ariel-bentu/alarmSystem/docs/superpowers/plans/2026-08-19-local-web-server.md

# Local Web Server (Arm/Disarm + Sensor Simulator) Implementation Plan

> **For agentic workers:** REQUIRED SUB-SKILL: Use superpowers:subagent-driven-development (recommended) or superpowers:executing-plans to implement this plan task-by-task. Steps use checkbox (`- [ ]`) syntax for tracking.

**Goal:** Add a LAN-reachable local web server (`http://local.alarm`, no auth)
that lets a user arm/disarm the device and simulate a sensor RF trigger
without WiFi internet access or CC1101 hardware, running during normal
operation (not just AP-provisioning mode), toggleable via a new
EEPROM-persisted flag that defaults on.

**Architecture:** New `LocalWebServer` class (`ESP8266WebServer` +
`ESP8266mDNS`), mirroring the existing `ProvisioningPortal`/`setup_page.h`
pattern but running in STA mode alongside normal operation. The simulate-
trigger endpoint calls a new shared `handleSensorEvent()` function extracted
from `main.cpp`'s existing CC1101-decode path, so simulated triggers exercise
the exact same `AlarmState` → `RelaySiren` → `CloudClient::reportEvent`
pipeline a real RF packet would. `EepromStore`'s persisted blob gains a
`localWebEnabled` bool alongside `armed`/`Config`; the magic number bumps
since this is a breaking format change (acceptable — no device is
provisioned yet).
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
