ariel-bentu/alarmSystem/firmware/edge/device/src/main.cpp

#include <Arduino.h>
#include <time.h>

#include "platform_compat.h"

#include "alarm_state.h"
#include "camera_client.h"
#include "camera_gate.h"
#include "cc1101_receiver.h"
#include "cloud_client.h"
#include "eeprom_store.h"
#include "fw_version.h"
#include "kerui_event.h"
#include "local_web_server.h"
#include "ota_updater.h"
#include "provision_store.h"
#include "provisioning_portal.h"
#include "remote_control.h"
#include "siren_address.h"
#include "relay_siren.h"
#include "stall_monitor.h"

#ifndef FIREBASE_WEB_API_KEY
#define FIREBASE_WEB_API_KEY "REPLACE_WITH_PROJECT_WEB_API_KEY"
#endif

namespace {
const uint8_t kForcePortalPin = 0;  // GPIO0 / FLASH button
const unsigned long kWifiConnectTimeoutMs = 15000;

ProvisionStore provisionStore;
ProvisioningPortal portal;
bool portalActive = false;

// Pin map. The two targets share no numbering, so keep them apart.
//
// ESP32-S3 (esp32-s3-devkitc-1, probed: quad SPI flash + embedded 8MB
// PSRAM). Pins avoided and why:
//   - GPIO26-32  : reserved for the SPI flash / PSRAM bus. Using them
//                  breaks the board in ways that look like random crashes.
//   - GPIO33-37  : left alone too. Free on a quad part, but taken by an
//                  octal PSRAM bus, and this module has embedded PSRAM
//                  whose wiring is not exposed — not worth the risk.
//   - GPIO0      : BOOT strapping pin, already used for kForcePortalPin.
//   - GPIO3,45,46: strapping (JTAG source / VDD_SPI / boot mode).
//   - GPIO19,20  : native USB D-/D+, which is our serial console.
//   - GPIO43,44  : UART0 TX/RX.
//   - GPIO35,36,37 on some N8R8 modules are consumed by PSRAM — see above.
//
// Hardware SPI (FSPI) defaults on this variant: SCK 12, MISO 13, MOSI 11.
// Those are wired to the CC1101 as SCK/SO/SI and are NOT configurable
// here — SPI.begin() claims them. Only CS and GDO0 are chosen below, from
// the safe low bank.
#if defined(ARDUINO_ARCH_ESP32)
const uint8_t kCc1101CsPin = 10;    // FSPI default SS
const uint8_t kCc1101Gdo0Pin = 4;   // any free digital input
const uint8_t kRelayPin = 5;        // free digital output
#else
const uint8_t kCc1101CsPin = 15;    // D8 — confirm against final wiring during hardware bring-up
const uint8_t kCc1101Gdo0Pin = 4;   // D2 — confirm against final wiring during hardware bring-up
const uint8_t kRelayPin = 5;        // D1 — confirm against final wiring during hardware bring-up
#endif

EepromStore eepromStore;
AlarmState alarmState;
Cc1101Receiver cc1101;
RelaySiren siren;
CloudClient cloudClient;
OtaUpdater otaUpdater;
// The outcome of an update installed before this boot ("ok" / "rolled_back")
// is reported once the cloud is reachable — see handleOta().
bool otaOutcomeReported = false;
uint8_t otaLastReportedPct = 0;
LocalWebServer localWebServer;

bool armed = false;
bool localWebEnabled = true;
Config config;

// Per-family snapshot-capture cooldown (CameraGate::shouldCapture's
// lastCaptureMs). RAM only, deliberately: "survives nothing" is correct — a
// reboot should allow an immediate capture, not inherit a stale cooldown
// from before the restart. Indexed by the sensor's position in
// config.sensors[], which has up to 16 entries (Config::sensors). 0 means
// "never captured", matching CameraGate::shouldCapture's own sentinel.
uint32_t lastCaptureMs[16] = {};

// Which input last changed the arm state, reported to state/armed_by so the
// Telegram alert can name it ("remote" vs "local" vs "cloud"). A fixed-code
// remote is replayable, so attribution is the only available mitigation —
// see the design doc's Security section.
const char* armedBySource = "cloud";

// Backing store for the "remote:XXXXX" form of the above, which names WHICH
// remote rather than just "a remote". The cloud resolves the identity to the
// remote's user-given name (parseArmSource in deviceArmNotify.ts); the device
// deliberately does not know names, so renaming one needs no device round-trip
// and the thin RTDB config stays unchanged.
//
// File-scope, not a local: armedBySource is a BORROWED pointer that
// applyArmedCommand() dereferences after handleRemotePacket() has returned,
// so a stack buffer here would dangle. 20 bytes covers "remote:" + 5 hex
// digits + NUL with room to spare.
char remoteArmedBySource[20];

// Non-blocking remote pairing window; 0 = closed. Deliberately NOT modelled
// on runSirenPairing(), which blocks the loop for 10s and leaves the alarm
// deaf to sensors. Remote pairing is receive-only, so it needs no blocking
// at all: it is a deadline checked inside the packet path.
unsigned long remotePairUntilMs = 0;
constexpr unsigned long kRemotePairWindowMs = 30000UL;

// mDNS and configTime()'s SNTP setup are both deferred until the first
// mint attempt settles. Two theories motivated this originally (DNS
// contention, then heap headroom) and BOTH were wrong — the mint crash was
// cont-stack exhaustion, fixed by the noinline attributes above. Kept
// anyway: both allocate, and there is no reason to do that work before the
// device has authenticated. LAN arm/disarm-by-IP works from boot
// regardless, since the web server itself is unaffected.
bool mdnsStarted = false;
unsigned long normalOperationStartMs = 0;
constexpr unsigned long kDnsUsersStartFallbackMs = 60000UL;  // start anyway if cloud never comes up

// Reported once per boot, strictly after the cloud is actually ready (not
// merely "settled" — that fallback also fires if the cloud never comes up,
// in which case there is nothing to report to). A later Cloud Function
// reads this to show the address in the web UI. Kept out-of-line and
// gated by a bool so it costs nothing on the other ~thousands of loop()
// iterations per boot — see handleSensorEvent()'s note on why frame size
// in loop() matters on this hardware.
bool sirenAddressReported = false;
// Retry pacing for the siren-address report. It is only latched on a
// CONFIRMED write (see reportSirenAddressOnce), so a device that is
// momentarily too low on contiguous heap tries again rather than giving up —
// but at this interval, not on every loop iteration.
unsigned long lastSirenAddressReportMs = 0;
static constexpr unsigned long kSirenAddressRetryMs = 60000UL;
// True between reporting an alarm to the cloud and clearing state/siren_active
// again. See the falling-edge clear in loop().
bool alarmReportedToCloud = false;

// Identity of the trigger CURRENTLY sustaining the siren, for matching the
// cloud's false-positive advisory (/commands/fp = {rfId, ts}).
//
// AlarmState::TriggerCause (alarm_state.h) only stores the 20-bit FAMILY and
// no timestamp at all, so it cannot be compared against the advisory, which
// is keyed by the FULL 24-bit rfId and an epoch-ms ts — the same {rfId, ts}
// used for the /events key and the snapshot upload path. This is why that
// identity is captured separately, here, at the moment the siren is turned
// on for a sensor trigger (handleSensorEvent) rather than read back out of
// AlarmState.
//
// Empty rfId means "no active trigger to match" — cleared whenever the siren
// goes idle (loop()'s falling edge) and whenever an advisory consumes it, so
// a stale identity can never be matched against a LATER, unrelated alarm.
char activeAlarmRfId[11] = {};
uint64_t activeAlarmTs = 0;

// Identity of the most recent ARMED trigger, whether or not it alarmed.
//
// Distinct from activeAlarmRfId/activeAlarmTs above, which are only set when a
// siren activation actually STARTED. A breach advisory arrives precisely when
// no alarm fired — the cloud's judge is what decided there should be one — so
// it has no active alarm to match against and needs this instead.
//
// RAM only, like lastCaptureMs[]: "survives nothing" is correct, because a
// reboot means there is no in-flight trigger for an advisory to confirm.
char lastTriggerRfId[11] = {};
uint64_t lastTriggerTs = 0;

// A siren DEFERRED by Config::sirenHoldSec, waiting for the cloud's AI judge
// to rule the trigger a false positive before it sounds.
//
// Only ever set for a sensor whose SensorConfig::definiteBreach is false. The
// identity above is populated at the same moment, so the existing
// false-positive advisory match cancels a pending siren exactly as it stops a
// sounding one — the advisory path needs no new matching logic.
//
// 0 means "nothing pending". Deliberately a millis() deadline rather than a
// countdown: tickPendingSiren() is called from loop() and must not depend on
// how often that happens.
//
// IT EXPIRES AND FIRES. Everything that can go wrong cloud-side (offline,
// NVR down, judge error, lost upload) ends with the siren sounding late
// rather than never — see Config::sirenHoldSec.
unsigned long pendingSirenDeadlineMs = 0;
unsigned long lastHeartbeatMs = 0;
static constexpr unsigned long kHeartbeatIntervalMs = 10000UL;

// Watchdog budget. Must exceed the longest LEGITIMATE blocking stretch in
// the firmware, or a healthy device reboots itself: connectToWifi() 15s,
// the mint response wait 15s, runSirenPairing() 10s. Those all call
// platformFeedWatchdog() as they go, so the real requirement is just that
// this comfortably exceeds one loop() iteration.
//
// RAISED 30 -> 60. The binding stretch is NOT any of the above: it is the
// synchronous FirebaseClient poll/write inside cloudClient.loop(), which
// blocks WITHOUT feeding the watchdog (its internal wait calls delay(0),
// which yields to FreeRTOS but does not reset the TWDT). That is now capped
// at CloudClient::kSyncTimeoutSec — see the long note there.
//
// At 30s this constant EQUALED the library's own default socket timeout, so
// a single stalled poll could burn the whole budget and reboot a healthy
// device. The budget must clear the worst legitimate case, which is
// reportAlarm(): TWO sequential blocking set() calls, i.e. 2x kSyncTimeoutSec
// plus the surrounding loop work. 60s leaves ample margin while still
// catching a genuine hang within a minute.
static constexpr uint32_t kWatchdogTimeoutSec = 60;

// Boot cause is reported once, after the cloud comes up. Same gating shape
// as sirenAddressReported — strictly isReady(), since there is nothing to
// report to otherwise.
bool bootReported = false;

// Steady-state WiFi supervision. setup() connects, but until now NOTHING
// re-checked the link afterwards: loop() trusted WiFi.setAutoReconnect(true)
// with no fallback, so a device whose auto-reconnect failed to re-associate
// stayed silently offline until a human noticed. The alarm itself keeps
// working (siren, EEPROM, LAN are all local), but remote arm/disarm and
// every cloud alert are gone, which is a large silent failure.
unsigned long lastWifiCheckMs = 0;
static constexpr unsigned long kWifiCheckIntervalMs = 30000UL;
// Grace period before intervening. WiFi.begin() is asynchronous and the SDK
// does its own reconnect attempts; reconnecting on the first missed check
// would fight it and could thrash the radio.
unsigned long wifiDownSinceMs = 0;
static constexpr unsigned long kWifiDownGraceMs = 120000UL;

// When to give up nudging and reboot. TWO HOURS, deliberately — this is NOT
// a "connectivity is broken, restart it" timer.
//
// An offline device still fully protects the premises: RF decode, rule
// evaluation, the siren and EEPROM arm state are all local and cloud-
// independent by design (see CLAUDE.md's Key Decisions). A router reboot,
// an ISP outage or a moved AP must NOT cost anything, and a reboot is
// strictly worse than staying up — every restart is a window in which no
// sensor is being watched at all, and a short timer during a long outage
// turns that into a loop.
//
// So the reboot exists only for the case a nudge cannot fix: a wedged radio
// or a driver stuck past any plausible outage. At 2h the local alarm has had
// every chance to keep working, and the one-off ~15s restart is a fair price
// for recovering a device that would otherwise stay offline indefinitely.
static constexpr unsigned long kWifiDownRebootMs = 2UL * 60UL * 60UL * 1000UL;

__attribute__((noinline))
void reportSirenAddressOnce() {
  char addrHex[9];
  // "0x%06X" — upper-case and zero-padded to six digits. This EXACT form is
  // what onSirenAddress stores in Firestore (canonicalSirenAddress produces
  // the same string), so a re-report on the next boot compares equal and
  // does not rewrite the project doc. Changing this format would make every
  // reboot trigger a config rebuild and an RTDB push.
  snprintf(addrHex, sizeof(addrHex), "0x%06X", (unsigned int)config.sirenBaseAddress);
  // Latch ONLY on a confirmed write. reportEvent silently skips when
  // contiguous heap is below its floor, and this particular event is what
  // persists the device's siren identity to Firestore — marking it done
  // after a skipped write would strand the address on-device forever. On a
  // failure we simply retry on a later loop.
  sirenAddressReported =
      cloudClient.reportEvent("SIREN0", "siren_address", false, 0, addrHex);
}

void startMdnsIfNeeded() {
  if (mdnsStarted || !localWebEnabled) return;
  // Single DNS label, no embedded dot. The previous "local.alarm" advertised
  // as "local.alarm.local", which is not a valid one-label mDNS hostname —
  // macOS/Bonjour would not resolve it (verified: curl and ping both failed
  // while the device was serving fine on its IP).
  if (MDNS.begin("alarm")) {
    // Advertise the HTTP service too, not just the hostname: some clients
    // (and Bonjour browsers) discover via _http._tcp rather than resolving
    // the A record directly.
    MDNS.addService("http", "tcp", 80);
    Serial.println("mDNS responder started: http://alarm.local "
                    "(exact resolution depends on OS/browser mDNS support)");
  } else {
    Serial.println("mDNS responder failed to start — local web server "
                    "still reachable via IP");
  }
  mdnsStarted = true;
}

// Wall-clock sync for event timestamps (cloud_client.cpp's reportEvent()
// uses time(nullptr) for the RTDB event key so onSensorEvent.ts's
// Timestamp.fromMillis() reflects real time, not device uptime). Deferred
// alongside mDNS — see the note above for why that deferral is retained.
bool ntpStarted = false;

void startNtpSyncIfNeeded() {
  if (ntpStarted) return;
  configTime(0, 0, "pool.ntp.org", "time.nist.gov");
  ntpStarted = true;
}

// Shared by the real CC1101 decode path (loop()) and LocalWebServer's
// simulate-trigger endpoint — both must exercise the exact same
// alarm-evaluation pipeline, not a duplicated shortcut.
//
// noinline is load-bearing on ESP8266, not a hint. (On ESP32 loop() is a
// normal FreeRTOS task with an 8KB+ stack, so it costs nothing there and is
// kept for a single code shape.) loop() runs on the 4KB cont stack
// and is entered with ~1568 bytes left. When GCC inlines helpers like this
// one into loop(), their locals (String temporaries, JSON buffers, a ~2.4KB
// Config) merge into loop()'s single frame, which is allocated in full on
// entry regardless of which branch actually runs. That left BearSSL's TLS
// handshake ~992 bytes and produced the long-standing Soft WDT reset.
// Keeping these out-of-line means each frame exists only while its call is
// on the stack, and the mint (called near the top of loop()) sees ~3.5KB.
// Measured: inlined 992 bytes -> crash; out-of-line 3504 bytes -> connects.
// familyId: the sensor's 20-bit identity ("0x0061D"), which is what alarm
// rules match on. rfId: the full 24-bit code as received ("0x0061DA"), which
// is what gets written to /events — the event code IS the information there,
// and the pairing UI reads those keys.
//
// `event` is the decoded event name from kerui_event.h. UNKNOWN nibbles are
// reported as "trigger" by keruiEventName, so an unrecognised code is never
// silently dropped — the smoke detector's 0x2 depends on exactly that.
__attribute__((noinline))
void handleSensorEvent(const char* familyId, const char* rfId, const char* event,
                       unsigned long now, bool batteryLow = false, int rssi = 0) {
  TriggerCause cause;
  bool shouldFire = alarmState.onSensorEvent(familyId, now, &cause);
  // "armed but nothing happened" is otherwise silent and indistinguishable
  // from a broken decode; one line per trigger makes the decision visible.
  Serial.printf("[alarm] %s (%s %s) armed=%d fire=%d sirenEnabled=%d\n",
                familyId, rfId, event, config.armed, shouldFire,
                config.sirenEnabled);
  // ONE timestamp for the whole trigger, computed here (not re-read later),
  // so reportEvent's /events key, the snapshot upload path, AND the
  // false-positive-advisory match below all agree on the exact same
  // {rfId, ts} — the correlation key the cloud joins everything by. Same
  // epoch-ms source reportEvent()/uploadSnapshot() use internally
  // (time(nullptr) * 1000); uint64_t, NOT uint32_t, for the same overflow
  // reason documented on CloudClient::uploadSnapshot().
  const uint64_t triggerTs = (uint64_t)time(nullptr) * 1000ULL;

  // Record this trigger's identity whether or not it alarms. A breach advisory
  // arrives for a trigger that did NOT alarm — that is the whole point of it —
  // so the advisory matcher has nothing else to compare against. Only while
  // armed: a disarmed trigger has no alarm for the cloud to raise.
  if (config.armed) {
    strncpy(lastTriggerRfId, rfId, sizeof(lastTriggerRfId) - 1);
    lastTriggerRfId[sizeof(lastTriggerRfId) - 1] = '\0';
    lastTriggerTs = triggerTs;
  }

  if (shouldFire && config.sirenEnabled) {
    // Hold the siren for a NON-definite sensor, giving the cloud's AI judge
    // time to call the trigger a false positive before the whole street
    // hears it. A definite sensor — and any sensor at all when no hold is
    // configured — sounds immediately, exactly as before.
    //
    // The hold is a DEADLINE, not a dependency: tickPendingSiren() fires the
    // siren when it expires whether or not the cloud ever answered. Offline,
    // NVR down, judge errored, upload lost — the siren still sounds, just
    // late. Alarm logic must never depend on the cloud (CLAUDE.md).
    const bool hold = config.sirenHoldSec > 0 &&
                      !alarmState.isDefiniteBreachFamily(familyId);
    if (hold) {
      pendingSirenDeadlineMs = now + (unsigned long)config.sirenHoldSec * 1000UL;
      // Never 0: that is the "nothing pending" sentinel, and a deadline that
      // landed exactly on a millis() rollover would otherwise cancel itself.
      if (pendingSirenDeadlineMs == 0) pendingSirenDeadlineMs = 1;
      Serial.printf("[alarm] siren HELD %us for non-definite %s\n",
                    config.sirenHoldSec, familyId);
    } else {
      siren.turnOn(config.sirenDurationSec, now);
    }
    // Record what this siren activation is FOR, so a later false-positive
    // advisory ({rfId, ts}) can be checked against the trigger that is
    // actually sounding it, instead of blindly silencing whatever happens to
    // be active. STRICTLY for that match — never read by anything that
    // could use it to raise an alarm.
    //
    // Set for a HELD siren too, and that is what lets the existing advisory
    // path cancel a pending siren with no new matching logic.
    strncpy(activeAlarmRfId, rfId, sizeof(activeAlarmRfId) - 1);
    activeAlarmRfId[sizeof(activeAlarmRfId) - 1] = '\0';
    activeAlarmTs = triggerTs;
  }
  // triggerTs passed explicitly, NOT re-read inside reportEvent: the /events
  // key must equal the snapshot path's ts or the cloud cannot join the
  // timeline doc to the event row. Two independent time(nullptr) reads
  // straddled a second boundary on 2026-10-05 and produced 19:24:44 vs
  // 19:24:45, which the web UI rendered as a "manual capture". The comment on
  // triggerTs above always claimed this; now it is true.
  cloudClient.reportEvent(rfId, event, batteryLow, rssi, nullptr, triggerTs);
  // Reported whenever the alarm fires, NOT gated on sirenEnabled: turning the
  // siren off is a noise preference, not a "stop telling me about intrusions"
  // one. Gating both on it produced a silent alarm — no siren AND no Telegram
  // — which is precisely when the notification matters most.
  // Written after the event so the timeline entry exists before the alert.
  if (shouldFire) {
    cloudClient.reportAlarm(cause.rfId, cause.conditionType);
    alarmReportedToCloud = true;
  }

  // --- Camera snapshot capture, STRICTLY AFTER the block above ---
  //
  // Everything that matters for the alarm itself (rule evaluation, the
  // siren, the event report, the alarm report) is already done by this
  // point. Capture runs last and can never delay or gate any of it: a slow
  // or failed NVR grab / Storage upload only costs a missing photo, never a
  // late siren or a dropped alarm report. This is the design spec's second
  // large-TLS path (the first is reportEvent/reportAlarm's RTDB writes) and
  // carries the same watchdog/socket-death risk documented in
  // docs/history/ — kept best-effort and bounded for exactly that reason.
  //
  // Find the paired SensorConfig for this family. An unpaired/unknown sensor
  // (no match) must NOT capture — shouldCapture() needs the per-sensor
  // cameraMask that only exists once paired, and an unpaired trigger is
  // already just logged elsewhere.
  int sensorIndex = -1;
  for (uint8_t i = 0; i < config.sensorCount && i < 16; i++) {
    if (strcmp(config.sensors[i].familyId, familyId) == 0) {
      sensorIndex = i;
      break;
    }
  }
  if (sensorIndex >= 0) {
    const SensorConfig& sensor = config.sensors[sensorIndex];
    if (CameraGate::shouldCapture(config, sensor, cloudClient.isReady(), now,
                                  lastCaptureMs[sensorIndex], shouldFire)) {
      // Reuses triggerTs (computed once, above) rather than re-reading
      // time(nullptr) here — this is the SAME {rfId, ts} as the
      // /events/{rfId}/{ts} key reportEvent() just wrote AND the
      // activeAlarmRfId/activeAlarmTs record above, so the cloud can join
      // the event, the snapshot, and (if it comes back false-positive) the
      // advisory it writes, all by this one key with no extra signalling.
      const uint64_t snapshotTs = triggerTs;

      uint8_t channels[CameraGate::kMaxChannels];
      uint8_t channelCount = 0;
      CameraGate::channelsFor(sensor, channels, channelCount);

      // WATCHDOG: this loop is the one place in the whole capture path that
      // can run long enough to matter. A sensor with every channel selected
      // (cameraMask 0xFF) means up to 8 iterations — up from 3 when the mask
      // replaced a single channel, so the worst case here GREW — each with an
      // ~8s CameraClient::grab() (its own IoDeadline) followed by an
      // up-to-~20s CloudClient::uploadSnapshot() (bounded by the shared data
      // client's kHandshakeTimeoutSec/kSocketTimeoutSec/kSyncTimeoutSec) —
      // worst case ~224s in this one handleSensorEvent() call. The task
      // watchdog budget is kWatchdogTimeoutSec = 60s and is fed only once
      // per loop() iteration (top of loop()), so without explicit feeds here
      // a slow-but-progressing NVR plus a cold/reconnecting data client
      // could exceed 60s and panic-reboot the device — right after a real
      // alarm trigger, which is the worst possible moment. This is the exact
      // failure class docs/history/tls-handshake-watchdog-reboot.md and
      // cloud_client.cpp's mintCustomToken() response-wait loop both guard
      // against: feed explicitly before every stretch that can block for
      // seconds, same idiom as mintCustomToken()'s
      // `while (...) { platformFeedWatchdog(); ... }`. Feeding before BOTH
      // calls (not just once per channel) means no single grab-or-upload
      // stretch (each individually well under 60s) ever accumulates
      // unfed — only the SUM across channels was the risk, and that sum is
      // now fed through on every step.
      uint8_t uploaded = 0;
      for (uint8_t c = 0; c < channelCount; c++) {
        platformFeedWatchdog();
        std::vector<uint8_t> buf;
        if (!CameraClient::grab(config, channels[c], buf)) continue;
        platformFeedWatchdog();
        if (cloudClient.uploadSnapshot(rfId, snapshotTs, channels[c],
                                       buf.data(), buf.size())) {
          uploaded++;
        }
      }
      // Cooldown starts on this ATTEMPT, not only on success: a camera or
      // NVR that is down should not be hammered with a retry on every
      // single trigger in the meantime — the next normal-cadence trigger
      // after the cooldown gets another try regardless.
      lastCaptureMs[sensorIndex] = now;
      Serial.printf("[camera] %s capture attempt: %u/%u channel(s) uploaded\n",
                    familyId, uploaded, channelCount);
    }
  }
}

// Entry-delay expiry. Out-of-line and called from loop() so its TriggerCause
// never joins loop()'s single merged frame — see handleSensorEvent()'s note.
__attribute__((noinline))
void pollEntryDelay(unsigned long now) {
  TriggerCause cause;
  if (!alarmState.tickEntryDelay(now, &cause)) return;
  if (config.sirenEnabled) {
    siren.turnOn(config.sirenDurationSec, now);
  }
  // Not gated on sirenEnabled — see handleSensorEvent()'s note.
  cloudClient.reportAlarm(cause.rfId, cause.conditionType);
  alarmReportedToCloud = true;
}

// Fire a siren whose hold has expired without the cloud vouching for the
// trigger.
//
// This is the FAIL-LOUD half of the siren hold, and the reason the hold is
// safe to have at all: a non-definite sensor's siren is delayed by
// Config::sirenHoldSec, but nothing about that delay depends on the cloud
// answering. Every way the verdict can fail to arrive — no WiFi, NVR down,
// judge error, dropped snapshot upload, cloud simply slow — ends here, with
// the siren sounding sirenHoldSec late instead of never.
//
// A matching false-positive advisory cancels the deadline before it expires
// (see the advisory block in loop()); a disarm clears it via
// applyArmedCommand/cancelPendingSiren.
void tickPendingSiren(unsigned long now) {
  if (pendingSirenDeadlineMs == 0) return;
  // Subtraction, not `now >= deadline`: millis() wraps every ~49 days and the
  // comparison would then be false for the whole second half of the range.
  // The same idiom the rest of this file uses for timed work.
  if ((long)(now - pendingSirenDeadlineMs) < 0) return;
  pendingSirenDeadlineMs = 0;
  if (!config.sirenEnabled) return;
  Serial.printf("[alarm] siren hold expired with no verdict — sounding for %s\n",
                activeAlarmRfId);
  siren.turnOn(config.sirenDurationSec, now);
}

// Drop a pending siren without sounding it. Used by the false-positive
// advisory (the cloud vouched for the trigger) and by disarm (the owner is
// home; a held siren must not go off behind them).
void cancelPendingSiren() {
  pendingSirenDeadlineMs = 0;
}

// Shared by the cloud arm/disarm command path and LocalWebServer's
// arm/disarm endpoints — both must update state, alarm evaluation, siren,
// and EEPROM persistence identically.
// noinline for the cont-stack reason documented on handleSensorEvent().
__attribute__((noinline))
void applyArmedCommand(bool newArmed) {
  armed = newArmed;
  config.armed = armed;
  alarmState.setConfig(config);
  if (!armed) {
    alarmState.disarm();
    siren.turnOff();
    // A siren still inside its hold must not sound after a disarm: the owner
    // is home, and turnOff() alone would leave the deadline armed to fire
    // seconds later.
    cancelPendingSiren();
  }
  eepromStore.save(armed, localWebEnabled, config);
  cloudClient.reportArmedState(armed, armedBySource);
  // Reset to the default so a stale source cannot mislabel the NEXT change:
  // callers that care (remote, local web) set it immediately before calling.
  armedBySource = "cloud";
}

// The CC1101 poll and the config-update handler both carry large locals
// (KeruiPacket + decoder buffers; a ~2.4KB Config). Held out-of-line so
// their frames never become part of loop()'s always-allocated frame — see
// handleSensorEvent()'s note for the full reasoning and measurements.
// Route a decoded packet that belongs to a paired remote. Returns true when
// the packet was consumed, so the caller must NOT fall through to the sensor
// path — a remote must never be able to trigger an alarm rule.
//
// noinline for the cont-stack reason documented on handleSensorEvent(): it
// touches the ~2.4KB Config, and that frame must not join loop()'s
// always-allocated one.
__attribute__((noinline))
bool handleRemotePacket(uint32_t code, unsigned long now) {
  uint32_t identity = remoteIdentityOf(code);

  // Pairing window: the first code heard here is adopted. Checked before the
  // paired-lookup so a fresh remote can be learned; an ALREADY paired one
  // falls through to normal dispatch rather than being swallowed.
  if (remotePairUntilMs != 0) {
    if ((long)(now - remotePairUntilMs) >= 0) {
      remotePairUntilMs = 0;  // window expired
      localWebServer.setRemotePairStatus("expired");
    } else {
      RemotePairResult result = remotePair(&config, identity, armed);
      remotePairUntilMs = 0;  // one decision per window, whatever the outcome
      switch (result) {
        case RemotePairResult::Paired:
          eepromStore.save(armed, localWebEnabled, config);
          cloudClient.reportEvent("REMOTE", "paired", false, 0);
          Serial.printf("[remote] paired 0x%05X\n", (unsigned)identity);
          localWebServer.setRemotePairStatus("paired");
          return true;
        case RemotePairResult::AlreadyPaired:
          localWebServer.setRemotePairStatus("already paired");
          break;  // fall through to normal dispatch below
        case RemotePairResult::RefusedArmed:
          localWebServer.setRemotePairStatus("refused: system armed");
          Serial.println("[remote] pairing refused — system is armed");
          break;
        case RemotePairResult::Full:
          localWebServer.setRemotePairStatus("refused: no free slots");
          Serial.println("[remote] pairing refused — all 8 slots used");
          break;
      }
    }
  }

  if (!remoteIsPaired(config, identity)) return false;

  RemoteAction action = remoteActionFor(remoteNibbleOf(code));
  Serial.printf("[remote] 0x%05X button=0x%X action=%d\n", (unsigned)identity,
                remoteNibbleOf(code), (int)action);

  // "remote:E45CA" rather than a bare "remote", so the cloud can say WHICH
  // remote disarmed the house instead of just that one did. Formatted once
  // here for both arm and disarm; %05X matches how identities are printed
  // above and stored in Firestore ("0xE45CA", compared case-insensitively
  // with the prefix stripped — see parseArmSource).
  snprintf(remoteArmedBySource, sizeof(remoteArmedBySource), "remote:%05X",
           (unsigned)identity);

  switch (action) {
    case RemoteAction::Arm:
      // Arms with whatever config is currently loaded. The remote does NOT
      // select a profile — see the design doc.
      armedBySource = remoteArmedBySource;
      applyArmedCommand(true);
      break;
    case RemoteAction::Disarm:
      armedBySource = remoteArmedBySource;
      applyArmedCommand(false);
      break;
    case RemoteAction::Sos:
      // Fires regardless of arm state — a panic button gated on armed is
      // useless. Still honours sirenEnabled, which is a noise preference.
      if (config.sirenEnabled) {
        siren.turnOn(config.sirenDurationSec, now);
      }
      cloudClient.reportAlarmLabel("SOS (remote)");
      alarmReportedToCloud = true;
      break;
    case RemoteAction::ArmHome:
      // "S" is decoded deliberately and does nothing, so an unmapped button
      // is visibly ignored rather than silently falling through to the
      // sensor path.
      Serial.println("[remote] arm-home (S) ignored");
      break;
    case RemoteAction::None:
      Serial.println("[remote] unrecognised button nibble, ignored");
      break;
  }
  return true;
}

// Route one decoded 24-bit code by its event nibble. Shared by the RF path
// and the local web simulator, so a simulated tamper behaves exactly like a
// real one — the simulator's whole purpose is to exercise this logic without
// waving a magnet at a sensor.
//
// noinline for the cont-stack reason documented on handleSensorEvent().
__attribute__((noinline))
void dispatchSensorCode(uint32_t code, unsigned long now, bool batteryLow,
                        int rssi) {
  char rfIdHex[11];
  char familyHex[9];
  // The FULL code is what gets written to /events — the pairing UI reads
  // those keys, and the event nibble is the information there. 0x-prefixed
  // to match the format used everywhere else (Firestore sensor.rfId,
  // buildConfig.ts, smoke scripts).
  snprintf(rfIdHex, sizeof(rfIdHex), "0x%06X", code);
  // The FAMILY is what alarm rules match on — see SensorConfig::familyId.
  // %05X so it is the same canonical form the cloud stores and compares.
  snprintf(familyHex, sizeof(familyHex), "0x%05X", keruiFamilyOf(code));

  const KeruiEvent event = keruiEventOf(keruiNibbleOf(code));
  switch (event) {
    case KeruiEvent::TAMPER: {
      // TAMPER SIRENS EVEN WHILE DISARMED, and never goes through rule
      // evaluation. That is the threat: an intruder disabling sensors before
      // a break-in does it while the house is empty and the system may well
      // be disarmed. This mirrors the existing `always` rule semantics
      // (smoke, gas) rather than inventing a second mechanism.
      //
      // Only for a PAIRED sensor — an unpaired tamper is logged and left for
      // pairing, exactly as an unpaired trigger is. Still honours
      // sirenEnabled, which is a noise preference, not a security one.
      //
      // Accepted cost: changing a PIR battery sounds the siren. There is no
      // suppression mechanism by design; silence it with Disarm.
      const bool paired = alarmState.isPairedFamily(familyHex);
      Serial.printf("[alarm] %s TAMPER paired=%d sirenEnabled=%d\n", familyHex,
                    paired, config.sirenEnabled);
      cloudClient.reportEvent(rfIdHex, keruiEventName(event), batteryLow,
                              rssi);
      if (paired) {
        if (config.sirenEnabled) {
          siren.turnOn(config.sirenDurationSec, now);
        }
        // Not gated on sirenEnabled — see handleSensorEvent()'s note: a
        // silent siren is a noise preference, not "stop telling me".
        cloudClient.reportAlarm(familyHex, /*conditionType=*/0);
        alarmReportedToCloud = true;
      }
      break;
    }
    case KeruiEvent::WATER:
    case KeruiEvent::BATTERY_LOW:
    case KeruiEvent::CLOSE:
      // Reported and nothing else: no siren, no rule evaluation. The cloud
      // decides what (if anything) to notify — water and battery-low alert
      // once per condition, close drives nothing at all.
      Serial.printf("[alarm] %s %s (reported only)\n", familyHex,
                    keruiEventName(event));
      cloudClient.reportEvent(rfIdHex, keruiEventName(event), batteryLow,
                              rssi);
      break;
    case KeruiEvent::TRIGGER:
    case KeruiEvent::UNKNOWN:
      // UNKNOWN reports as "trigger" and runs the rules exactly as today, so
      // an unrecognised nibble is never silently dropped. The smoke detector
      // (nibble 0x2, never once fired in 3,089 events) depends on this.
      handleSensorEvent(familyHex, rfIdHex, keruiEventName(event), now,
                        batteryLow, rssi);
      break;
  }
}

__attribute__((noinline))
void pollCc1101(unsigned long now) {
  KeruiPacket packet{};
  int rssi;
  if (!cc1101.poll(&packet, &rssi)) return;
  // Log every decoded packet so RF receive can be verified independently of
  // the cloud path (reportEvent may be skipped on low heap). The family and
  // nibble are printed separately because "which sensor" and "what it did"
  // are now two different questions.
  Serial.printf("[cc1101] packet sensorId=0x%06X family=0x%05X nibble=0x%X "
                "battery=%d rssi=%d\n",
                packet.sensorId, packet.familyId, packet.eventNibble,
                packet.batteryLow, rssi);
  // Before the sensor path: a paired remote is a CONTROL device, not a
  // trigger. Returning here keeps it out of the sensor dispatch entirely, so
  // it cannot satisfy an alarm rule or be written to /events as a trigger.
  if (handleRemotePacket(packet.sensorId, now)) return;
  dispatchSensorCode(packet.sensorId, now, packet.batteryLow, rssi);
}

__attribute__((noinline))
void applyPendingConfigUpdate() {
  Config newConfig;
  if (!cloudClient.consumeConfigUpdate(&newConfig)) return;
  newConfig.armed = armed;  // armed is tracked separately from config pushes

  // Siren address: the DEVICE stays authoritative, with the cloud as a
  // recovery path — not the other way round.
  //
  // - local valid            -> keep local, ignore whatever the cloud sent.
  //   Never let a config push overwrite a working pairing.
  // - local empty + cloud has one -> ADOPT it. This is the whole point: an
  //   EEPROM wipe (magic bump, reflash) no longer costs the physical pairing,
  //   because Firestore kept the address the siren is actually bound to.
  // - neither                -> leave empty; maybeGenerateSirenAddress()
  //   mints one from loop() once we know the cloud has nothing.
  const bool hadLocalAddress = SirenAddress::isValid(config.sirenBaseAddress);
  if (hadLocalAddress) {
    newConfig.sirenBaseAddress = config.sirenBaseAddress;
  } else if (SirenAddress::isValid(newConfig.sirenBaseAddress)) {
    Serial.printf("[siren] adopted base address 0x%06lX from the cloud\n",
                  (unsigned long)newConfig.sirenBaseAddress);
  }
  // Remotes paired LOCALLY (via alarm.local, with no internet) exist on the
  // device before the cloud knows about them. A config push carrying an
  // empty or shorter m would otherwise erase them, so merge rather than
  // replace: keep any local identity the push does not already contain.
  for (uint8_t i = 0; i < config.remoteCount && i < Config::kMaxRemotes; i++) {
    if (newConfig.remoteCount >= Config::kMaxRemotes) break;
    if (!remoteIsPaired(newConfig, config.remotes[i])) {
      newConfig.remotes[newConfig.remoteCount++] = config.remotes[i];
    }
  }
  config = newConfig;
  alarmState.setConfig(config);
  // Keep the siren's copy of the preference current, or a disarm would still
  // emit its ack beep after the user switched the siren off in the UI.
  siren.setEnabled(config.sirenEnabled);
  // Push a newly adopted address into the live siren. begin() captured
  // whatever was in EEPROM at boot (possibly nothing), so without this the
  // adopted address would sit in config and not reach the radio until the
  // next reboot — the siren would stay silent for the rest of the session.
  if (!hadLocalAddress && SirenAddress::isValid(config.sirenBaseAddress)) {
    siren.setBaseAddress(config.sirenBaseAddress);
  }
  eepromStore.save(armed, localWebEnabled, config);
}

// Mint a siren identity, but ONLY once the cloud has been heard from and had
// nothing to offer. Called from loop().
//
// The ordering is the entire fix for the lost-pairing bug: generating eagerly
// at boot is what overwrote a still-valid cloud address after an EEPROM wipe.
// A device that has never had a siren, and a cloud that has no record of one,
// is the only case where a fresh address is correct.
//
// Reported up by the existing reportSirenAddressOnce() path, which is what
// gets it into Firestore via onSirenAddress.
__attribute__((noinline))
void maybeGenerateSirenAddress() {
  config.sirenBaseAddress = SirenAddress::generate();
  siren.setBaseAddress(config.sirenBaseAddress);
  alarmState.setConfig(config);
  eepromStore.save(armed, localWebEnabled, config);
  Serial.printf("[siren] no address on device or in cloud — generated "
                "0x%06lX\n",
                (unsigned long)config.sirenBaseAddress);
}

// Loop the base address on air so a siren held in learn mode can bind it.
// Blocking and largely deaf to sensors throughout — acceptable because
// pairing is a deliberate, user-initiated act, and the web UI says so
// before the user starts.
//
// 10s, measured: a real pairing succeeded well inside this window (the
// siren answered with its two-beep acknowledgement), and at one burst per
// 300ms that is still ~33 transmissions — ample for a siren already in
// learn mode. The window was originally 60s, which was simply a guess; it
// is a direct cost, since the device serves no HTTP and hears no sensors
// while it runs, so it is kept only as long as it needs to be.
//
// noinline for the cont-stack reason documented on handleSensorEvent().
__attribute__((noinline))
void runSirenPairing() {
  const unsigned long kPairingWindowMs = 10000UL;
  stallMonitorPhase("siren-pair");
  Serial.printf("[siren] pairing: looping 0x%06lX for 10s — press SET on the siren\n",
                (unsigned long)config.sirenBaseAddress);
  const unsigned long start = millis();
  while (millis() - start < kPairingWindowMs) {
    cc1101.transmit(config.sirenBaseAddress | SirenAddress::kCmdArmHome, 6);
    delay(300);
    platformFeedWatchdog();
  }
  Serial.println("[siren] pairing window closed");
  stallMonitorPhase("loop");
}

bool connectToWifi(const String& ssid, const String& password,
                    unsigned long timeoutMs) {
  Serial.print("Connecting to WiFi: ");
  Serial.println(ssid);
  // Shape only, never the secret: enough to tell "arrived intact" from
  // "truncated / empty / has stray whitespace from autofill", which are
  // indistinguishable from a plain association timeout.
  // Length alone cannot tell a correct 25-char password from a wrong one of
  // the same length, so add a cheap FNV-1a fingerprint plus first/last
  // characters. Not reversible, but enough to confirm the exact bytes that
  // reached the radio match what was typed: compute the same hash over the
  // intended string and compare.
  uint32_t fp = 2166136261u;
  for (size_t i = 0; i < password.length(); i++) {
    fp = (fp ^ (uint8_t)password[i]) * 16777619u;
  }
  Serial.printf("  ssid len=%u, password len=%u fp=%08X first='%c' last='%c'%s\n",
                ssid.length(), password.length(), fp,
                password.length() ? password[0] : '?',
                password.length() ? password[password.length() - 1] : '?',
                (password.length() > 0 &&
                 (password[0] == ' ' || password[password.length() - 1] == ' '))
                    ? " [WARNING: leading/trailing space]"
                    : "");
  // WiFi.mode() persists across reboots via the SDK's saved flash config, so
  // a device that previously ran the provisioning portal (WIFI_AP_STA) can
  // reboot straight into normal operation with the softAP radio still up.
  // Forcing WIFI_STA (as spike_mint/ does) guarantees a clean station-only
  // state and releases the softAP's memory. This did not by itself fix the
  // mint crash, but it is correct regardless.
  // Keep the AP up if the portal is serving. connectToWifi() is called from
  // two places: boot (no portal — plain STA is right) and the portal's save
  // handler. In the latter case forcing WIFI_STA tears the AP down for the
  // whole 15s attempt, so a user who just submitted the form sees the
  // network vanish under them and, on failure, has to rejoin to retry.
  // Staying in AP_STA keeps the portal reachable throughout.
  WiFi.mode(portalActive ? WIFI_AP_STA : WIFI_STA);

  // The ESP8266 build connected to this same network reliably with nothing
  // more than mode()+begin(), so the extra work below is ESP32-specific.
  //
  // The ESP32 caches WiFi config in NVS and reuses it on begin(). A stale or
  // half-written entry from an earlier failed attempt survives reboots and
  // reflashes (NVS is not touched by a firmware upload) and can keep
  // poisoning the association — which is consistent with the auth rejection
  // flipping between status=4 and status=6 on identical, correct
  // credentials. persistent(false) stops us writing new entries;
  // disconnect(true, true) clears the radio state and erases the stored one.
  //
  // setSleep(false) is separate: the ESP32's default power-save can make it
  // miss handshake frames, which presents as an auth failure rather than a
  // timeout.
  WiFi.persistent(false);
  // wifioff must stay false while the portal is serving, or the AP goes down
  // with the station and the user loses the page they just submitted.
  WiFi.disconnect(/*wifioff=*/!portalActive, /*eraseap=*/true);
  delay(200);
  if (portalActive) WiFi.mode(WIFI_AP_STA);  // restore if disconnect reset it
  WiFi.setSleep(false);
  WiFi.setAutoReconnect(true);

  // The SDK knows exactly why an association was refused; WiFi.status() only
  // reports that it was. Reason 15 (4WAY_HANDSHAKE_TIMEOUT) means the PSK is
  // being rejected, 201 (NO_AP_FOUND) means the BSSID was never reachable,
  // and 2/8/3 point at the AP dropping us. Printing it turns this from
  // inference into the AP's own answer.
#if defined(ARDUINO_ARCH_ESP32)
  WiFi.onEvent([](WiFiEvent_t, WiFiEventInfo_t info) {
    uint8_t r = info.wifi_sta_disconnected.reason;
    const char* meaning =
        r == 15  ? "4WAY_HANDSHAKE_TIMEOUT -> PSK rejected (wrong password)"
        : r == 201 ? "NO_AP_FOUND -> could not reach that BSSID"
        : r == 2   ? "AUTH_EXPIRE"
        : r == 4   ? "ASSOC_EXPIRE"
        : r == 8   ? "ASSOC_LEAVE"
        : r == 205 ? "CONNECTION_FAIL"
        : r == 3   ? "DEAUTH_LEAVING -> AP actively kicked us"
                   : "see esp_wifi_types.h";
    Serial.printf("  [wifi] disconnect reason=%u (%s)\n", r, meaning);
  }, ARDUINO_EVENT_WIFI_STA_DISCONNECTED);
#endif

  // Pick the STRONGEST BSSID for this SSID and target it explicitly.
  //
  // This network has two APs (mesh/repeater) broadcasting BENTU on the same
  // channel, consistently seen at ~-55dBm and ~-88dBm. Plain begin() leaves
  // the choice to the SDK, which can lock onto the distant one and then get
  // ignored at auth (reason=2 AUTH_EXPIRE) — indistinguishable from a
  // router-side refusal. Scanning first and pinning the BSSID removes that
  // ambiguity: if it still fails, the near AP really is refusing us.
#if defined(ARDUINO_ARCH_ESP32)
  int best = -1, bestRssi = -127;
  // Blocking scan, seconds long — feed the task watchdog either side. This
  // one runs on EVERY boot, not just the failure path.
  platformFeedWatchdog();
  int found = WiFi.scanNetworks(false, true);
  platformFeedWatchdog();
  for (int i = 0; i < found; i++) {
    if (WiFi.SSID(i) == ssid && WiFi.RSSI(i) > bestRssi) {
      bestRssi = WiFi.RSSI(i);
      best = i;
    }
  }
  if (best >= 0) {
    // COPY the BSSID and drop the scan results BEFORE begin(). WiFi.BSSID()
    // returns a pointer INTO the scan table, and begin() is asynchronous —
    // calling scanDelete() afterwards freed the memory the SDK was still
    // about to read. That use-after-free made a request for one SSID
    // associate against a stale BSSID belonging to a different network,
    // producing a confusing mix of AUTH_EXPIRE and NO_AP_FOUND.
    uint8_t bssid[6];
    memcpy(bssid, WiFi.BSSID(best), sizeof(bssid));
    int32_t chan = WiFi.channel(best);
    Serial.printf("  targeting BSSID %02X:%02X:%02X:%02X:%02X:%02X ch%d %ddBm\n",
                  bssid[0], bssid[1], bssid[2], bssid[3], bssid[4], bssid[5],
                  chan, bestRssi);
    WiFi.scanDelete();
    WiFi.begin(ssid.c_str(), password.c_str(), chan, bssid, true);
  } else {
    Serial.printf("  '%s' not found in scan — connecting without BSSID pin\n",
                  ssid.c_str());
    WiFi.scanDelete();
    WiFi.begin(ssid.c_str(), password.c_str());
  }
#else
  WiFi.begin(ssid.c_str(), password.c_str());
#endif

  unsigned long start = millis();
  while (WiFi.status() != WL_CONNECTED) {
    if (millis() - start > timeoutMs) {
      Serial.println("WiFi connect timed out");
#if defined(ARDUINO_ARCH_ESP32)
      // A bare timeout cannot distinguish "wrong password" from "SSID not
      // visible", and the ESP32 is 2.4GHz-only — a dual-band router
      // advertising one SSID looks identical to a typo from here. Scan and
      // report what the radio can actually see, so the next attempt is
      // diagnosed rather than guessed.
      Serial.printf("  status=%d (4=CONNECT_FAILED/bad auth, 6=DISCONNECTED, 1=NO_SSID_AVAIL)\n",
                    (int)WiFi.status());
      // WiFi.disconnect() first: a STA stuck in a retry loop makes the scan
      // return WIFI_SCAN_RUNNING (-2) instead of a count, which reads as
      // "no networks" and produces a confidently wrong diagnosis.
      WiFi.disconnect(false, false);
      delay(100);
      // A synchronous scan blocks for seconds without yielding to the task
      // watchdog. Feed on both sides so the DIAGNOSTIC path cannot itself
      // reset the board and hide the diagnosis it exists to print.
      platformFeedWatchdog();
      int n = WiFi.scanNetworks(/*async=*/false, /*show_hidden=*/true);
      platformFeedWatchdog();
      if (n < 0) {
        Serial.printf("  scan did not complete (rc=%d) — cannot diagnose\n", n);
        WiFi.scanDelete();
        return false;
      }
      Serial.printf("  visible 2.4GHz networks (%d):\n", n);
      bool sawTarget = false;
      for (int i = 0; i < n; i++) {
        bool match = WiFi.SSID(i) == ssid;
        if (match) sawTarget = true;
        // Print the exact auth mode, not just open/enc. WPA3-only and
        // WPA2/WPA3 mixed are the classic causes of a status=4 rejection
        // against a strong, visible AP with a correct password — and they
        // are invisible if this only says "enc".
        const char* auth = "?";
        switch (WiFi.encryptionType(i)) {
          case WIFI_AUTH_OPEN: auth = "open"; break;
          case WIFI_AUTH_WEP: auth = "WEP"; break;
          case WIFI_AUTH_WPA_PSK: auth = "WPA"; break;
          case WIFI_AUTH_WPA2_PSK: auth = "WPA2"; break;
          case WIFI_AUTH_WPA_WPA2_PSK: auth = "WPA/WPA2"; break;
          case WIFI_AUTH_WPA2_ENTERPRISE: auth = "WPA2-ENT"; break;
          case WIFI_AUTH_WPA3_PSK: auth = "WPA3 <-- ESP32 often fails"; break;
          case WIFI_AUTH_WPA2_WPA3_PSK: auth = "WPA2/WPA3 <-- try WPA2-only"; break;
          case WIFI_AUTH_WAPI_PSK: auth = "WAPI"; break;
          default: auth = "other"; break;
        }
        Serial.printf("   %c %-32s ch%-3d %ddBm %s\n", match ? '*' : ' ',
                      WiFi.SSID(i).c_str(), WiFi.channel(i), WiFi.RSSI(i), auth);
      }
      if (!sawTarget) {
        Serial.printf("  '%s' NOT VISIBLE to this radio — it is almost certainly\n"
                      "  5GHz-only. The ESP32 has no 5GHz radio. Use the 2.4GHz\n"
                      "  SSID (often a separate name, or split the bands).\n",
                      ssid.c_str());
      } else {
        Serial.println("  SSID is visible, so the band is fine — check the password.");
      }
      WiFi.scanDelete();
#endif
      return false;
    }
    // Feed explicitly. delay() is vTaskDelay on ESP32 — it blocks the task
    // WITHOUT resetting the task watchdog, so this 15s loop would otherwise
    // trip it and reboot the device mid-association. That would boot-loop on
    // a slow-but-working AP: exactly the failure the watchdog is meant to
    // protect against, caused by the watchdog itself.
    platformFeedWatchdog();
    delay(250);
  }
  Serial.print("WiFi connected, IP: ");
  Serial.println(WiFi.localIP());
  return true;
}

// Watch the station link and recover it if auto-reconnect does not.
//
// Deliberately conservative, in this order:
//   1. Link up              -> clear the timer, do nothing.
//   2. Down < 2min          -> let the SDK's own auto-reconnect work.
//   3. Down > 2min          -> WiFi.reconnect() on each check, a cheap
//                              non-blocking nudge. Repeated, not one-shot:
//                              an AP that comes back after an hour must be
//                              rejoined, and this is the only thing trying.
//   4. Down > 2h            -> ESP.restart(), the last resort.
//
// BEING OFFLINE IS NOT AN ERROR STATE. The alarm is cloud-independent by
// design — RF decode, rule evaluation, siren and EEPROM arm state are all
// local — so a device with no WiFi is still protecting the premises. It
// loses remote arm/disarm and cloud alerts, which is worth recovering from,
// but NOT at the price of restarting a working alarm every few minutes
// through a long outage. Each reboot is a gap in which nothing is watched.
//
// Hence 2h before the restart: long past any router reboot or ISP blip, so
// it only ever fires for a genuinely wedged radio that nudging cannot fix.
// A reboot re-runs the connect path cleanly and reloads arm state from
// EEPROM, so the alarm returns armed exactly as it was.
//
// noinline for the cont-stack reason documented on handleSensorEvent().
__attribute__((noinline))
void superviseWifi(unsigned long now) {
  if (portalActive) return;  // the portal owns the radio; leave it alone
  if (now - lastWifiCheckMs < kWifiCheckIntervalMs) return;
  lastWifiCheckMs = now;

  if (WiFi.status() == WL_CONNECTED) {
    if (wifiDownSinceMs != 0) {
      Serial.printf("[wifi] link restored after %lus (IP %s)\n",
                    (now - wifiDownSinceMs) / 1000,
                    WiFi.localIP().toString().c_str());
      wifiDownSinceMs = 0;
    }
    return;
  }

  if (wifiDownSinceMs == 0) {
    wifiDownSinceMs = now;
    Serial.printf("[wifi] link DOWN (status=%d) — alarm still armed locally, "
                  "waiting for auto-reconnect\n",
                  (int)WiFi.status());
    return;
  }

  const unsigned long downMs = now - wifiDownSinceMs;
  if (downMs >= kWifiDownRebootMs) {
    Serial.printf("[wifi] down %lumin — rebooting to recover the radio\n",
                  downMs / 60000);
    Serial.flush();
    ESP.restart();
  }
  if (downMs >= kWifiDownGraceMs) {
    Serial.printf("[wifi] down %lumin — nudging reconnect\n", downMs / 60000);
    WiFi.reconnect();
  }
}

void enterPortalMode() {
  portalActive = true;
  portal.begin(&provisionStore);
  portal.start();
  Serial.println("Portal mode active — waiting for setup submission");
}

void onNormalOperation() {
  Serial.println("Entering normal operation");

  // Configure the cloud client but do NOT mint here — loop() does it.
  // The mint must run on the cont (sketch) stack, where BearSSL's
  // _run_until can actually yield: optimistic_yield() is a no-op unless
  // can_yield() is true, which holds only on that stack. loop() also calls
  // cloudClient.loop() first, so the handshake gets maximum stack headroom
  // — see handleSensorEvent()'s note for why that matters.
  {
    String endpoint = provisionStore.endpoint();
    while (endpoint.endsWith("/")) endpoint.remove(endpoint.length() - 1);
    cloudClient.begin(endpoint + "/mintDeviceToken", provisionStore.databaseUrl(),
                       FIREBASE_WEB_API_KEY, provisionStore.apiKey());
  }

  eepromStore.begin();
  if (!eepromStore.load(&armed, &localWebEnabled, &config)) {
    Serial.println("No valid EEPROM state found — starting disarmed, local web enabled, empty config");
    armed = false;
    localWebEnabled = true;
    config = Config();
  }
  config.armed = armed;
  alarmState.setConfig(config);

  bool radioReady = cc1101.begin(kCc1101CsPin, kCc1101Gdo0Pin);
  if (!radioReady) {
    Serial.println("[cc1101] init FAILED — RF receive and siren TX disabled");
  }

  // DELIBERATELY does NOT generate an address here when EEPROM has none.
  //
  // Generating is the LAST resort, not the first move. This device previously
  // minted a fresh address the moment EEPROM came up empty — which is exactly
  // how a physical siren pairing was lost: an EepromStore::kMagic bump
  // discarded the stored Config, the device generated a NEW address on the
  // next boot, and the siren stayed bound to the old one it could no longer
  // hear. The cloud held the right value the whole time.
  //
  // So: wait. If Firestore has an address it arrives in the next config push
  // and applyPendingConfigUpdate() adopts it. Only if the cloud also has none
  // does maybeGenerateSirenAddress() mint one (see loop()).
  //
  // Safe to run addressless in the meantime: RelaySiren::sendCommand() gates
  // on SirenAddress::isValid(), so the siren is silent rather than
  // transmitting garbage, and the address can be applied live via
  // siren.setBaseAddress().
  if (SirenAddress::isValid(config.sirenBaseAddress)) {
    Serial.printf("[siren] base address 0x%06lX (from EEPROM)\n",
                  (unsigned long)config.sirenBaseAddress);
  } else {
    Serial.println("[siren] no stored base address — waiting for the cloud "
                   "before generating one");
  }
  siren.begin(kRelayPin, radioReady ? &cc1101 : nullptr, config.sirenBaseAddress);
  // From EEPROM, before the first cloud poll: a device that boots with the
  // siren disabled must be silent immediately, not only once a config arrives.
  siren.setEnabled(config.sirenEnabled);

  // NTP sync (configTime()) is deferred until cloud settles — see
  // startNtpSyncIfNeeded(). Harmless either way (mDNS/NTP/CC1101 timing
  // were all ruled out as causes of the mint crash investigated in this
  // codebase's history), but deferring still slightly reduces startup
  // work before the first mint try.

  if (localWebEnabled) {
    // mDNS start is deferred — see startMdnsIfNeeded()'s comment above.
    localWebServer.begin();
    localWebServer.start();
    Serial.println("Local web server enabled");
  } else {
    Serial.println("Local web server disabled (localWebEnabled=false)");
  }

  normalOperationStartMs = millis();
}
}  // namespace

// Over-the-air firmware update — see ota_updater.h for the whole flow.
// Called every loop(); cheap when nothing is happening.
//
// Runs AFTER pollCc1101()/siren.tick() in loop(), and the download itself is
// sliced into ~40ms chunks, so the alarm keeps working while an update
// downloads. The only blind window is the restart at the end, and that is
// refused while the siren is sounding or held, or an entry delay is counting
// down — those live only in RAM and a reboot would silently drop them.
__attribute__((noinline))
void handleOta(unsigned long now) {
  // 1. Verify an image installed before this boot, or report its rollback.
  const bool healthy = cloudClient.isReady() && cloudClient.hasReceivedConfig();
  if (otaUpdater.verifyTick(now, healthy) ==
      OtaUpdater::VerifyResult::MarkedValid) {
    cloudClient.reportOtaStatus("ok", kFirmwareVersion);
    otaUpdater.clearPending();
    otaOutcomeReported = true;
  }
  if (!otaOutcomeReported && cloudClient.isReady() &&
      otaUpdater.bootKind() == OtaBootKind::RolledBack) {
    cloudClient.reportOtaStatus("rolled_back", otaUpdater.pendingVersion(),
                                "new image failed its health check");
    otaUpdater.clearPending();
    otaOutcomeReported = true;
  }

  // 2. A new request from the web UI.
  OtaRequest req;
  if (cloudClient.consumeOtaCommand(&req)) {
    const bool sirenBusy = siren.isActive() || pendingSirenDeadlineMs != 0 ||
                           alarmState.isEntryDelayPending();
    OtaVerdict verdict = otaDecide(
        req, otaUpdater.hasLastHandledNonce(), otaUpdater.lastHandledNonce(),
        kFirmwareVersion, (uint32_t)time(nullptr), sirenBusy,
        otaUpdater.active() || otaUpdater.installed());
    Serial.printf("[ota] request n=%u %s -> %s\n", (unsigned)req.nonce,
                  req.version, otaVerdictName(verdict));
    if (verdict != OtaVerdict::AlreadyHandled) {
      // Recorded BEFORE downloading, in NVS: if the new image is rolled back,
      // the old one must not see this same command and install it again.
      otaUpdater.markHandled(req.nonce);
    }
    if (verdict == OtaVerdict::Accept) {
      String err;
      if (otaUpdater.start(req, CloudClient::storageBucket(),
                           cloudClient.idToken(), &err)) {
        otaLastReportedPct = 0;
        cloudClient.reportOtaStatus("downloading", req.version, nullptr, 0);
      } else {
        cloudClient.reportOtaStatus("failed", req.version, err.c_str());
      }
    } else if (verdict != OtaVerdict::AlreadyHandled) {
      cloudClient.reportOtaStatus("refused", req.version,
                                  otaVerdictName(verdict));
    }
  }

  // 3. Restart into an installed image once the alarm is quiet. The siren
  // may have started DURING the download; the new image is already the next
  // boot partition, so waiting costs nothing.
  if (otaUpdater.installed()) {
    static bool deferLogged = false;
    const bool sirenBusy = siren.isActive() || pendingSirenDeadlineMs != 0 ||
                           alarmState.isEntryDelayPending();
    if (sirenBusy) {
      if (!deferLogged) {
        Serial.println("[ota] installed — restart deferred while alarm busy");
        deferLogged = true;
      }
      return;
    }
    cloudClient.reportOtaStatus("rebooting", otaUpdater.activeVersion(),
                                nullptr, 100);
    otaUpdater.restartIntoNewImage();
  }

  // 4. Advance a running download.
  if (!otaUpdater.active()) return;
  String err;
  switch (otaUpdater.tick(&err)) {
    case OtaUpdater::TickResult::Running: {
      const uint8_t pct = otaUpdater.progressPct();
      if (pct >= otaLastReportedPct + 25) {
        otaLastReportedPct = pct - pct % 25;
        cloudClient.reportOtaStatus("downloading", otaUpdater.activeVersion(),
                                    nullptr, otaLastReportedPct);
      }
      break;
    }
    case OtaUpdater::TickResult::Failed:
      cloudClient.reportOtaStatus("failed", otaUpdater.activeVersion(),
                                  err.c_str());
      break;
    case OtaUpdater::TickResult::Done:  // restarts on the next pass (step 3)
    case OtaUpdater::TickResult::Idle:
      break;
  }
}

void setup() {
  // 115200 to match spike_mint — at 9600 the mint-path diagnostics in
  // cloud_client.cpp block long enough to perturb the timings they measure.
  Serial.begin(115200);
#if defined(ARDUINO_ARCH_ESP32)
  // Native USB CDC (not a UART): the endpoint does not exist until the host
  // enumerates it, which takes ~1s after reset. Anything printed before then
  // is written into the void, so an early banner simply never appears and
  // the board looks dead while running perfectly. Wait for the host, but
  // bound the wait — on a standalone power supply there is no host at all
  // and the alarm must still boot.
  {
    const unsigned long kUsbWaitMs = 2000;
    unsigned long start = millis();
    while (!Serial && millis() - start < kUsbWaitMs) delay(10);
    delay(100);  // let the host attach its reader before the first write
  }
#else
  delay(200);
#endif
  Serial.printf("Alarm system device booting... firmware %s (last reset: %s)\n",
                kFirmwareVersion, platformResetReason());
  // Before anything can hang: an image under verification that hangs from
  // here on is reset by the watchdog, and the bootloader then rolls it back.
  otaUpdater.beginBoot(kFirmwareVersion);

  // Start the watchdog BEFORE anything that can block, so a hang during
  // provisioning or the WiFi connect is caught too. 30s is deliberately
  // generous: connectToWifi() alone budgets 15s, the mint's response wait
  // 15s, and runSirenPairing() blocks for 10s — all legitimate, and all
  // feed the watchdog explicitly via platformFeedWatchdog(). This only
  // fires for a genuine hang, never for slow-but-progressing work.
  platformWatchdogBegin(kWatchdogTimeoutSec);

  // Observe a hung loopTask BEFORE the watchdog reboots it. Runs on the other
  // core and dumps the stuck phase over serial at 40s, while USB is still
  // enumerated — the 60s TWDT panic usually loses its backtrace because the
  // S3's USB-Serial/JTAG stops enumerating the instant the CPU halts. Started
  // here, right after the watchdog, so a hang anywhere from provisioning
  // onward is covered. See stall_monitor.h.
  stallMonitorBegin();

  pinMode(kForcePortalPin, INPUT_PULLUP);
  bool forcePortal = digitalRead(kForcePortalPin) == LOW;

  if (!provisionStore.begin()) {
    Serial.println("FATAL: LittleFS unavailable");
  }
  provisionStore.load();

  if (forcePortal) {
    Serial.println("Boot button held — forcing portal mode");
    enterPortalMode();
    return;
  }

  if (provisionStore.isConfigured() &&
      connectToWifi(provisionStore.ssid(), provisionStore.password(),
                     kWifiConnectTimeoutMs)) {
    onNormalOperation();
    return;
  }

  enterPortalMode();
}

void loop() {
  // Every path below returns through here, including the portal's early
  // return, so this single call covers the whole firmware. A hang anywhere
  // else now reboots the board within kWatchdogTimeoutSec instead of leaving
  // it powered and dead — see platformWatchdogBegin()'s comment.
  platformFeedWatchdog();

  // Record loop progress for the stall monitor (stall_monitor.h). Individual
  // blocking stretches below re-tag the phase via stallMonitorPhase() so a
  // hang inside one is named in the monitor's 40s dump; this top-of-loop bump
  // both re-arms the detector and sets the default "loop" phase.
  stallMonitorBump("loop");

  if (portalActive) {
    portal.handle();
    if (portal.hasPendingSave()) {
      String ssid, password, endpoint, databaseUrl, apiKey;
      portal.takePendingSave(&ssid, &password, &endpoint, &databaseUrl, &apiKey);
      provisionStore.save(ssid, password, endpoint, databaseUrl, apiKey);

      if (connectToWifi(ssid, password, kWifiConnectTimeoutMs)) {
        portal.stop();
        portalActive = false;
        onNormalOperation();
      } else {
        portal.showError();
      }
    }
    return;
  }

  unsigned long now = millis();

  superviseWifi(now);

  // The mint runs from here (CloudClient::loop() -> beginInitialConnect()),
  // and its TLS handshake is the deepest stack consumer in the whole
  // firmware. Call it FIRST, before any of the work below, so it sees the
  // most cont-stack headroom available. Everything after this point is
  // cheap or held out-of-line — see handleSensorEvent()'s note.
  //
  // This is also the deepest BLOCKING stretch (DNS resolve, TLS handshake,
  // synchronous get/set), so tag it for the stall monitor: if loop() wedges
  // here, the 40s dump reads phase='cloud' rather than the generic 'loop'.
  stallMonitorPhase("cloud");
  cloudClient.loop(siren.isActive());
  stallMonitorPhase("loop");

  // Re-read the clock: cloudClient.loop() above BLOCKS (DNS, TLS handshake,
  // synchronous get/set — up to kSyncTimeoutSec). Everything below is
  // time-sensitive, and using the pre-block `now` dates a packet decoded
  // after the call to before it. Two packets delayed by different amounts
  // then get an apparent gap shorter or longer than the real one, which
  // corrupts every windowed condition.
  //
  // Observed on hardware 2026-09-07: a 2-of-3 rule with a 10s window fired
  // on triggers 10.7s and 11.3s apart, because the stale timestamps put
  // them inside it. Also affects the entry-delay deadline and the siren's
  // auto-off, both of which were being told time had not advanced.
  now = millis();

  pollCc1101(now);

  pollEntryDelay(now);
  tickPendingSiren(now);
  siren.tick(now);

  // Clear state/siren_active once the alarm is over. onAlarm triggers on the
  // false->true edge, so a flag left true makes every LATER alarm a silent
  // no-op — the feature would work exactly once. Edge-triggered so this
  // costs one write per alarm, not one per loop.
  if (alarmReportedToCloud && !siren.isActive()) {
    alarmReportedToCloud = false;
    cloudClient.clearAlarm();
  }

  // The siren going idle — for ANY reason (auto-off, manual disarm, a
  // false-positive advisory) — means there is no longer an active trigger to
  // match against. Clearing here (rather than only where it is consumed)
  // means a later advisory for a trigger that has since auto-expired is
  // correctly treated as stale, not matched against whatever comes next.
  if (!siren.isActive() && activeAlarmRfId[0] != '\0') {
    activeAlarmRfId[0] = '\0';
    activeAlarmTs = 0;
  }

  bool cloudSettled = cloudClient.isReady() ||
                       millis() - normalOperationStartMs > kDnsUsersStartFallbackMs;

  if (localWebEnabled && !mdnsStarted && cloudSettled) {
    startMdnsIfNeeded();
  }
  if (!ntpStarted && cloudSettled) {
    startNtpSyncIfNeeded();
  }

  // Last-resort address generation. Runs BEFORE the report below so a freshly
  // minted address is reported in the same pass rather than a poll later.
  //
  // Requires hasReceivedConfig(): the cloud must have actually answered with
  // a config that carried no `s`. An offline device therefore never generates
  // — correct, because its EEPROM copy may simply be waiting for a cloud that
  // would have supplied the right one.
  //
  // Note this is "config RECEIVED", not "config update applied": a device
  // whose config never changes gets no updates, and gating on those would
  // leave it addressless forever.
  //
  // ALSO gated on there being no config update still QUEUED. hasReceivedConfig()
  // and hasPendingConfigUpdate() are both set by the same applyConfigJson()
  // call, but applyPendingConfigUpdate() — which is what actually adopts the
  // cloud's address — runs LATER in this same loop() iteration. Without this
  // check the very first poll generates a fresh address microseconds before
  // adopting the correct one, then reports it up and overwrites the good
  // value in Firestore. That defeats the whole lost-pairing protection
  // exactly when it is needed: on a device whose EEPROM was just wiped.
  // Measured on hardware 2026-09-07 — cost a real siren pairing twice.
  if (cloudClient.hasReceivedConfig() &&
      !cloudClient.hasPendingConfigUpdate() &&
      !SirenAddress::isValid(config.sirenBaseAddress)) {
    maybeGenerateSirenAddress();
  }

  // Strictly isReady(), not the cloudSettled fallback above — that fallback
  // also fires if the cloud never comes up, and reportEvent() would just
  // no-op then anyway. Only mark it done once the call has actually fired.
  //
  // Also gated on HAVING an address: a device still waiting on the cloud has
  // nothing to report, and reporting 0x000000 would round-trip through
  // onSirenAddress as a bogus pairing.
  //
  // Rate-limited because the report now RETRIES until confirmed (see
  // reportSirenAddressOnce): an unthrottled retry would attempt a TLS write
  // every loop iteration on a device whose heap is too low to serve one.
  if (!sirenAddressReported && cloudClient.isReady() &&
      SirenAddress::isValid(config.sirenBaseAddress) &&
      (lastSirenAddressReportMs == 0 ||
       now - lastSirenAddressReportMs >= kSirenAddressRetryMs)) {
    lastSirenAddressReportMs = now;
    reportSirenAddressOnce();
  }

  // Why the last boot happened. Reported once, and only once the cloud is
  // actually up — this is the record that makes the NEXT unexplained death
  // diagnosable instead of reconstructed from heartbeat arithmetic.
  if (!bootReported && cloudClient.isReady()) {
    bootReported = true;
    cloudClient.reportBoot();
  }

  if (cloudClient.isReady() && now - lastHeartbeatMs >= kHeartbeatIntervalMs) {
    lastHeartbeatMs = now;
    cloudClient.reportHeartbeat();
  }

  bool newArmed;
  if (cloudClient.consumeArmedCommand(&newArmed)) {
    applyArmedCommand(newArmed);
  }

  bool sirenCommandOn;
  if (cloudClient.consumeSirenCommand(&sirenCommandOn)) {
    if (sirenCommandOn) {
      siren.turnOn(config.sirenDurationSec, now);
    } else {
      siren.turnOff();
    }
  }

  uint32_t pairNonce = 0, pairUntil = 0;
  if (cloudClient.consumePairCommand(&pairNonce, &pairUntil)) {
    // Ignore an expired request: time(nullptr) is only meaningful once NTP
    // has synced, so a zero/unset `until` is treated as "no deadline".
    const uint32_t nowSec = (uint32_t)time(nullptr);
    if (pairUntil != 0 && nowSec > 100000UL && nowSec > pairUntil) {
      Serial.printf("[siren] ignoring expired pair request (now %lu > until %lu)\n",
                    (unsigned long)nowSec, (unsigned long)pairUntil);
    } else {
      runSirenPairing();
    }
  }

  // False-positive advisory — the cloud judged a snapshot "safe" and wants
  // the siren silenced, but ONLY for the exact trigger it is vouching for.
  //
  // STRICTLY SUBTRACTIVE: this path may only call siren.turnOff(). It must
  // never arm/disarm, never touch alarmState, and never run when there is no
  // match — a stale or mismatched advisory (wrong rfId, wrong ts, or no
  // siren currently active at all) is a silent no-op, logged and nothing
  // else. The match is against activeAlarmRfId/activeAlarmTs, captured in
  // handleSensorEvent() at the moment THIS siren activation started — not
  // against AlarmState::TriggerCause, which only has the 20-bit family and
  // no timestamp and so cannot distinguish this trigger from a later one on
  // the same sensor.
  char fpRfId[11] = {};
  uint64_t fpTs = 0;
  if (cloudClient.consumeFalsePositive(fpRfId, sizeof(fpRfId), &fpTs)) {
    // A siren that is SOUNDING or one still inside its hold both count as
    // "current" here: the hold exists precisely so this advisory can land
    // first, and gating on isActive() alone would let the deadline expire and
    // sound the siren the cloud just vouched against. The identity match is
    // unchanged — handleSensorEvent records it for a held siren too.
    const bool pending = pendingSirenDeadlineMs != 0;
    if ((siren.isActive() || pending) && activeAlarmRfId[0] != '\0' &&
        fpTs == activeAlarmTs && strcmp(fpRfId, activeAlarmRfId) == 0) {
      Serial.printf("[camera] false-positive advisory: %s siren for %s\n",
                    pending ? "cancelling held" : "stopping", fpRfId);
      cancelPendingSiren();
      siren.turnOff();
      activeAlarmRfId[0] = '\0';
      activeAlarmTs = 0;
    } else {
      Serial.printf("[camera] false-positive advisory: no match (stale/not-current) "
                    "for %s, no-op\n", fpRfId);
    }
  }

  // Breach advisory — the cloud's AI judge saw a person, and a condition
  // covering that sensor opted into vision evidence (breach_satisfies), so the
  // alarm should sound even though our own rules did not fire.
  //
  // STRICTLY ADDITIVE, the exact mirror of the fp block above being strictly
  // subtractive: this path may only turn the siren ON. It must never arm or
  // disarm, and must never touch alarmState — the trigger history is local
  // state that survives cloud outages, and letting the cloud rewrite it would
  // corrupt every later window.
  //
  // Matched against activeAlarmRfId/activeAlarmTs like the advisory, with one
  // deliberate difference: those are only set when a siren activation STARTED,
  // and by definition no alarm fired here. So the match is against the LAST
  // TRIGGER's identity instead — recorded on every armed trigger, whether or
  // not it alarmed, precisely so this can be matched.
  char breachRfId[11] = {};
  uint64_t breachTs = 0;
  if (cloudClient.consumeBreach(breachRfId, sizeof(breachRfId), &breachTs)) {
    const bool matches = lastTriggerRfId[0] != '\0' &&
                         breachTs == lastTriggerTs &&
                         strcmp(breachRfId, lastTriggerRfId) == 0;
    if (!matches) {
      // A stale or unrecognised advisory is a logged no-op, never a siren.
      Serial.printf("[camera] breach advisory: no match (stale/unknown) for %s, "
                    "no-op\n", breachRfId);
    } else if (!config.armed) {
      // Disarmed since the trigger. The cloud's verdict describes an armed
      // moment that has passed, and sounding now would be an alarm the owner
      // just cancelled.
      Serial.printf("[camera] breach advisory for %s but DISARMED, no-op\n",
                    breachRfId);
    } else if (!config.sirenEnabled) {
      Serial.printf("[camera] breach advisory for %s but siren disabled, "
                    "reporting only\n", breachRfId);
      cloudClient.reportAlarm(breachRfId, 0);
      alarmReportedToCloud = true;
    } else {
      Serial.printf("[camera] breach advisory: sounding siren for %s\n", breachRfId);
      // Cancel any hold first: a judge-raised alarm is already confirmed, so
      // waiting out sirenHoldSec would delay exactly the case the hold exists
      // to resolve.
      cancelPendingSiren();
      siren.turnOn(config.sirenDurationSec, now);
      // Adopt this trigger as the one sustaining the siren, so a LATER fp
      // advisory for the same trigger can still silence it.
      strncpy(activeAlarmRfId, breachRfId, sizeof(activeAlarmRfId) - 1);
      activeAlarmRfId[sizeof(activeAlarmRfId) - 1] = '\0';
      activeAlarmTs = breachTs;
      cloudClient.reportAlarm(breachRfId, 0);
      alarmReportedToCloud = true;
    }
  }

  // Gated so the ~2.4KB Config inside is only ever allocated when there is
  // actually an update to apply, and out-of-line so its frame is never part
  // of loop()'s.
  if (cloudClient.hasPendingConfigUpdate()) {
    applyPendingConfigUpdate();
  }

  // Manual capture command from the web UI: /commands/capture = { at: <ms> }.
  // Grabs ALL channels regardless of sensor config — this is an explicit user
  // request, not a sensor-triggered capture. Uses "MANUAL" as the rfId so the
  // timeline entry is labelled separately from sensor events. NVR mode must be
  // non-off (nm != 0) and the cloud must be ready (same gate as sensor capture).
  uint64_t captureCommandTs = 0;
  if (cloudClient.consumeCaptureCommand(&captureCommandTs) &&
      config.nvrMode != 0 && cloudClient.isReady()) {
    Serial.printf("[camera] manual capture requested at %llu\n",
                  (unsigned long long)captureCommandTs);
    uint8_t channels[3] = {1, 2, 3};
    uint8_t channelCount = 3;
    uint8_t uploaded = 0;
    for (uint8_t c = 0; c < channelCount; c++) {
      platformFeedWatchdog();
      std::vector<uint8_t> buf;
      if (!CameraClient::grab(config, channels[c], buf)) continue;
      platformFeedWatchdog();
      if (cloudClient.uploadSnapshot("MANUAL", captureCommandTs, channels[c],
                                     buf.data(), buf.size()))
        uploaded++;
    }
    Serial.printf("[camera] manual capture: %u/%u channel(s) uploaded\n",
                  uploaded, channelCount);
  }

  handleOta(now);

  if (localWebEnabled) {
    if (mdnsStarted) platformMdnsUpdate();
    localWebServer.setStatus(armed, siren.isActive());
    localWebServer.handle();

    if (localWebServer.hasPendingArmCommand()) {
      bool newArmedFromWeb = localWebServer.takePendingArmCommand();
      // Tagged so onDeviceArmStateChange can say "from local web UI" — this
      // path produced NO notification at all before that function existed.
      armedBySource = "local";
      applyArmedCommand(newArmedFromWeb);
    }

    // Expire the window here too, not only on the next decoded packet: if
    // nobody presses anything, handleRemotePacket never runs and the status
    // would sit on "waiting" forever.
    if (remotePairUntilMs != 0 && (long)(now - remotePairUntilMs) >= 0) {
      remotePairUntilMs = 0;
      localWebServer.setRemotePairStatus("expired — no button pressed");
      Serial.println("[remote] pairing window expired");
    }

    if (localWebServer.hasPendingRemotePair()) {
      localWebServer.clearPendingRemotePair();
      // Refused up front as well as in remotePair(), so the window never
      // opens while armed rather than opening and rejecting the press.
      if (armed) {
        localWebServer.setRemotePairStatus("refused: system armed");
        Serial.println("[remote] pair request refused — system is armed");
      } else {
        remotePairUntilMs = now + kRemotePairWindowMs;
        localWebServer.setRemotePairStatus("waiting for a button press");
        Serial.println("[remote] pairing window open for 30s");
      }
    }

    if (localWebServer.hasPendingTrigger()) {
      String rfId;
      localWebServer.takePendingTrigger(&rfId);
      // Through the SAME dispatch a real packet takes, so a simulated
      // "0x0061DB" exercises the tamper path rather than being forced into a
      // plain trigger. Exercising that logic without waving a magnet at a
      // sensor is the simulator's whole purpose.
      //
      // strtoul handles the "0x" prefix with base 16. An unparseable entry
      // yields 0, which matches no family and is simply reported — the same
      // outcome as typing an unpaired code, which is already the normal case
      // here.
      dispatchSensorCode((uint32_t)strtoul(rfId.c_str(), nullptr, 16), now,
                         /*batteryLow=*/false, /*rssi=*/0);
    }

    if (localWebServer.hasPendingPairRequest()) {
      localWebServer.clearPendingPairRequest();
      runSirenPairing();
    }

    // Bench aid: sound the siren on demand, independently of arm state and
    // alarm rules. Deliberately passes the configured duration so the
    // auto-off timer runs exactly as it would for a real alarm; POST
    // /disarm silences it early. If sirenDurationSec is 0 the siren is
    // disabled and turnOn() is a no-op, which is the correct behaviour.
    if (localWebServer.hasPendingSirenTest()) {
      localWebServer.clearPendingSirenTest();
      // Falls back to 30s when no duration has been synced from the cloud.
      // Without this the bench test is silently a no-op on a device whose
      // config has not arrived yet: turnOn() treats 0 as "siren disabled"
      // and returns before transmitting, which looks exactly like a broken
      // radio. Observed on a freshly flashed board: "sounding for 0s" and
      // no tx line at all.
      uint16_t testDuration = config.sirenDurationSec > 0
                                  ? config.sirenDurationSec
                                  : 30;
      Serial.printf("[siren] bench test: sounding for %us (config=%us) — "
                    "POST /disarm to stop\n",
                    testDuration, config.sirenDurationSec);
      siren.turnOn(testDuration, now);
    }
  }
}
