ariel-bentu/alarmSystem/firmware/edge/device/src/ssl_socket_state.h

#pragma once

// Pure predicates for "is this TLS socket still usable?", split out of
// SslClientWithDns so they are native-testable — same split as HostResolver,
// StallDetector, IoDeadline and AuthSupervisor. No Arduino / mbedTLS types.

// True when the sslclient fd no longer refers to a usable socket.
//
// MUST BE <= 0, NOT < 0 (the 2026-09-09 regression). ssl_client.cpp
// stop_ssl_socket() sets socket = -1 at line 325, but line 346 then runs
// `memset(ssl_client, 0, sizeof(sslclient_context))`, which overwrites it with
// **0**. A live fd from lwip_socket() is > 0. So after a teardown the fd is 0,
// and a `< 0` test silently never matches — which is exactly why the first fix
// for the -76 hang shipped and still rebooted at 18.36h.
inline bool sslSocketIsGone(int fd) { return fd <= 0; }

// True when a return from the base available() is a hard failure (e.g. -76,
// MBEDTLS_ERR_NET_RECV_FAILED). 0 is NOT a failure here: a silent-but-open
// socket is the wall-clock deadline's job, not this predicate's.
inline bool sslReadFailed(int rc) { return rc < 0; }

// What available() must return once we know the socket is gone.
//
// POSITIVE, not negative — this is the whole point of the 2026-09-09 rework.
//
// The hanging loop (AsyncClient.h:1131) never calls available() directly; it
// reaches it through `if (sData->response.tcpAvailable() > 0)` at
// AsyncClient.h:452. A negative fails that gate exactly like 0, so returning
// -1 (as the first two fixes did) left the no-op -> ret_continue -> spin
// completely untouched. Nothing in FirebaseClient treats available() < 0
// specially; every use is `> 0` or `== 0`.
//
// A positive opens the gate and hands control to the library's OWN teardown:
// readPayload() (ResponseHandler.h:466) enters on `connected() || available()`
// and calls readResponse<>(), whose read() returns -1 on the dead socket and
// spins to its internal 5000ms bound, returning -2 -> `len < 0` ->
// `respCtx.stage = response_stage_finished` -> the outer loop exits.
//
// 1 rather than a large value: it is only a gate token, and any bytes it
// implies do not exist. ~5s to unwind is well under the 40s stall dump and the
// 60s TWDT.
inline int sslDeadSocketAvailable() { return 1; }
