ariel-bentu/alarmSystem/firmware/edge/device/src/config_parser.cpp

#include "config_parser.h"

#include <ArduinoJson.h>
#include <cstdlib>

namespace ConfigParser {

bool parseConfigJson(const char* json, Config* out) {
  // Bumped 4096 -> 6144 when the NVR connection fields (nh/np/nu/nw/nm/cc)
  // and the per-sensor camera array were added — a 16-sensor, 4-condition,
  // 8-participant worst case plus the new fields runs ~6.5KB of raw JSON.
  // Note: measured empirically that ArduinoJson 7.4.3's StaticJsonDocument<N>
  // is a deprecated shim over JsonDocument (see compatibility.hpp) — N only
  // feeds a cosmetic capacity() getter, the backing store is heap-allocated
  // and grows on demand, so this bump is documentation of true load, not a
  // hard limit that was actually at risk of NoMemory.
  StaticJsonDocument<6144> doc;
  DeserializationError err = deserializeJson(doc, json);
  if (err) return false;

  out->armed = doc["a"] | false;
  out->sirenDurationSec = doc["d"] | 0;
  out->sirenEnabled = doc["e"] | true;

  // Siren base address, echoed back by the cloud so a device whose EEPROM was
  // wiped can re-adopt its own identity rather than generating a new one the
  // physical siren was never paired to. 0 means "cloud has none"; the caller
  // decides whether to adopt (see main.cpp's applyPendingConfigUpdate — a
  // device with a valid local address ignores this and stays authoritative).
  //
  // Parsed BEFORE the r/c early return below, for the same reason as `m`.
  out->sirenBaseAddress = doc["s"] | 0;

  // Parsed BEFORE the r/c handling below, which has an early return for the
  // no-sensors case — remotes must survive that path or a project with no
  // rules could never use one.
  out->remoteCount = 0;
  JsonArray m = doc["m"];
  if (!m.isNull()) {
    for (JsonVariant v : m) {
      // Clamp rather than overflow: the array is fixed-size and the config
      // is remote input.
      if (out->remoteCount >= Config::kMaxRemotes) break;
      out->remotes[out->remoteCount++] = v.as<uint32_t>();
    }
  }

  // NVR connection + capture settings, echoed from the project's camera
  // config. Parsed BEFORE the r/c early return below, for the same reason as
  // `s`/`m` — a config with no sensors must still deliver NVR settings (e.g.
  // so the device can keep a capture session alive independent of rules).
  // nvrMode: 0=off, 1=capture, 2=capture+judge.
  strncpy(out->nvrHost, doc["nh"] | "", sizeof(out->nvrHost) - 1);
  out->nvrHost[sizeof(out->nvrHost) - 1] = '\0';
  out->nvrPort = doc["np"] | 34567;
  strncpy(out->nvrUser, doc["nu"] | "", sizeof(out->nvrUser) - 1);
  out->nvrUser[sizeof(out->nvrUser) - 1] = '\0';
  strncpy(out->nvrPassword, doc["nw"] | "", sizeof(out->nvrPassword) - 1);
  out->nvrPassword[sizeof(out->nvrPassword) - 1] = '\0';
  out->nvrMode = doc["nm"] | 0;
  out->captureCooldownSec = doc["cc"] | 45;
  // Absent = capture while disarmed too (the pre-field behaviour); the cloud
  // only emits `cd: 0` when the project turned it off.
  out->captureWhenDisarmed = (doc["cd"] | 1) != 0;

  // Siren hold for non-definite sensors. 0/absent = fire immediately, which
  // is what every config written before this field decodes to.
  out->sirenHoldSec = doc["sh"] | 0;

  JsonArray r = doc["r"];
  JsonArray c = doc["c"];
  // Hoisted out of the per-sensor loop below: one lookup, not one per sensor.
  JsonArray cmask = doc["cmask"];
  JsonArray nd = doc["nd"];
  // Paired with onProfileChange.ts: RTDB drops empty arrays on .set(), so
  // "no active profile" writes {a, d} with r/c omitted entirely rather than
  // r:[]/c:[]. Missing r/c means zero sensors (arm nothing), NOT a parse
  // failure — only reject if the arrays are present but mismatched in
  // length (genuinely malformed), or if exactly one of the two is present.
  if (r.isNull() && c.isNull()) {
    out->sensorCount = 0;
    return true;
  }
  if (r.isNull() || c.isNull() || r.size() != c.size()) return false;

  out->sensorCount = 0;
  for (size_t i = 0; i < r.size() && i < 16; i++) {
    SensorConfig& sensor = out->sensors[out->sensorCount];
    // `r` now carries 20-bit family ids ("0x0061D") rather than full 24-bit
    // rfIds. Wire-compatible — r was always string[], only the contents got
    // shorter — so this is the same strncpy against a smaller buffer.
    strncpy(sensor.familyId, r[i].as<const char*>(), sizeof(sensor.familyId) - 1);
    sensor.familyId[sizeof(sensor.familyId) - 1] = '\0';

    // The per-sensor camera selection rides as ONE index-aligned OPTIONAL
    // bitmask array next to r/c, rather than inside each condition object, so
    // the existing r/c loop and its early-return contract stay untouched.
    // Channel N is bit N-1. Missing or short means mask 0 — capture NOTHING
    // for that sensor, which is also what buildConfig's wholesale omission
    // means when no sensor has a camera. It is deliberately NOT a fall-back to
    // "all channels": the selection is authoritative.
    sensor.cameraMask = (!cmask.isNull() && i < cmask.size())
                            ? static_cast<uint8_t>(cmask[i] | 0)
                            : 0;

    // Breach certainty, as an OPTIONAL list of r-indices that are NOT
    // definite (`nd`), rather than a per-sensor flag array: the overwhelming
    // common case is "every sensor is definite", which omits the key entirely
    // and keeps the payload the device polls every 5s unchanged.
    //
    // Assigned EXPLICITLY on every pass, never left to the struct's default:
    // `out` is a reused Config, so a sensor that was non-definite in the
    // previous config would otherwise stay non-definite here and keep holding
    // its siren after the box was unticked.
    sensor.definiteBreach = true;
    if (!nd.isNull()) {
      for (JsonVariant v : nd) {
        // Compared as a SIGNED int: casting a negative index to size_t would
        // wrap to a huge value that could never match, which is harmless, but
        // comparing signed makes garbage input obviously a no-op instead.
        int idx = v.as<int>();
        if (idx >= 0 && (size_t)idx == i) {
          sensor.definiteBreach = false;
          break;
        }
      }
    }

    JsonArray conditions = c[i];
    sensor.conditionCount = 0;
    for (JsonVariant condJson : conditions) {
      if (sensor.conditionCount >= 4) break;
      Condition& cond = sensor.conditions[sensor.conditionCount];
      cond.t = condJson["t"] | 0;
      cond.n = condJson["n"] | 0;
      cond.w = condJson["w"] | 0;
      cond.y = condJson["y"] | 0;
      // count_in_window minimum separation, seconds. Omitted when unset or 0.
      // Clamped to Condition::g's uint8_t range rather than truncated: a
      // wrapped value would silently become a SMALLER gap than configured,
      // i.e. a weaker filter than the user asked for.
      unsigned long gRaw = condJson["g"] | 0UL;
      cond.g = gRaw > 255UL ? 255 : (uint8_t)gRaw;
      // Always-on: fires regardless of arm state. Omitted when false.
      cond.always = (condJson["x"] | 0) == 1;
      cond.kLen = 0;
      // k arrives in EITHER shape. buildConfig emits an object keyed by
      // index-into-r ({"0":1,"1":1}), but Firebase RTDB silently converts an
      // object whose keys are "0".."n" into a JSON ARRAY ([1,1]) — so a rule
      // whose participants happen to start at index 0 is delivered as an
      // array. Reading only the object form left kLen at 0, which made
      // multiSensorSatisfied() iterate zero participants and never fire.
      // Cost a live 3-sensor rule that silently did nothing (2026-09-07).
      JsonArray kArray = condJson["k"];
      if (!kArray.isNull()) {
        uint8_t idx = 0;
        for (JsonVariant v : kArray) {
          if (cond.kLen >= 8) break;
          // Same 16-slot bound the object path below enforces: the position
          // indexes config_.sensors[]/runtime_[], so a longer array would be
          // a genuine out-of-bounds access in multiSensorSatisfied(), not
          // merely stale data.
          if (idx >= 16) break;
          // A hole in a sparse array arrives as null. Skipping keeps the
          // POSITION meaningful — position is the index into r, so counting
          // a null as a participant would shift every later index.
          if (!v.isNull()) {
            cond.kIndex[cond.kLen] = idx;
            cond.kCount[cond.kLen] = v.as<uint16_t>();
            cond.kLen++;
          }
          idx++;
        }
      }
      JsonObject k = condJson["k"];
      if (!k.isNull()) {
        for (JsonPair kv : k) {
          if (cond.kLen >= 8) break;
          // Validate the index-as-string key against the fixed capacity of
          // Config::sensors[]/AlarmState::runtime_[] (16 slots — see
          // alarm_state.h), NOT against r.size(). r.size() is the incoming
          // JSON array's length and can exceed 16; the outer sensor loop
          // above is separately capped at `i < 16`, so any "k" index >= 16
          // would be a genuine out-of-bounds access when
          // AlarmState::multiSensorSatisfied later indexes
          // config_.sensors[participantIndex]/runtime_[participantIndex] —
          // not merely stale data. Drop any entry that doesn't validate
          // rather than storing a bad index.
          int parsedIndex = atoi(kv.key().c_str());
          if (parsedIndex < 0 || parsedIndex >= 16) continue;
          cond.kIndex[cond.kLen] = (uint8_t)parsedIndex;
          cond.kCount[cond.kLen] = kv.value().as<uint16_t>();
          cond.kLen++;
        }
      }
      // multi_sensor quorum: how many participants must be satisfied. Read
      // AFTER k so it can be validated against the participant count that
      // actually survived the loop above. Omitted by the server whenever it
      // equals that count, so 0 is the normal "all of them" case. A value
      // exceeding kLen would make the rule permanently unfireable, so clamp
      // to 0 (= all) rather than trusting it — same drop-don't-store policy
      // as the k indices above.
      int parsedQuorum = condJson["q"] | 0;
      cond.q = (parsedQuorum > 0 && parsedQuorum <= (int)cond.kLen)
                   ? (uint8_t)parsedQuorum
                   : 0;
      sensor.conditionCount++;
    }
    out->sensorCount++;
  }
  return true;
}

bool parseAdvisory(const char* json, const char* key, char* rfIdOut, size_t cap,
                   uint64_t* tsOut) {
  JsonDocument doc;
  if (deserializeJson(doc, json)) return false;

  JsonVariant fp = doc[key];
  if (fp.isNull() || !fp.is<JsonObject>()) return false;

  JsonVariant rfId = fp["rfId"];
  if (!rfId.is<const char*>()) return false;

  // ts rides as a JSON number. ArduinoJson's variant can produce it as
  // uint64_t directly (RTDB sends it unquoted) — reject rather than accept
  // a missing/non-numeric value, since a false-positive advisory with no
  // timestamp can never match anything and should be visibly ignored
  // upstream in CloudClient rather than silently treated as ts=0.
  JsonVariant ts = fp["ts"];
  if (!ts.is<uint64_t>() && !ts.is<long long>() && !ts.is<unsigned long long>()) {
    // ArduinoJson 7's is<T>() is picky about the exact integer type it
    // stored; fall back to a numeric-type check so any integral JSON number
    // is accepted regardless of which C++ integer type backs it.
    if (!ts.is<long>() && !ts.is<unsigned long>() && !ts.is<int>()) return false;
  }

  strncpy(rfIdOut, rfId.as<const char*>(), cap - 1);
  rfIdOut[cap - 1] = '\0';
  *tsOut = ts.as<uint64_t>();
  return true;
}

bool parseFalsePositive(const char* json, char* rfIdOut, size_t cap,
                        uint64_t* tsOut) {
  return parseAdvisory(json, "fp", rfIdOut, cap, tsOut);
}

}  // namespace ConfigParser
