ariel-bentu/alarmSystem/firmware/edge/device/src/cloud_client.h

#pragma once

#include <Arduino.h>

// NOTE(API adaptation): the brief's SSL_CLIENT macro comes from
// FirebaseClient's own examples/ExampleFunctions.h, which is not pulled in
// by the library itself. The library's real ESP8266 examples (e.g.
// examples/RealtimeDatabase/StreamEthernet/ESP8266/ESP8266.ino) construct
// AsyncClientClass directly from a plain WiFiClientSecure, so we do the
// same here rather than depending on an example-only header.
#include <WiFiClientSecure.h>

#define ENABLE_CUSTOM_TOKEN
#define ENABLE_DATABASE
// Storage: snapshot uploads (uploadSnapshot). Uses the SAME authenticated
// app_/custom token as the RTDB path below — see startAppAndStreams(), which
// calls app_.getApp<Storage>(storage_) right next to the existing
// app_.getApp<RealtimeDatabase>(database_) call. No separate auth flow.
#define ENABLE_STORAGE
#include <FirebaseClient.h>

#include "alarm_state.h"
#include "auth_supervisor.h"
#include "config_parser.h"
#include "ota_command.h"
#include "ssl_client_with_dns.h"

class CloudClient {
 public:
  // mintTokenUrl: the mintDeviceToken Cloud Function's URL; databaseUrl:
  // the project's RTDB URL; firebaseWebApiKey: public Web API key
  // (compile-time constant, safe to embed — see Task 11 note).
  bool begin(const String& mintTokenUrl, const String& databaseUrl,
             const String& firebaseWebApiKey, const String& deviceApiKey);

  // Performs the initial mint + FirebaseApp/stream setup synchronously.
  //
  // MUST be called from loop(), never from setup(). The TLS handshake's
  // wait loop (BearSSL::WiFiClientSecureCtx::_run_until) paces itself with
  // optimistic_yield(), which only actually yields when can_yield() is true
  // — i.e. only on the cont (sketch) stack. From setup() the handshake runs
  // in system context, the loop spins without feeding the watchdog, and a
  // Soft WDT reset follows at ~3s. loop()'s retry path calls this; nothing
  // else should. See main.cpp's onNormalOperation() for the full evidence.
  //
  // Blocking (seconds) — acceptable because loop() is re-entered afterwards
  // and a failure just falls through to the 30s retry.
  //
  // Returns true if the device is authenticated and streams are attached.
  bool beginInitialConnect();

  // Non-blocking; call every loop() iteration to service FirebaseClient's
  // async tasks (auth refresh, stream reconnects). Also retries the mint
  // with backoff if beginInitialConnect() did not succeed.
  // sirenActive: true = 1s poll cadence, false = 5s.
  void loop(bool sirenActive = false);

  bool isReady() const;  // true once authenticated and streams attached

  // Event write to /{projectId}/events/{rfId}/{ts}.
  // No-op (silently skipped) if not yet authenticated — matches the
  // "no event buffering v1" decision.
  //
  // Returns true only if the write actually reached RTDB. Sensor triggers
  // ignore this (a lost event is accepted by design), but the siren-address
  // report MUST check it: that write is what persists the device's identity
  // to Firestore, and it is also skipped when contiguous heap is low. Marking
  // it "reported" after a skipped write would strand the address on-device
  // forever, which is the very failure this reporting exists to prevent.
  // `tsMs` is the event key: epoch MILLISECONDS for the trigger this reports.
  //
  // PASS IT IN, do not let this re-read the clock. handleSensorEvent computes
  // one timestamp per trigger and uses it for the snapshot upload path and the
  // fp/breach advisory match too; a second time(nullptr) read here lands on
  // the other side of a second boundary often enough to matter, and the cloud
  // joins timeline docs to event rows by exactly this {rfId, ts}. When they
  // disagreed by 1000ms the web UI declared the timeline doc an orphan and
  // rendered a real sensor trigger as "manual capture" (seen 2026-10-05,
  // 19:24:44 vs 19:24:45).
  //
  // 0 means "read the clock here" — kept for the callers that have no trigger
  // of their own (siren-address report, boot).
  bool reportEvent(const char* rfId, const char* event, bool batteryLow, int rssi,
                   const char* value = nullptr, uint64_t tsMs = 0);

  // Write armed state to /{projectId}/state/armed so the web UI reflects
  // device-side arm/disarm (local web UI, physical button, etc.).
  // No-op if not yet authenticated.
  // `source` ("remote", "local", "cloud") is written to
  // /{projectId}/state/armed_by BEFORE state/armed, so onDeviceArmStateChange
  // — which triggers on state/armed — always finds it already present. Same
  // ordering discipline reportAlarm() uses for alarm_cause before
  // siren_active. Pass nullptr to leave armed_by untouched.
  void reportArmedState(bool armed, const char* source = nullptr);

  // Report a device-side alarm: writes /{projectId}/state/alarm_cause
  // ({rfId, ct, at}) and then sets /state/siren_active true. The cause goes
  // first so onAlarm, which triggers on siren_active, always finds it.
  // rfId/conditionType come from AlarmState's TriggerCause.
  // No-op if not yet authenticated.
  void reportAlarm(const char* rfId, uint8_t conditionType);

  // Report an alarm that has no sensor behind it (SOS from a remote).
  // Writes /{projectId}/state/alarm_cause as {label, at} — the shape
  // alarmCause.ts already supports, where a label wins outright over rfId
  // mapping — then sets /state/siren_active true, exactly like
  // reportAlarm(). Do NOT pass a remote's raw code to reportAlarm()
  // instead: it would make the Telegram alert name an unpaired sensor.
  // No-op if not yet authenticated.
  void reportAlarmLabel(const char* label);

  // Clear /{projectId}/state/siren_active. REQUIRED after every reportAlarm:
  // onAlarm triggers on the false->true edge, so a flag left true swallows
  // every later alarm silently. No-op if not yet authenticated.
  void clearAlarm();

  // Write device UPTIME SECONDS (millis()/1000) to
  // /{projectId}/state/last_seen. NOT epoch — an earlier version of this
  // comment said "epoch seconds" and it is wrong; the web UI timestamps the
  // ARRIVAL of the update instead, so online detection works before NTP has
  // synced (see useDeviceState.ts). The uptime value is what allowed a
  // silent death to be dated after the fact, so keep the semantics.
  // Call every ~10s from loop() to drive the web UI's online indicator.
  // No-op if not yet authenticated.
  void reportHeartbeat();

  // Write /{projectId}/state/boot = { reason, at, uptime_before }.
  //
  // Called once per boot, as soon as the cloud is ready. This is the whole
  // point of the watchdog work: a device that dies unexplained comes back,
  // says WHY it died, and the next investigation reads it from RTDB instead
  // of reconstructing it from heartbeat arithmetic. "panic" vs "twdt" vs
  // "brownout" separates a crash from a hang from a power fault — three
  // very different bugs that look identical from the outside.
  void reportBoot();

  // Upload one JPEG snapshot to Firebase Storage, object path
  // {projectId}/snapshots/{rfId}/{ts}/ch{channel}.jpg — the SAME
  // {rfId}/{ts} keying as the RTDB event this snapshot belongs to, so the
  // cloud side can join them (see the design spec). Best-effort: returns
  // false and logs exactly one line on ANY failure (not ready, no data
  // client, upload error) — never throws, never blocks past the same
  // bounded deadlines the rest of this class already uses
  // (kHandshakeTimeoutSec / kSocketTimeoutSec / kSyncTimeoutSec govern the
  // shared data client regardless of which Firebase service is calling
  // through it). Caller's responsibility, same as reportEvent(): this must
  // run strictly AFTER the alarm/siren/event-report path, never before or
  // interleaved with it — see main.cpp's handleSensorEvent().
  //
  // `ts` is epoch MILLISECONDS — the exact same unit and source
  // (time(nullptr) * 1000) as the key reportEvent() writes to
  // /events/{rfId}/{ts}. uint64_t, NOT uint32_t: a uint32_t cannot hold a
  // real epoch-ms value at all (current epoch-ms is already ~1.7e12, far
  // past 2^32 ~= 4.3e9 — that range was exhausted on 1970-02-19). Truncating
  // to 32 bits would silently corrupt the path's correlation key, which is
  // the entire point of this field — see the design spec's "{rfId}/{ts}
  // exactly matches the /events key" requirement.
  bool uploadSnapshot(const char* rfId, uint64_t ts, uint8_t channel,
                      const uint8_t* jpeg, size_t len);

  // Registered once in begin(); main.cpp polls these via getters rather
  // than a callback, to keep main.cpp's control flow linear.
  bool consumeArmedCommand(bool* armed);    // true if a new value arrived since last call
  bool consumeSirenCommand(bool* sirenOn);  // true if a new value arrived since last call
  bool consumeConfigUpdate(Config* config); // true if a new config arrived since last call
  // Pairing request: /commands/pair = { n: <nonce>, until: <epochSec> }.
  // A nonce rather than a bool so a repeat request is distinguishable from a
  // stale one; `until` lets the device ignore a request whose window has
  // already passed, so a command left in RTDB cannot make a device pair
  // itself on reboot days later.
  bool consumePairCommand(uint32_t* nonce, uint32_t* untilEpochSec);
  // False-positive advisory: /commands/fp = { rfId: "0x..", ts: <epoch-ms> },
  // written when the cloud judges a snapshot "safe". Returns true once per
  // NEW advisory (change-only-surfaces-once, same pattern as
  // consumeConfigUpdate) — re-polling the same {rfId,ts} does not re-fire.
  //
  // rfId is the FULL 24-bit code (matches /events/{rfId} and the snapshot
  // upload path), NOT the 20-bit family AlarmState::TriggerCause stores.
  // ts is epoch-MILLISECONDS, same uint64 reportEvent()/uploadSnapshot() use
  // — main.cpp is responsible for matching this against whatever it recorded
  // as the currently-sounding trigger's {rfId, ts} before acting on it. This
  // call is STRICTLY ADVISORY: it never decides on its own to touch the
  // siren or arm state.
  bool consumeFalsePositive(char* rfIdOut, size_t cap, uint64_t* tsOut);
  // Breach advisory: /commands/breach = { rfId: "0x..", ts: <epoch-ms> },
  // written when the cloud judges a snapshot "breach" AND a condition covering
  // that sensor opted into vision evidence (Condition.breach_satisfies) while
  // the device's own rules had not fired.
  //
  // The ADDITIVE mirror of consumeFalsePositive: same identity semantics, same
  // once-per-new-advisory surfacing, opposite effect. main.cpp matches the
  // {rfId, ts} against the trigger it recorded, then sounds the siren.
  //
  // ⚠️ STRICTLY ADDITIVE, the mirror of fp's strictly-subtractive rule: acting
  // on this may raise the alarm and sound the siren, and must NEVER arm or
  // disarm, and must never write to AlarmState's trigger history. The device's
  // trigger counts are local state that survives cloud outages; letting the
  // cloud rewrite them would corrupt every later window.
  bool consumeBreach(char* rfIdOut, size_t cap, uint64_t* tsOut);
  // Manual capture command: /commands/capture = { at: <epoch-ms> }, written
  // by the web UI. Returns true once per NEW request (change-only, same nonce
  // pattern as pair/fp). ts is the epoch-ms the web UI stamped; the device
  // uses it as the snapshot/event key so the timeline can be joined.
  bool consumeCaptureCommand(uint64_t* tsOut);
  // Firmware update request: /commands/ota (see ota_command.h for the shape).
  // Surfaces once per NEW nonce, like pair/capture. Whether to act on it —
  // including "already handled before the last reboot" — is otaDecide()'s
  // call in main.cpp, not this class's.
  bool consumeOtaCommand(OtaRequest* out);

  // Write /{projectId}/state/ota = { status, version, detail, progress, at }.
  // status: "downloading" | "rebooting" | "ok" | "failed" |
  // "refused" | "rolled_back". Best-effort, like every other state write.
  void reportOtaStatus(const char* status, const char* version,
                       const char* detail = nullptr, int progress = -1);

  // The current Firebase ID token, for the OTA download's Authorization
  // header — the same identity (role=device, projectId claim) the Storage
  // SDK path uses, so storage.rules governs it identically.
  String idToken() const { return app_.getToken(); }
  static const char* storageBucket();

  // Lets callers avoid putting a ~2.4KB Config on the 4KB cont stack unless
  // there is actually an update to take — see main.cpp's loop().
  bool hasPendingConfigUpdate() const { return hasPendingConfig_; }

  // True once a config has been successfully read from RTDB at all — even an
  // unchanged one that produced no pending update.
  //
  // This is deliberately NOT "a config update was applied". main.cpp needs to
  // know whether the cloud has been HEARD FROM before it may generate a siren
  // address, and a device whose config never changes gets no updates at all;
  // gating on updates alone would mean it never generates one.
  bool hasReceivedConfig() const { return hadConfigValue_; }

 private:
  String mintTokenUrl_;
  String databaseUrl_;
  String deviceApiKey_;
  String firebaseWebApiKey_;
  bool tokenMinted_ = false;
  String customTokenJwt_;
  // Learned from mintDeviceToken's response (see mintCustomToken()); used to
  // prefix every RTDB path (/{projectId}/commands, /config, /events/...) per
  // the multi-tenant data layout — the device has no other way to know it.
  String projectId_;
  // NOTE(API adaptation): FirebaseApp::ready() is non-const in the real
  // library (it drives processAuth() as a side effect), but this class's
  // public isReady() is const per the brief's interface. loop() polls
  // app_.ready() once per iteration and caches the result here so isReady()
  // can stay a cheap const getter for main.cpp.
  bool appReady_ = false;

  // Decides when an un-ready app has been un-ready for too long to be
  // recovering on its own, and must be re-minted from scratch. Pure logic,
  // native-tested in test/test_auth_supervisor — see auth_supervisor.h for
  // the field failure that made it necessary.
  AuthSupervisor authSupervisor_;
  // Rate-limits the "NOT ready" trace to once a minute; 0 = not logging.
  unsigned long lastNotReadyLogMs_ = 0;

  // TWO SSL clients, not four — this is the shape spike_mint proved works on
  // this board (mint + RTDB auth + write + read, all succeeding).
  //
  // Four clients does NOT fit: constructing them costs ~11.8KB, dropping the
  // heap from 21,568 to 9,808, and BearSSL then fails a 3424-byte allocation
  // per handshake ("Unhandled C++ exception: OOM" in _connectSSL).
  // setBufferSizes(512,512) on all four did not save it — the number of
  // simultaneous TLS connections is the constraint, not their buffer size.
  //
  // So: one client for auth (FirebaseApp owns it), and ONE shared data
  // client used serially for config reads, command reads, and event writes.
  // Serial use is why SSE streaming is gone — see loop()'s polling comment.
  //
  // Heap-allocated after the mint, not plain members: each WiFiClientSecure
  // allocates a WiFiClientSecureCtx in its constructor, and holding those
  // through the mint's own handshake wastes the headroom it needs.
  //
  // SslClientWithDns (not a plain WiFiClientSecure): resolves each host once
  // and connects by IP, so FirebaseClient's per-poll/per-write connect() no
  // longer runs a blocking DNS lookup that the watchdog cannot see. Matters
  // for BOTH — the auth client reconnects on every ~hourly token refresh, and
  // that handshake blocks the same loop task the watchdog watches. See
  // ssl_client_with_dns.h.
  SslClientWithDns* authSslClient_ = nullptr;
  SslClientWithDns* dataSslClient_ = nullptr;
  // mintCustomToken() uses a stack-local WiFiClientSecure, freshly
  // constructed per call — see its comment for why a long-lived version
  // (member, and separately a lazily-allocated pointer) both regressed to
  // crashing on the very first mint attempt on real hardware, worse than
  // the fragmentation-across-retries problem they were meant to fix.

  // Also deferred: these bind by reference to the SSL clients above, so
  // they cannot be constructed until those exist.
  using AsyncClient = AsyncClientClass;
  AsyncClient* authClient_ = nullptr;
  AsyncClient* dataClient_ = nullptr;

  FirebaseApp app_;
  RealtimeDatabase database_;
  // Snapshot uploads. Bound to the SAME app_ (and so the same custom token)
  // as database_ — see startAppAndStreams(). Uses the shared dataClient_ /
  // dataSslClient_ for the actual TLS connection, exactly like every
  // database_ call, so it is covered by the same heap/handshake/timeout
  // guards and never opens a fifth concurrent TLS connection.
  Storage storage_;

  AsyncResult dataResult_;

  // Polling cadence for config/commands, alternating so only one request is
  // ever in flight on the shared client.
  unsigned long lastPollMs_ = 0;
  bool pollConfigNext_ = false;
  // 5s normal cadence, 1s when siren is active (each path seen every 2x).
  //
  // *** THE PARAGRAPH BELOW IS ESP8266-ONLY HISTORY. *** It described a
  // board with ~5KB free heap, where the cloud path could starve mDNS of a
  // 540-byte allocation. The ESP32-S3 runs this at ~258KB free / ~192KB
  // largest block, so 5s is NOT a heap risk there and 15000 is not required.
  // Kept because the measurement is real and still applies if the 8266 env
  // is ever revived — but do not cite it as a constraint on current
  // hardware. (It was mistakenly blamed for an unexplained ESP32 hang on
  // 2026-09-02; see CLAUDE.md's "Watchdog + boot reporting".)
  //
  // This is a HEAP budget, not a latency preference. Steady-state free heap
  // with the long-lived data client is only ~5KB / ~3KB contiguous, and at a
  // 5s cadence the device died with "Unhandled C++ exception: OOM" on a
  // 540-byte allocation inside MDNSResponder::_readRRAnswer — i.e. mDNS
  // could not parse an inbound packet because the cloud path had consumed
  // everything. Polling less often leaves that margin intact.
  //
  // LAN arm/disarm via the local web server is unaffected and instant; this
  // only bounds REMOTE command latency.
  static constexpr unsigned long kPollIntervalMs = 5000;
  static constexpr unsigned long kPollIntervalAlarmMs = 1000;

  // How long a single synchronous FirebaseClient operation may block loop().
  //
  // THIS IS A WATCHDOG CONSTRAINT, NOT A LATENCY PREFERENCE. database_.get()
  // and database_.set() are SYNCHRONOUS: they block inside loop() in
  //   while (!sData->response.tcpAvailable()) { sys_idle(); ... }
  // (FirebaseClient AsyncClient.h), and sys_idle() on ESP32 is just delay(0)
  // — it yields to FreeRTOS but does NOT feed the task watchdog.
  //
  // Left unset, that wait is bounded only by the library's own
  // FIREBASE_TCP_READ_TIMEOUT_SEC / FIREBASE_TCP_WRITE_TIMEOUT_SEC, both 30s
  // (core/Options.h, marked "Do not change"). The default applies whenever
  // setSyncReadTimeout()/setSyncSendTimeout() are not called, because the
  // library reads `sync_*_timeout_sec > 0 ? sync_*_timeout_sec : -1` and -1
  // means "use the 30s default".
  //
  // kWatchdogTimeoutSec was ALSO 30, so one stalled poll could consume the
  // entire watchdog budget and reboot a perfectly healthy device — the
  // occasional "device gets stuck" reports. reportAlarm() is the worst case:
  // two sequential blocking set() calls, i.e. up to 60s, DURING AN ALARM.
  //
  // 5s is far longer than a healthy round-trip (observed well under 1s) and
  // far shorter than the watchdog budget, so a stalled network now fails the
  // poll cleanly and loop() keeps running — RF decode, the siren and the LAN
  // UI are all local and must not be held hostage by a slow socket.
  static constexpr uint32_t kSyncTimeoutSec = 5;

  // TLS CONNECT budget — a DIFFERENT bound from kSyncTimeoutSec above, and
  // the one that was missing.
  //
  // setSyncReadTimeout/setSyncSendTimeout govern reads and writes on an
  // ESTABLISHED socket. They do NOT cover the connect that precedes them:
  // FirebaseClient's SlotManager::connect() calls straight through to
  // WiFiClientSecure::connect(), whose Arduino-ESP32 defaults are
  //
  //     handshake_timeout = 120000 ms   (DOUBLE the 60s watchdog)
  //     _timeout          =  30000 ms
  //
  // and ssl_client.cpp's handshake loop spins on vTaskDelay(2), which yields
  // to FreeRTOS WITHOUT resetting the TWDT — the identical trap to
  // sys_idle()/delay(0) described above. A handshake to a silent or
  // packet-dropping peer therefore blocks loop() for up to two minutes and
  // the board reboots at 60s with reason=twdt, having done nothing wrong.
  //
  // This was the cause of the twdt reboots observed on hardware 2026-09-04,
  // two of them 45 minutes apart, on a build that ALREADY capped the sync
  // read/write timeouts at 5s. Capping those was necessary but not
  // sufficient — the connect phase was never covered.
  //
  // 10s: comfortably above a healthy handshake (observed ~900ms in the mint
  // path) and well under the 60s budget, leaving room for the poll's own
  // read/write timeouts on top. Both setters take SECONDS on ESP32.
  static constexpr uint32_t kHandshakeTimeoutSec = 10;
  static constexpr uint32_t kSocketTimeoutSec = 10;

  // Last-seen polled values. SSE delivered only changes; polling re-reads
  // the same value every few seconds, so these suppress no-op updates that
  // would otherwise re-apply commands and rewrite EEPROM continuously.
  // Minimum contiguous heap required to CREATE the data client (first use
  // only — reuse is never gated, see openDataClient()). BearSSL's handshake
  // allocation alone is 3424 bytes with request/response buffers on top, so
  // this needs real headroom. It is checked right after auth completes,
  // where ~15KB is free and fragmentation is still low.
  static constexpr uint32_t kMinBlockForWrite = 6000;

  // Separate, write-specific floor. An event write allocates more than the
  // small config/command reads, and attempting one below this does not fail
  // cleanly — it resets the board. Measured: writes crash at ~2.6KB; the
  // steady-state largest block after the first TLS cycle is ~3.4KB, so on
  // current hardware this floor means cloud event reporting is effectively
  // OFF while polling keeps working. Intentional: a lost event is better
  // than a reset that takes the alarm state machine with it.
  static constexpr uint32_t kMinBlockForEventWrite = 5000;

  bool hadArmedValue_ = false;
  bool lastArmedValue_ = false;
  bool hadSirenValue_ = false;
  bool lastSirenValue_ = false;
  bool hadConfigValue_ = false;
  String lastConfigJson_;

  bool pendingArmed_ = false;
  bool hasPendingArmed_ = false;
  bool pendingSiren_ = false;
  bool hasPendingSiren_ = false;
  bool hasPendingConfig_ = false;
  Config pendingConfig_;

  uint32_t lastPairNonce_ = 0;
  bool hadPairNonce_ = false;
  uint32_t pendingPairNonce_ = 0;
  uint32_t pendingPairUntil_ = 0;
  bool hasPendingPair_ = false;

  // Last-seen false-positive advisory, so re-polling the same {rfId,ts}
  // (polling re-reads the same /commands value every few seconds) doesn't
  // repeatedly surface it as "new" — mirrors lastPairNonce_/hadPairNonce_.
  char lastFalsePositiveRfId_[16] = {};
  uint64_t lastFalsePositiveTs_ = 0;
  bool hadFalsePositive_ = false;
  char pendingFalsePositiveRfId_[16] = {};
  uint64_t pendingFalsePositiveTs_ = 0;
  bool hasPendingFalsePositive_ = false;

  // Breach advisory — the ADDITIVE mirror of the false-positive one above.
  // Same {rfId,ts} shape, same change-only surfacing, opposite meaning: the
  // AI judge saw a person and a condition covering the sensor opted into
  // vision evidence, so the alarm should sound even though the device's own
  // rules have not fired. Separate state from fp: both keys can be present on
  // /commands at once, and one must never consume the other.
  char lastBreachRfId_[16] = {};
  uint64_t lastBreachTs_ = 0;
  bool hadBreach_ = false;
  char pendingBreachRfId_[16] = {};
  uint64_t pendingBreachTs_ = 0;
  bool hasPendingBreach_ = false;

  uint64_t lastCaptureCommandTs_ = 0;
  bool hadCaptureCommand_ = false;
  uint64_t pendingCaptureCommandTs_ = 0;
  bool hasPendingCapture_ = false;

  uint32_t lastOtaNonce_ = 0;
  bool hadOtaNonce_ = false;
  OtaRequest pendingOta_;
  bool hasPendingOta_ = false;

  bool mintCustomToken();
  // Parse a polled /commands or /config payload. Actual config parsing lives
  // in config_parser.h/.cpp (pure, native-testable).
  void applyCommandsJson(const String& json);
  void applyConfigJson(const String& json);
  // Factored out of begin() so the mint-retry path in loop() can perform the
  // same post-mint setup without duplicating it. Safe to call more than once
  // — forceReauth() drives it a second time.
  void startAppAndStreams();
  // Discard the dead auth session so loop()'s mint-retry path rebuilds it.
  // See its definition for what is deliberately NOT freed, and why.
  void forceReauth();
  // Data client lifecycle — see their definitions for why it is transient.
  bool openDataClient();
  void closeDataClient();

  unsigned long lastMintAttemptMs_ = 0;
  // Drives loop()'s retry backoff: fast retries while low, slow after.
  unsigned int mintFailureCount_ = 0;
  // False until loop()'s retry-gate has fired at least once — lets the
  // first mint attempt happen on loop()'s first iteration regardless of
  // millis()'s value at boot, instead of waiting out a full 30s backoff.
  bool mintAttempted_ = false;
};
