ariel-bentu/alarmSystem/firmware/edge/device/src/ssl_client_with_dns.h

#pragma once

#include <WiFi.h>
#include <WiFiClientSecure.h>

#include "host_resolver.h"
#include "io_deadline.h"
#include "platform_compat.h"
#include "ssl_socket_state.h"

// A WiFiClientSecure that resolves each host AT MOST ONCE and then connects by
// IP, so the blocking DNS lookup is kept off the per-connect hot path.
//
// THE PROBLEM (Finding 1, 2026-09-05): FirebaseClient drives every poll and
// every alarm write through Client::connect(host, port). The base
// WiFiClientSecure::connect(host, ...) calls WiFi.hostByName() first, which on
// this core blocks up to ~31s (WiFiGeneric.cpp: 16s WIFI_DNS_IDLE + 15s
// WIFI_DNS_DONE) BEFORE setTimeout()/setHandshakeTimeout() apply — and that
// wait does NOT feed the task watchdog. reportAlarm() issues two set() calls
// back to back, so two slow resolves can exceed the 60s watchdog and reboot a
// healthy device mid-alarm (reason=twdt). See host_resolver.h for the full
// note and the field symptom this matches.
//
// THE FIX: override connect(host, port). On a cache miss, resolve once (fed on
// both sides, like connectToWifi()'s scanNetworks()), cache the IP, and
// connect by IP. On a hit, connect straight to the cached IP with no DNS at
// all. SNI is preserved by passing the original hostname to the IP-connect
// overload, so Google's frontend still routes correctly under setInsecure().
// A failed connect invalidates the cache, so a rotated frontend IP forces a
// fresh resolve on the next attempt rather than wedging on a dead address.
//
// connect(const char*, uint16_t) is virtual in the Client base, and
// FirebaseClient holds the client as Client* (ConnectionHandler.h) and calls
// it virtually, so this override is dispatched. The IPAddress and no-host
// overloads are left to the base class untouched.
class SslClientWithDns : public WiFiClientSecure {
 public:
  int connect(const char* host, uint16_t port) override {
    if (host == nullptr) return 0;

    // A literal IP needs no resolution and no cache: hand it straight to the
    // base, which also short-circuits hostByName() for a dotted quad.
    IPAddress literal;
    if (literal.fromString(host)) {
      return WiFiClientSecure::connect(literal, port);
    }

    uint32_t cachedIp = 0;
    if (!resolver_.cached(host, &cachedIp)) {
      // Cache miss: the one blocking resolve. Fed on both sides because
      // hostByName() can block for seconds without touching the TWDT — the
      // same guard connectToWifi() puts around its synchronous scanNetworks().
      IPAddress resolved;
      platformFeedWatchdog();
      bool ok = WiFi.hostByName(host, resolved);
      platformFeedWatchdog();
      if (!ok || (uint32_t)resolved == 0) {
        Serial.printf("[dns] resolve of %s FAILED — connect aborted\n", host);
        return 0;
      }
      cachedIp = (uint32_t)resolved;
      resolver_.store(host, cachedIp);
      Serial.printf("[dns] resolved %s -> %s (cached)\n", host,
                    IPAddress(cachedIp).toString().c_str());
    }

    // Connect by IP, but pass the ORIGINAL hostname as the SNI/cert host so
    // Google's frontend routes the TLS session correctly. This overload takes
    // cert args; nullptr is correct under setInsecure() (verification is off).
    IPAddress ip(cachedIp);
    int rc = WiFiClientSecure::connect(ip, port, host, nullptr, nullptr, nullptr);
    if (rc <= 0) {
      // The cached IP did not answer. Drop it so the next connect re-resolves
      // rather than retrying the same dead frontend address forever.
      Serial.printf("[dns] connect to cached %s for %s failed — invalidating\n",
                    ip.toString().c_str(), host);
      resolver_.invalidate();
    } else {
      // Start bounding this operation. Every FirebaseClient sync wait polls
      // available() (read/connected cascade from it); the deadline lets us tear
      // a stalled socket down from there — see available() below and
      // io_deadline.h for the -76 hang this fixes.
      deadline_.arm(millis());
      reportedClosed_ = false;
      socketDead_ = false;
    }
    return rc;
  }

  // Bound the read wait by wall clock. FirebaseClient's sync loops spin on
  // available() (and read()/connected(), which both funnel through it) calling
  // sys_idle() between polls — which yields WITHOUT feeding the task watchdog.
  // Two distinct stalls are bounded here:
  //   1. The socket goes SILENT (peer wedged, not errored): the base returns 0
  //      forever while still "connected". The wall-clock deadline catches it.
  //   2. The socket is CLOSED underneath us by the base itself on a hard
  //      mbedTLS error (-76). The base's internal stop() bypasses our override,
  //      leaving the deadline armed, and every later call returns 0 via the
  //      !_connected early return. Caught below by the socket-fd check — the
  //      2026-09-08 twdt reboot, which case 1 alone did NOT cover.
  // Either way we force the operation to fail so the spinning wait aborts.
  int available() override {
    // Latched dead: keep the gate open so readPayload() stays in the library's
    // teardown path until it sets stage = finished. Re-running detection here
    // would be harmless but pointless, and the base is already stopped.
    if (socketDead_) return sslDeadSocketAvailable();

    if (deadline_.expired(millis())) {
      Serial.println("[io] socket stalled past deadline — stopping to unblock loop");
      WiFiClientSecure::stop();  // clears _connected; connected() now returns 0
      deadline_.disarm();
      // Same positive gate token as the dead-socket path below, and for the
      // same reason: a negative would fail `tcpAvailable() > 0` and leave the
      // 1131 loop spinning. socketDead_ makes read() fail from here on.
      socketDead_ = true;
      return sslDeadSocketAvailable();
    }
    int n = WiFiClientSecure::available();
    // Bytes ready == progress: re-arm so a slow-but-advancing transfer runs to
    // completion and only a genuinely stalled socket is torn down.
    if (n > 0) {
      deadline_.progress(millis());
      return n;
    }

    // THE 2026-09-08 RECURRENCE. On a hard mbedTLS error the base
    // available() calls its OWN stop() (WiFiClientSecure.cpp:247-250) — a
    // non-virtual internal call, so OUR stop() override above never runs and
    // the deadline is left armed — then sets _connected=false. Every later
    // call takes the `if (!_connected) return peeked;` early return and hands
    // back 0 FOREVER. FirebaseClient's `while (!available())` therefore spins
    // on sys_idle() (= delay(0), no TWDT feed) until the 60s watchdog reboots
    // (observed: -76, then 40968ms stuck in phase='cloud:poll-config').
    //
    // Two signals, either of which proves the socket is gone:
    //   - the base returned a hard negative (the FIRST call after the drop
    //     returns -76 itself), or
    //   - the fd has been torn down (every call after that returns 0).
    //
    // SENTINEL TRAP (cost a whole 18.36h soak): the fd is **0** after
    // teardown, not -1. stop_ssl_socket() sets -1 at ssl_client.cpp:325 and
    // then memsets the whole struct to zero at :346. The first version of this
    // fix tested `< 0`, never matched, and the device rebooted again with the
    // identical -76 / phase='cloud:poll-config' / 40802ms signature. The
    // predicates live in ssl_socket_state.h with tests pinning fd == 0.
    //
    // We read the PROTECTED sslclient fd rather than calling connected():
    // connected() runs read(&dummy, 0), and `read` there is VIRTUAL, so it
    // dispatches into OUR read() override, whose base read() calls
    // available() — re-entering this function. Unbounded recursion, stack
    // overflow.
    // Only an IN-FLIGHT operation can have its socket die "under a read". When
    // the deadline is not armed this client is idle between operations and
    // legitimately has no socket — reporting that produced false
    // `[io] socket closed...` lines on a perfectly healthy boot (observed
    // 2026-09-09: rc=0 fd=-1 and rc=0 fd=0 during mint/app startup), which
    // destroys the field signal this line exists to provide. Nothing is
    // spinning on an idle client, so there is nothing to break out of.
    if (!deadline_.armed()) return n;

    if (sslReadFailed(n) || sslclient == nullptr ||
        sslSocketIsGone(sslclient->socket)) {
      // Report unconditionally, not only when the deadline agrees: an unarmed
      // deadline (this client is between operations) would otherwise fall
      // through to `return n` == 0 on a socket that is already gone, which is
      // the exact spin this whole file exists to break. Log once per teardown
      // so a recurrence is greppable without spamming the 40s stall window.
      if (!reportedClosed_) {
        Serial.printf("[io] socket closed under an in-flight read (rc=%d fd=%d) — failing it to unblock loop\n",
                      n, sslclient ? sslclient->socket : -1);
        reportedClosed_ = true;
      }
      deadline_.socketClosed();
      deadline_.disarm();
      socketDead_ = true;
      // POSITIVE, deliberately — see sslDeadSocketAvailable(). A negative here
      // fails FirebaseClient's `tcpAvailable() > 0` gate exactly like 0 and
      // leaves the hanging loop untouched, which is what the first two
      // versions of this fix got wrong. A positive opens the gate so the
      // library runs its own teardown and ends the request.
      return sslDeadSocketAvailable();
    }
    reportedClosed_ = false;
    return n;
  }

  // Both read() forms must report failure once the socket is known dead,
  // because available() is now handing out a positive token that promises
  // bytes which do not exist.
  //
  // readResponse<>() (ResponseHandler.h:283) uses the SINGLE-BYTE read() and
  // does `c = source->read(); if (c == -1) continue;` — so returning -1 there
  // drives it around its loop to the internal 5000ms bound, which returns -2
  // and sets stage = response_stage_finished. That is the designed teardown we
  // are steering into. Returning 0 or a stale byte instead would corrupt the
  // parse or spin without the bound.
  int read() override {
    if (socketDead_) return -1;
    int c = WiFiClientSecure::read();
    if (c >= 0) deadline_.progress(millis());
    return c;
  }

  int read(uint8_t* buf, size_t size) override {
    if (socketDead_) return -1;
    int n = WiFiClientSecure::read(buf, size);
    if (n > 0) deadline_.progress(millis());
    return n;
  }

  void stop() override {
    deadline_.disarm();
    socketDead_ = false;  // a new connection on this client starts clean
    WiFiClientSecure::stop();
  }

  // Keep the base overloads visible — only the (host, port) form is
  // specialised; everything else (IP connect, timeout form, etc.) must still
  // resolve to WiFiClientSecure's implementations.
  using WiFiClientSecure::connect;
  using WiFiClientSecure::read;

 private:
  HostResolver resolver_;
  // One log line per teardown, re-armed on the next healthy poll.
  bool reportedClosed_ = false;
  // Latched once we hand out the positive gate token, so read() reports
  // failure for the rest of this dead connection. Cleared on connect()/stop().
  bool socketDead_ = false;
  // 12s: above the 5s sync read timeout (so it is a backstop, not the primary
  // bound), and well under the 40s stall monitor / 60s TWDT.
  IoDeadline deadline_{12000};
};
