ariel-bentu/alarmSystem/firmware/edge/device/src/cc1101_receiver.h

#pragma once

#include <cstdint>

#include "../../kerui_decoder.h"
#include "ev1527_frame.h"

// Drives a CC1101 433MHz transceiver over SPI in ASK/OOK receive mode.
// Uses an interrupt on GDO0 to capture edge timestamps into a ring buffer;
// poll() drains the buffer and decodes Kerui packets non-blockingly.
//
// CS and GDO0 are passed in by main.cpp (pin map lives there).
// SCK/MISO/MOSI are hardware SPI pins claimed by SPI.begin():
//   D1 Mini (ESP8266): D5/D6/D7 = GPIO14/12/13
//   ESP32-S3 (FSPI):   SCK 12, MISO 13, MOSI 11
class Cc1101Receiver {
 public:
  bool begin(uint8_t csPin, uint8_t gdo0Pin);

  // Non-blocking poll: returns true and fills *outPacket if a complete
  // Kerui packet was decoded from buffered edges since the last call.
  bool poll(KeruiPacket* outPacket, int* outRssi);

  // Transmit an EV1527 frame `repeats` times, then restore receive mode.
  //
  // BLOCKING for ~38ms per repeat (512 chips x 75us), so ~384ms at the
  // 10 repeats used for a command: the radio cannot hear sensors
  // while transmitting, because in TX mode the chip is not demodulating at
  // all. Accepted deliberately — Kerui sensors repeat each burst 5-7 times,
  // and we only transmit when the siren is already being commanded. A
  // non-blocking chunked FIFO feed was rejected: an underrun mid-frame
  // produces a malformed frame the siren rejects, trading a certain small
  // loss for an intermittent large one.
  //
  // NOTE: this framing is NOT the Kerui sensor framing that poll() decodes.
  // They are different protocols sharing a chip; do not attempt to verify
  // this against our own decoder (it reads our EV1527 frames as garbage).
  bool transmit(uint32_t code, int repeats);

 private:
  uint8_t csPin_   = 0;
  uint8_t gdo0Pin_ = 0;

  static const int kBufSize = 1024;
  // Edge ring buffer — written by ISR, read by poll().
  volatile uint32_t edgeTs_[kBufSize];
  volatile uint8_t  edgeLv_[kBufSize];
  volatile int      edgeCount_ = 0;
  volatile uint32_t lastEdgeMs_ = 0;

  // Debounce: suppress repeated decodes of the same sensor within 3s.
  uint32_t lastDecodedId_ = 0;
  uint32_t lastDecodedMs_ = 0;

  // Pointer to singleton instance so the static ISR can reach it.
  static Cc1101Receiver* instance_;
  static void IRAM_ATTR isr();

  void     writeReg(uint8_t addr, uint8_t value);
  uint8_t  readReg(uint8_t addr);
  uint8_t  readStatusReg(uint8_t addr);
  // Converted to dBm here so every consumer reads the same unit. Uses the
  // STATUS register space — see the definition for why readReg() is wrong.
  int      readRssiDbm();
  void     strobe(uint8_t cmd);
  void     configureFor433MhzOok();

  // Decode all Kerui packets from a captured edge buffer.
  // Returns true if majority vote succeeded; fills sensorId.
  bool decodeEdges(const uint32_t* ts, const uint8_t* lv, int n,
                   uint32_t& sensorId);

  bool initialised_ = false;

  // Rendered chip pattern. A MEMBER, not a stack local: at 10 repeats this
  // is 640 bytes and loop()'s ESP8266 cont stack has ~1.5KB total.
  static const int kMaxTxRepeats = 12;
  uint8_t txBits_[(Ev1527::kChipsPerFrame * kMaxTxRepeats + 7) / 8];

  void configureForTx();
  bool streamTxFifo(size_t numBytes);
};
