ariel-bentu/alarmSystem/(commit log)

2026-08-29 Bootstrap: Firebase web app, Cloud Functions, Telegram alerts
    Self-owned home alarm system replacing Tuya/Kerui cloud dependency.
    Full stack: React + TypeScript web UI (auth, sensor pairing, profiles,
    rules, operations, timeline, simulator), Cloud Functions (event ingest,
    server-side alarm evaluation, config sync, Telegram alerts, dead-sensor
    check, mintDeviceToken for device RTDB auth), Firebase RTDB + Firestore,
    invite-only access model, per-project Telegram config.
2026-08-29 Firmware: WiFi provisioning, alarm logic, CC1101 receive, ESP32-S3 port
    ESP8266 D1 Mini + ESP32-S3 edge controller firmware (PlatformIO).
    - WiFi provisioning portal (AP + captive DNS, LittleFS-persisted config)
    - CC1101 433MHz SPI receiver feeding Kerui OOK decoder
    - AlarmState: config-driven condition evaluation (immediate, count_in_window,
    entry_delay, multi_sensor), native-tested with Unity
    - EepromStore: arm state + config persisted across power loss
    - RelaySiren: GPIO relay with auto-off timer
    - CloudClient: Firebase custom-token auth (mintDeviceToken), RTDB polling
    for config + commands, event reporting; two TLS clients (heap constraint)
    - LocalWebServer: LAN arm/disarm + sensor si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
2026-08-29 Firmware: CC1101 transmit via FIFO; EV1527 siren paired and sounds hub-free
    CC1101 TX investigation and EV1527 siren control:
    - TX must use the FIFO in packet mode; async serial via GDO0 radiates
    nothing (-86 dBm at 10 cm vs -19 dBm via FIFO)
    - FREND0 (0x22) = 0x11 required: selects PATABLE[1] as carrier-on entry;
    without it the PA holds continuous carrier
    - Received pulse width tracks the gap, not the pulse; encode bit in
    carrier-off gap, keep keying pulse constant
    - Clean-room EV1527 rewrite from spec (spike_clean_tx): 1T sync + 31T
    gap, bit 1 = 3T ON, MSB first, T = 300 us, kCarrierBit = 1 (measured)
    - Siren paired directly to our CC1101 transmitter, hub-free; SOS and
    disarm com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
2026-08-29 Firmware + web: EV1527 TX in device firmware, cloud/LAN siren pairing
    Ported the proven EV1527 siren transmitter from spike_clean_tx into the
    device firmware, and added cloud + LAN pairing flows:
    Firmware:
    - ev1527_frame: pure EV1527 frame renderer, native-tested (7 tests)
    - siren_address: per-device base address, randomly generated once and
    persisted in EEPROM so a physical pairing survives reflashing
    - Cc1101Receiver::transmit(): blocking FIFO TX with full RX register
    restore so sensor decode works immediately after transmission
    - RelaySiren: drives siren over RF (EV1527 SOS/disarm) + GPIO relay;
    turnOff() transmits disarm command — RF siren sounds until told to stop
    - Cloud pairi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
2026-08-29 Firmware + web + functions: siren disable, sensor UX, dead-sensor alerts, device online dot, arm state sync
    - Siren disable: web UI toggle persisted to Firestore; buildConfig propagates e:bool to RTDB config;
    firmware gates siren on/relay on config.sirenEnabled; onProjectConfigChange Cloud Function rebuilds
    config when sirenEnabled changes
    - Unknown sensor UX: sort by lastSeen desc, collapse sensors older than 24h under accordion, bold +
    green dot for sensors seen in last minute (10s refresh)
    - Per-sensor dead alert: deadSensorAlertDays field (-1 = never); deadSensorCheck runs at noon, sends
    Telegram once per silence period (deadAlertSentAt cleared by onSensorEvent on next trigger)
    -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
2026-08-29 Alarm cause in Telegram + live alarm UI; paired-sensor recency; settings toggle fix
    Alarm cause (firmware + functions + web), verified end to end on hardware:
    - Device reports WHAT fired, not just that something did: AlarmState's
    onSensorEvent/tickEntryDelay gain an optional TriggerCause out-param, and
    CloudClient::reportAlarm writes state/alarm_cause before state/siren_active.
    Device-side alarms previously produced no Telegram message at all — the
    firmware never wrote siren_active.
    - onAlarm is the notifier for siren-firing alarms and resolves both cause
    shapes: {rfId, ct, at} from the device (name + covering rule looked up) and
    {label, at} from the server. Ignores a cause old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
    [alarm_state.cpp, alarm_state.h, cloud_client.cpp, cloud_client.h, main.cpp]
2026-08-29 Ops UI: separate SOS from the arm grid, add two-press safety, drop hover
    The arm buttons had three visual treatments carrying two unrelated meanings:
    the grid is a state selector (which profile is active) while SOS is an action
    with no selected state at all. Rendering SOS inside the grid meant a red
    button read as either "armed to something" or "tap to sound" depending on
    which neighbour you compared it against.
    - SOS moves out of .arm-grid into its own .action-row below a rule, small and
    aligned to the end rather than full-width. It sits under the Disarm button
    tapped on the way to bed, so it is deliberately the least prominent control.
    - SOS now requires two presses. The first only pr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
2026-08-29 Sensor pairing: show the pair form as a modal, not an appended card
    Clicking Pair on an unrecognised sensor rendered the name form as a <section
    class="card"> after the sensor list. With any real number of sensors that
    lands below the fold, so the tap appeared to do nothing, and the form was
    visually detached from the row that opened it.
    Now a native <dialog> opened with showModal(), which gives the top layer,
    ::backdrop, focus trapping and Esc-to-close from the platform instead of
    hand-rolled JS. onCancel/onClose both clear pairForm so React state cannot
    disagree with what is on screen, and the name input takes autoFocus since
    collecting that one value is the dialog's only purpose.
    No new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
2026-08-29 Profiles: one line per rule, sensor-name fallback, rule forms as modals
    Three fixes to the rule list, which was hard to scan.
    One line per rule. Each rule rendered as a four-line block (name, sensors,
    condition, then a button row), so a profile with a handful of rules read as a
    wall of text. Now a single .rule-row: name, condition, and the actions pushed
    to the end. The name truncates rather than wraps so a long one cannot push the
    buttons to a second line, and the condition is dropped below 30rem where the
    name and the actions are what matter.
    Unnamed rules take the sensor name. buildInitialRules creates one
    { name: "" } rule per sensor, so "(unnamed)" was the common case, not the edge
    ca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
2026-08-29 Pairing: optionally add an immediate rule to every profile
    A newly paired sensor was inert: it showed up in the list and logged events,
    but no profile referenced it, so arming did nothing with it until you visited
    every profile and added the same immediate rule by hand.
    The pair dialog now offers a one-time checkbox to create that rule in every
    profile. It reuses buildInitialRules — the same helper that seeds rules when a
    profile is created, so the two directions cannot drift — and rules are OR'd, so
    this never conflicts with a rule written later.
    Defaults on, since a sensor that triggers nothing is the surprising outcome.
    It is a one-shot action, not a setting: purely local component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
2026-08-30 Self-host Heebo so Hebrew renders correctly on Android
    Hebrew was misrendering on Android while looking correct on iOS: users
    read מנוטרל as מנוטל, and כ as ק. The strings were never wrong — the
    dictionary, the bundle and the DOM all held the correct text. The fault
    was entirely in rendering.
    The font stack was `system-ui, -apple-system, "Segoe UI", Roboto,
    sans-serif`. On iOS, -apple-system resolves to a properly hinted SF
    Hebrew. On Android, system-ui resolves to Roboto, which has no Hebrew
    coverage at all, so the platform fell back per-glyph to whatever Hebrew
    face it had. At our smaller sizes that fallback swallowed the strokes
    crossing the baseline — which is exactly w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
2026-08-30 Spec: scheduled arming
    A schedule is a window — arm time (optional), disarm time (required),
    profile and side. Optional arm covers manual-arm/auto-disarm.
    One new scheduled function ticking every minute, kept cheap by
    precomputed next-fire timestamps; fits the 3-job Cloud Scheduler free
    tier alongside deadSensorCheck.
    Edges fire, they never enforce state, so a manual override is never
    undone by the scheduler.
    UI is phone-alarm-shaped and lives on Operations, since "when does it
    disarm" is an operational question.
2026-08-30 Telegram: arm/disarm and command replies are silent notices
2026-08-30 Pure next-occurrence module with DST handling
    Probes the candidate offsets either side of the wall clock rather than
    iterating guess-then-correct: that convergence lands on the LATER of a
    repeated time, breaking the fire-once rule.
    Gap instants are binary-searched at minute resolution. offsetMinutes is
    minute-truncated, so a finer search goes unstable and converges minutes
    before the real transition.
2026-08-30 Spec: always-on rules
    A per-rule `always` flag, not a built-in always-on profile: ten sites
    enforce one-active-profile, and a permanently-active profile breaks that
    invariant at every one of them. A flag adds no new concept.
    Always-rules must be collected across ALL profiles — buildConfig ships
    only the active profile's rules today, so a smoke rule in an inactive
    profile would never reach the device. That cost is identical in either
    design, so it does not favour one.
    Struct sizes measured, not assumed: bool always lands in existing
    padding, Config stays 2416 bytes, so the EEPROM layout is unchanged.
2026-08-30 Spec: always-on rules are single-sensor immediate only
    Removes the entry_delay contradiction rather than documenting around it,
    and makes the device change one line: an immediate condition carries no
    runtime state, so there is no trigger history to reason about while
    disarmed.
    The editor coerces rather than validates, following the existing
    sensor-count coercion in RuleEditor.
2026-08-30 Firmware: always conditions fire while disarmed
    The single arm gate becomes a per-condition skip. `continue` rather than
    an early return matters: evaluateCondition records trigger history as a
    side effect of being called, so skipping the call is what keeps ordinary
    conditions from accumulating a backlog while disarmed.
    static_assert pins sizeof(Config) at 2416 — `always` lands in the padding
    that already followed Condition::kLen, verified under xtensa, so the
    EEPROM layout is unchanged.
    [alarm_state.cpp, alarm_state.h, config_parser.cpp]
2026-08-30 Rule editor: always-on checkbox with immediate coercion
    Ticking always coerces to a single-sensor immediate condition and hides
    the type selector, so an invalid combination is unrepresentable rather
    than rejected on save. With 2+ sensors the sensor-count coercion wins and
    always is disabled, so the two never fight.
    handleAddRule now resets via closeAddRule instead of repeating the field
    list — the duplicate reset omitted newRuleAlways, which would have leaked
    always:true into the next rule added.
2026-08-30 Operations: note always-on rules beside the arm state
2026-08-30 Clear always-on when a rule gains a second sensor
    Disabling the checkbox was not enough: the flag stayed set, so the rule
    saved as an always-on multi-sensor rule that the user could neither see
    nor undo — the control that would show it is the one just disabled.
    The flag is now cleared and a warning explains it, rather than a passive
    hint about a greyed-out box. The threshold lives in
    alwaysAllowedForSensorCount alongside the other rule reconciliation.
2026-08-30 Add rule: a + on the Rules heading
    The button sat below the rule list, so on a profile with several rules it
    drifted down the card, away from the thing it adds to. It now sits on the
    heading via a reusable .section-head row.
    The accessible name keeps the profile ("Add Rule to Away") — with one such
    button per profile card, a bare "+" would be ambiguous to a screen reader.
2026-09-02 Firmware: task watchdog, boot-reason reporting, WiFi supervision
    A board was found dead after 9h16m uptime — powered, LED on, off WiFi, off
    the LAN web server, and with its USB serial port gone from the host. Only a
    power-cycle revived it, ~28 hours later. Nothing in the firmware could have
    recovered it and nothing recorded why it died.
    Root cause is still unknown. This is instrumentation, not a fix.
    - platformWatchdogBegin() subscribes loopTask to the TWDT (30s, panic=true);
    loop() feeds it first thing, covering the portal path too. Arduino-ESP32
    does NOT subscribe loopTask by default, so any hang was previously
    permanent. Uses the OLD esp_task_wdt_init(seconds, panic) API — the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
    [cloud_client.cpp, cloud_client.h, main.cpp, platform_compat.h]
2026-09-02 Device offline / back-online Telegram alerts
    Nothing watched the CONTROLLER. deadSensorCheck watches sensors, so a device
    that died stayed silent — the 28-hour outage produced no alert of any kind.
    A dead controller while armed means the premises are unmonitored, which is
    worse in kind than one dead sensor.
    - onHeartbeat (RTDB trigger on state/last_seen) stamps
    projects/{id}.device.lastSeen with SERVER wall-clock time. Required
    because the value the device writes is uptime, not epoch: "33365" says it
    had been up 9h16m but not when, so no reader could tell a live device from
    one that died yesterday. A trigger, not a poll — no scheduler slot.
    - checkDeviceLiveness(): 5min threshol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
2026-09-02 One scheduled function: doSchedule dispatches a task table
    Cloud Scheduler allows only 3 free jobs per BILLING ACCOUNT, and one
    onSchedule() per task burned that budget fast enough that adding periodic
    work became a deployment decision rather than a code change.
    doSchedule is now the ONLY scheduled function: every 1 minute, dispatching a
    declarative cron-style table. scheduleTick, deadSensorCheck and the device
    liveness check become plain async callbacks. Adding periodic work is now one
    table row.
    - Fields are "*" / a number / an array, matched by pure tested helpers
    (9 tests). matchField compares numerically so weekDay 0 (Sunday) and
    hour 0 (midnight) match rather than reading as fals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
2026-09-02 Web: surface an unexpected device restart on Operations
    A device that crashes and reboots looks EXACTLY like one that never left —
    it reconnects, resumes heartbeating, and the UI goes green again. The only
    trace is state/boot.reason.
    - useDeviceState subscribes to state/boot; OperationsPage banners any
    restart that was not human-initiated (panic, twdt, brownout).
    - Dismissal is keyed by the boot timestamp and persisted, so it survives a
    reload but a NEW crash still shows — same shape as the alarm ack.
    - 24h window, because the boot node persists until the next boot overwrites
    it and the banner would otherwise be permanent.
    - bootReasonKey returns a TranslationKey, so a typo is a c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
2026-09-02 Docs: split CLAUDE.md history into docs/history, add testing guide
    CLAUDE.md had grown to 746 lines, most of it dated investigation narrative —
    including 170 lines about the abandoned ESP8266. That buries the parts an
    agent actually needs at the top of a session.
    Now 195 lines: architecture, data layout, commands, key decisions, and an
    index into seven history docs. Nothing is deleted — the measurements cost
    days and are still there, one file per investigation, linked from a table
    that says what each one covers.
    Also adds docs/testing-device-liveness.md: what to verify for the watchdog,
    boot reporting, WiFi supervision, offline alerts and scheduler
    consolidation, including the deploy s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
2026-09-02 Firmware: verify watchdog setup, feed it during blocking WiFi calls
    Two gaps from a review of the watchdog work.
    1. esp_task_wdt_init/add return codes were discarded, so nothing verified
    the watchdog was configured as documented. The core builds with
    CONFIG_ESP_TASK_WDT=y and CONFIG_ESP_TASK_WDT_TIMEOUT_S=5, i.e. the TWDT
    is already running on a 5s period before we touch it. This API updates
    the timeout when already initialised (ESP_ERR_INVALID_STATE is not among
    its returns), so 5s -> 30s does apply — but that was assumed rather than
    checked. Both codes are now inspected and the effective config is printed
    once at boot. A future core change now announces itself inste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
2026-09-02 Fix: firing the arm edge destroyed the pending disarm
    A schedule of arm 16:23 / disarm 16:26 armed correctly and then never
    disarmed. The house stayed armed for 24 hours with nothing logged — no
    error, no warning, no skip. Observed in production 2026-09-02.
    Cause: advance() recomputed and wrote BOTH nextArmAt and nextDisarmAt after
    handling EITHER edge. nextDisarmInstant() anchors the disarm to `armAt`, so
    once the arm had fired and armAt became TOMORROW's arm, the disarm derived
    from it was tomorrow's too. The 16:26 disarm still owed by the cycle that
    had just started was overwritten before it could ever become due, so the
    collection-group query never matched it and decideEdge was never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
2026-09-02 Fix: schedule time range renders reversed in Hebrew
    "16:48 → 16:45" painted as "16:45 ← 16:48" in the RTL layout — the window
    read backwards and the arrow appeared to point the wrong way.
    Both times and the arrow are bidi-neutral characters, so inside an RTL
    paragraph the Unicode bidi algorithm reorders the runs. The string was
    always correct; only its painted order was not, which is why the existing
    unit tests could not catch it.
    The arrow encodes arm -> disarm order, not reading order, so unlike the
    surrounding layout it must NOT mirror. Applies the existing `.ltr` utility
    (already used for hex rfIds, same root cause) to that span.
    Also corrects the Schedules CSS comment, which de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
2026-09-02 Fix: onScheduleChange overwrote the pending disarm 0.5s after arming
    The previous fix (64d2a6c) was correct but incomplete: it fixed one writer
    of nextArmAt/nextDisarmAt and left the other.
    onScheduleChange triggers on ANY write to the schedule document — including
    scheduleTick's own lastFiredAt write when an edge fires. Observed in
    production 2026-09-02 on a 16:45 -> 16:48 schedule:
    16:45:34.390 scheduleTick fires the arm, advances only nextArmAt,
    correctly leaving nextDisarmAt at TODAY 16:48
    16:45:34.996 onScheduleChange runs, recomputes BOTH from now, and
    overwrites nextDisarmAt with TOMORROW 16:48
    nextDisarmInstant derives the disarm from armAt,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
2026-09-02 Perf: cut the PWA's cold-load critical path from 215KB to 95KB
    The app was already a well-formed PWA, but first load and post-deploy load
    were slow for three measured reasons.
    Cache headers. firebase.json declared no `headers` block, so Hosting applied
    its default max-age=3600 to everything: content-hashed assets were revalidated
    hourly for no reason, while index.html was cached for an hour too, delaying
    deploy pickup by up to 60 minutes.
    Two traps found by deploying and reading the live headers, both now documented
    inline. `headers` is LAST-match-wins — the opposite of `rewrites`, and not
    stated in the docs — so the `**` catch-all must come FIRST or it flattens the
    immutable asset rul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
2026-09-02 feat: notify on device-originated arm/disarm
    state/armed had no trigger, so disarming via alarm.local produced no
    Telegram and no timeline entry. Adds onDeviceArmStateChange with
    suppression so cloud-initiated changes are not reported twice.
    Pure decision logic lives in deviceArmNotify.ts so tests can import it
    without ./admin, which needs a live Database URL at module scope.
2026-09-02 feat: decode remote identity and button nibble
2026-09-02 feat: dispatch remote presses to arm/disarm/SOS
    Paired remotes return early from pollCc1101 so they can never reach the
    sensor path or satisfy an alarm rule. SOS reports via reportAlarmLabel
    ({label, at}) rather than inventing a synthetic rfId. Arm state changes
    now carry a source, written before state/armed so the notification
    function finds it.
2026-09-02 feat: push paired remotes to the device via config.m
    Remotes are loaded before rebuildConfig's early return so a project with
    no rules still gets them. applyPendingConfigUpdate merges rather than
    replaces, so a remote paired locally over LAN is not erased by the next
    cloud config push.
    [config_parser.cpp, main.cpp]
2026-09-02 feat: remotes pairing UI
    Pairing collapses the four button codes onto one 20-bit identity, so
    pressing any button pairs the whole remote. Button legend is documented
    rather than editable — the mapping is fixed in firmware.
2026-09-02 docs: first captured watchdog reboot — reason=twdt
    Read from RTDB before flashing. Establishes that the watchdog works on
    real hardware, that the hang is on loopTask, and that it is not
    time-based (~70min uptime vs the 28-31h silent deaths).
2026-09-02 feat: remotes tab uses the unrecognised-list pattern from sensors
    Replaces the blind 30s pairing window with a persistent candidate list,
    matching how sensors are paired: live from RTDB events, freshness dot,
    last seen, event count, per-row Pair button.
    Candidates are grouped by 20-bit identity so one keyfob is one row
    rather than up to four — and a Buttons column shows how many distinct
    buttons were heard, which is what distinguishes a real remote from a
    single-button sensor.
2026-09-02 fix: remotes tab gated on the wrong arm flag
    Pair was disabled by project.serverArmed — the SERVER-side flag, and one
    OperationsPage already documents as a stale one-shot getDoc. Pairing is
    refused by the DEVICE based on its own arm state, so read that live from
    RTDB via useDeviceState instead.
    Also surface the blocked reason above the table: a disabled button that
    does nothing on click reads as broken.
2026-09-02 fix: remote pairing form is a modal with a real name placeholder
    Inline it rendered below the candidate list, so tapping Pair looked like
    nothing happened — the same failure SensorsTab's dialog comment already
    documents. Reuses that native <dialog> pattern.
    Placeholder was the identity (0xE45CA), which read as if the hex was the
    expected input; now an example name.
2026-09-02 fix: allow admins to write the remotes collection
    The collection was new, so it fell through to deny and pairing failed
    with permission-denied. Mirrors the sensors rule: members read, admins
    write — a paired remote can arm, disarm and sound the siren.
2026-09-02 feat: remote control full integration — arm/disarm sync + SOS alarm state
    - onRemoteChange: rebuilds RTDB config when remotes collection changes so
    device receives the m[] array without a manual profile edit
    - onDeviceArmStateChange: syncs Firestore isActiveOnDevice and commands/armed
    when device arms or disarms via remote, so web UI reflects device reality
    - onArmStateChange: stores commands/armedProfileId in RTDB on web arm so
    onDeviceArmStateChange knows which profile to restore on remote re-arm;
    skips duplicate timeline/Telegram when write is a sync (state already matches)
    - RemotesTab: explicit refreshRemotes() after pair/unpair so list updates
    immediately without waiting fo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
    [cloud_client.cpp]
2026-09-02 fix: only sync Firestore on device-originated arm/disarm, not cloud echoes
    Keying on state/armed_by ("remote"/"local" vs "cloud") prevents the boot
    loop where the device boots armed, onDeviceArmStateChange sets commands/armed
    back to true, the device polls it and re-arms, and the function fires again.
    Also suppress duplicate onArmStateChange timeline/Telegram when that write
    is just a sync (state already matches commands).
2026-09-02 fix: bound blocking Firebase calls, and persist the siren address to the cloud
    Two independent field failures: the device occasionally got stuck, and a
    physical siren pairing was lost because the address was never stored anywhere
    but EEPROM.
    --- 1. Occasional hang ---
    CloudClient::loop() calls database_.get<String>(), which is SYNCHRONOUS: it
    blocks inside loop() in
    while (!sData->response.tcpAvailable()) { sys_idle(); ... }
    and sys_idle() on ESP32 is delay(0) — it yields to FreeRTOS but does NOT feed
    the task watchdog. Left unconfigured, that wait is bounded only by the
    library's own FIREBASE_TCP_READ_TIMEOUT_SEC / _WRITE_TIMEOUT_SEC, both 30s,
    because setSyncReadTimeout()/setSync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
    [cloud_client.cpp, cloud_client.h, config_parser.cpp, main.cpp]
2026-09-04 fix: recover from a dead auth session instead of going silently cloud-dead
    CloudClient::tokenMinted_ was a one-way latch: set true on the first
    successful mint (cloud_client.cpp:395) and never reset anywhere. The re-mint
    path at the top of loop() is guarded by `if (!tokenMinted_)`, so once
    app_.ready() went false for good, loop() returned early at `if (!appReady_)
    return;` every iteration, forever.
    The device kept feeding the watchdog, decoding RF, evaluating rules, driving
    the siren and serving the LAN UI — while writing NOTHING to the cloud, with
    no recovery short of a power cycle.
    --- Why the watchdog never caught it ---
    The TWDT watches for a BLOCKED loopTask. This failure leaves lo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
    [auth_supervisor.h, cloud_client.cpp, cloud_client.h]
2026-09-04 fix: cap the TLS handshake timeout, which was double the watchdog budget
    Two twdt reboots 45 minutes apart on 2026-09-04, on a build that ALREADY
    capped the FirebaseClient sync read/write timeouts at 5s. Capping those was
    necessary but not sufficient: they bound reads and writes on an ESTABLISHED
    socket and do NOT cover the connect that precedes them.
    FirebaseClient's SlotManager::connect() calls straight through to
    WiFiClientSecure::connect(), whose Arduino-ESP32 defaults are
    handshake_timeout = 120000 ms <-- DOUBLE kWatchdogTimeoutSec (60s)
    _timeout = 30000 ms
    and neither client ever called setHandshakeTimeout()/setTimeout(). Only the
    MINT client did (kMintSocketTime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
    [cloud_client.cpp, cloud_client.h, main.cpp, relay_siren.cpp, relay_siren.h, siren_policy.h]
2026-09-04 docs: record the TLS handshake / watchdog root cause
    Fault #1 from watchdog-and-offline-alerts.md is no longer open. Records the
    120s-vs-60s arithmetic, why the 09-02 sync-timeout fix did not cover the
    connect phase, the units trap on the ESP32 setters, and how to confirm or
    refute the fix from the Explore timeline.
2026-09-04 perf(web): fix asset caching, overlap SDK warm-up, centre loading states
    Investigated warm-load performance from a HAR capture. The headline finding
    was a false alarm, and one real regression was found and fixed on the way.
    Cache-Control for the Workbox runtime. It is content-hashed but emitted at
    the ROOT, so the /assets/** immutable rule missed it and the `**` catch-all
    left it no-cache — a network revalidation on every service worker boot
    (387ms, now 116ms served from cache).
    Precache the shell only. globPatterns swept in all 31 emitted files (1.1MB),
    including the 391KB Firestore chunk, the 166KB RTDB chunk and every lazy
    route — eagerly installing chunks a signed-out visitor never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
2026-09-07 fix(device): bound the blocking DNS and dead-socket reads that hit the watchdog
    Two remaining ways a synchronous cloud call could block loopTask past the 60s
    task watchdog. Both yield to FreeRTOS without feeding the TWDT, which is the
    same trap as the 120s TLS handshake and sys_idle()/delay(0).
    Blocking DNS: WiFiClientSecure::connect(host, port) resolves through
    WiFi.hostByName() before the connect/handshake caps apply — waitStatusBits
    gives 16s for DNS_IDLE plus 15s for DNS_DONE, so ~31s worst case inside
    connect(). reportAlarm() does two sequential set() calls, so ~62s, enough to
    reboot a healthy device mid-alarm. lwIP's cache is 4 entries with short
    server-set TTLs, so warming it only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
    [cloud_client.cpp, cloud_client.h, host_resolver.h, io_deadline.h, ssl_client_with_dns.h, test_io_deadline.cpp]
2026-09-07 feat(device): dump where loop() is stuck 20s before the watchdog reboots it
    Every hang so far has been diagnosed by inference. The 60s TWDT panic should
    print a backtrace, but on the S3 the USB-Serial/JTAG stops enumerating the
    instant the CPU halts, so the host usually loses it — which is why the twdt
    reboots were identified from timeout arithmetic and RTDB state/boot rather than
    from the board saying anything.
    StallMonitor runs on the other core, watches a counter loop() bumps once per
    iteration, and at 40s — while USB is still alive and a full 20s before the
    panic — dumps the phase the loop is stuck in. It never reboots or recovers:
    platformWatchdogBegin still owns that. This only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
    [cloud_client.cpp, main.cpp, stall_detector.h, stall_monitor.h]
2026-09-07 docs: the 23h run proves the watchdog, DNS and dead-socket fixes
    Every fix in tls-handshake-watchdog-reboot.md was marked unproven, because an
    intermittent failure is only confirmed by silence. A 23h16m unattended run on a
    single power_on boot supplied it: no twdt reboots, no stall dumps, no forced
    re-mints, heap flat at 180,784 after 23h versus 180,792 at 2h.
    The DNS result is the sharpest. Five resolutions across ~8,300 heartbeats, one
    per host and all cached, where the old path ran a blocking hostByName() per
    connect. securetoken.googleapis.com resolved exactly once, which also shows the
    hourly token refresh running without paying a DNS stall each time.
    85 transient socket errors all re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
2026-09-07 fix(timeline): stop labelling a cloud arm as "Remote <profile>"
    Arming from the web UI or a schedule produced a timeline row reading
    "Remote Night" — naming a remote control that was never used. In Hebrew,
    "שלט Night".
    Two functions write arm/disarm rows into the SAME sensorName field with
    different meanings: onDeviceArmStateChange stores the remote's name,
    onArmStateChange stores the PROFILE name. eventSubject() assumed anything
    that was not the literal "Remote"/"Device" had to be a remote, so every
    cloud-initiated arm was attributed to hardware that never acted.
    Display-only — the stored attribution was always correct (armed_by,
    parseArmSource, and formatArmStateBySource all key o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
2026-09-07 fix(device): timestamp sensor packets after the blocking cloud call
    A 2-of-3 rule with a 10s window fired on triggers 10.7s and 11.3s apart.
    loop() captured `now = millis()` at the top, then called cloudClient.loop()
    — a BLOCKING poll/write (DNS, TLS handshake, synchronous get/set, bounded
    only by kSyncTimeoutSec) — and passed that pre-block value to
    pollCc1101(). A packet decoded after the network call was therefore dated
    to before it. When two packets are delayed by different amounts their
    apparent gap shrinks, and a pair genuinely outside the window looks inside
    it.
    This corrupted every windowed condition, not just multi_sensor:
    pollEntryDelay() and siren.tick() were also being told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
    [main.cpp]
2026-09-07 fix(device): do not mint a siren address while a config push is pending
    An EEPROM wipe cost the physical siren pairing twice on real hardware,
    despite the recovery path that exists precisely to prevent it.
    hasReceivedConfig() and hasPendingConfigUpdate() are both set by the same
    applyConfigJson() call, but loop() checks the generation condition BEFORE
    applyPendingConfigUpdate() — which is what actually adopts the cloud's
    address — runs later in the same iteration. So on the first poll after a
    wipe the device saw "config received, still no local address", minted a
    fresh one microseconds before adopting the correct one, then reported it
    up and overwrote the good value in Firestore.
    The e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
    [eeprom_store.h, main.cpp]
2026-09-07 feat(rules): multi_sensor quorum ("2 of 3"), and fix two bugs it exposed
    A multi_sensor rule required EVERY sensor to reach its per-sensor count
    inside the shared window — a hard AND. With three or more sensors that is
    often too strict: the useful rule is "any 2 of these 3 corroborate each
    other", which cuts false alarms without demanding that every sensor in a
    zone fire.
    A sensor is SATISFIED when it reaches its own count (counts[sensorId],
    default 1) within the window; the rule fires when at least `quorum`
    sensors are satisfied. Counted per sensor, so repeated triggers on one
    sensor satisfy it once and never add to the quorum. Absent quorum means
    all sensors — exactly today's AND —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
    [alarm_state.cpp, alarm_state.h, config_parser.cpp]
2026-09-08 fix(device): unblock loop() when the TLS socket is closed under a read
    A twdt reboot recurred on 2026-09-08 05:09 (state/boot, corroborated by
    last_seen uptime) and again in the 09-07 soak log, which caught it live:
    19:07:51 _handle_error(): [data_to_read():361]: (-76)
    19:08:32 *** [stall] loopTask has not progressed for 40968ms —
    phase='cloud:poll-config' ***
    19:08:51 task_wdt: loopTask (CPU 1) ... Rebooting
    This is the fault IoDeadline was added to fix, and it did not fire once:
    "[io] socket stalled past deadline" is absent from the whole log.
    Root cause, from WiFiClientSecure.cpp:240-252: on a hard mbedTLS error the
    base available() calls its OWN stop() — a non-vir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
    [io_deadline.h, ssl_client_with_dns.h, test_io_deadline.cpp]
2026-09-08 test(device): unattended raw serial logger for multi-day soaks
    `pio device monitor` needs a TTY and dies with
    `termios.error: (19, 'Operation not supported by device')` when backgrounded,
    so an unattended soak cannot use it. The 2026-09-08 twdt reboot lost its serial
    trace for the related reason: the monitor left running used `-f time` with no
    `-f log2file` and wrote nothing to disk.
    This writes every line unfiltered, timestamped and flushed per line, and
    reopens the port when the S3's native USB-Serial/JTAG drops on panic and
    re-enumerates on reboot — which is the normal path during a stability soak,
    not an error. read_serial.py stays as-is: fixed duration and noise filtering
    suit bring-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
    [soak_logger.py]
2026-09-09 fix(device): the torn-down TLS fd is 0, not -1 — previous fix never matched
    The 2026-09-08 fix shipped, ran 18.36h, and rebooted with the identical
    signature it was meant to prevent:
    04:18:00 _handle_error(): [data_to_read():361]: (-76)
    04:18:40 *** [stall] loopTask has not progressed for 40802ms —
    04:19:00 task_wdt ... Rebooting (ELF c883c326 = that build)
    Neither bound logged anything: 1 x -76, 0 x "socket closed under an
    in-flight read", 0 x "socket stalled past deadline". So the detection never
    fired and socketClosed() was never reached.
    Root cause of the miss is a sentinel value. ssl_client.cpp stop_ssl_socket()
    sets socket =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
    [ssl_client_with_dns.h, ssl_socket_state.h, test_io_deadline.cpp]
2026-09-09 docs: draft upstream issue for the sync read-timeout hang
    Root cause of the -76 / twdt reboots, traced to FirebaseClient's sync
    read-response loop (AsyncClient.h:1131-1153): feedTimer() is called at the top
    of every iteration and handleReadTimeout() checks remaining()==0 a few lines
    later in the SAME iteration, so the deadline is reset immediately before it is
    read. That bounds one slow receive() but cannot bound a loop that iterates
    quickly without progressing — which is what happens once the peer drops a
    keep-alive connection and available() returns 0 forever.
    Includes timer_repro.cpp: the Timer class copied verbatim from v2.2.13 with a
    controllable millis(), so the maintainer can repro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
2026-09-09 docs: harden the upstream issue after adversarial review
    An agent briefed as the maintainer (cold context, upstream sources only, told
    to attack) accepted the core defect but broke several supporting arguments.
    Fixed all of them:
    - The "fast spin" framing was wrong and invited a rebuttal that does not apply.
    Iteration rate is irrelevant: feed() -> setInterval() -> reset() recomputes
    `end = ts + period` from the current ts, so `end - ts == period` after every
    feed() and ready() (ts >= end) is never true. Swept 1/50/101/150/1000ms —
    never expires at any rate, including above Timer::loop()'s 100ms guard.
    - Added the contrast at AsyncClient.h:1118-1124: the other sync wait has no
    fe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
2026-09-09 fix(device): return a POSITIVE from available() so the library tears down
    The previous two fixes returned a NEGATIVE from SslClientWithDns::available().
    That breaks `while (!tcpAvailable())` at AsyncClient.h:1118 — but that loop was
    never the broken one: it has no in-loop feedTimer(), its timeout works, and it
    exits correctly.
    The loop that actually hangs (AsyncClient.h:1131) never calls available()
    directly. It reaches it only through the gate at AsyncClient.h:452:
    if (sData->response.tcpAvailable() > 0) { readHeader(); readPayload(); }
    A negative fails `> 0` exactly like 0 does, and nothing in FirebaseClient
    treats available() < 0 specially (every use is `> 0` or `== 0`). So both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
    [ssl_client_with_dns.h, ssl_socket_state.h, test_io_deadline.cpp]
2026-09-09 build(device): patch FirebaseClient's unbounded sync read loop at build time
    Fixes the actual defect rather than only steering around it from the Client
    side. patch_firebase.py runs as a pre: extra_script on [env:esp32s3] and
    rewrites the read-response loop in .pio/libdeps so the read timer is fed only
    when the iteration made progress (respCtx.totalRead increased or respCtx.stage
    advanced), instead of unconditionally at the top of every pass.
    Upstream, feedTimer() resets the deadline three lines before
    handleReadTimeout() reads it, so it can never be expired when checked —
    Timer::feed() -> setInterval() -> reset() recomputes `end = ts + period` from
    the current ts, making `end - ts == per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
    [patch_firebase.py]
2026-09-09 fix(device): only check for a dead socket while an operation is in flight
    Flashing the previous commit produced three `[io] socket closed under an
    in-flight read (rc=0 fd=-1 / fd=0)` lines during a completely healthy boot,
    from the mint and app-startup clients. Those are IDLE clients between
    operations: a client that has not connected yet legitimately has no socket.
    Functionally harmless — the device ran normally — but it destroys the field
    signal. That log line exists so a multi-day soak can be grepped to tell a real
    caught hang from ordinary reconnects, and boot noise makes it useless for
    exactly the run it was added for.
    IoDeadline already tracked the distinction; it just wasn't exp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
    [io_deadline.h, ssl_client_with_dns.h, test_io_deadline.cpp]
2026-09-10 docs: record the proven read-timeout fix; correct the 23h-run claim
    The 18.16h soak (2026-09-10) absorbed four -76 socket deaths with zero
    reboots, each recovering in ~5s — the configured setSyncReadTimeout(5) finally
    firing, against 40.8s-to-watchdog before. Both previous builds rebooted on
    their first -76, at 10.0h and 18.36h.
    - New docs/history/firebaseclient-sync-read-timeout.md: root cause, the two
    wrong fixes (fd sentinel is 0 not -1 after the memset; a negative from
    available() fails the `> 0` gate exactly like 0), the library patch and why
    it must fail the build, and the proven numbers.
    - CLAUDE.md: stability section now cites this run, test count 98 -> 127, new
    history-ta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
2026-09-10 docs: record upstream issue mobizt/FirebaseClient#333
    Filed 2026-09-10, open. Cross-referenced from every place that will matter
    later:
    - docs/history/firebaseclient-sync-read-timeout.md — the issue link, plus the
    retirement condition: if #333 lands, raise the lib_deps floor and delete the
    patch script.
    - patch_firebase.py and platformio.ini — the link sits next to the patch
    itself, which is where someone lands when the build hard-fails after a
    library update.
    - CLAUDE.md "Next" — now tracks #333 rather than "file the issue".
    - docs/upstream/ISSUE.md — filed-marker at the top so it reads as the
    submitted text, not a live draft.
    [patch_firebase.py]
2026-09-16 docs: prepare the repo for public release
    Adds the documentation and licensing a public repo needs, and removes the
    last personal identifiers from tracked files.
    New:
    - README.md — overview, architecture diagram, hardware + cost, setup for
    firmware/Firebase/web, remote controls, screenshots from a live install
    - LICENSE — MIT
    - SECURITY.md — threat model and the known-issues list, including the
    fixed-code RF replay exposure and the unauthenticated LAN endpoint
    - CONTRIBUTING.md — how to run the three test suites, plus the house rules
    that are easy to violate (never validate the siren encoder against our
    own decoder; don't add a second onSchedule)
    Moved: the firmware-review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
2026-09-23 perf(web): drop the auth iframe from the cold-start path
    Auth is initialised eagerly because resolving signed-in-ness gates the
    first paint (see the header in lib/firebase.ts). That makes whatever it
    does before settling the thing every cold start waits on — and getAuth
    attaches browserPopupRedirectResolver eagerly, whose
    _shouldInitProactively is true on mobile browsers, Safari and iOS. On
    exactly those devices the SDK awaits loading a cross-origin iframe
    against the auth domain BEFORE it begins restoring the session, and
    onAuthStateChanged cannot fire until the chain finishes. Gate() sits on
    its spinner through all of it, with the session reload and
    provisionUser still queued behind.
    It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
2026-09-23 feat(web): disarm over the LAN alongside the cloud command
    A mistakenly sounding siren is silenced by whichever path reaches the
    device first, so a device-side disarm now also fires a best-effort POST
    to the firmware's own /disarm endpoint.
    No firmware change backs this: LocalWebServer already serves /disarm,
    and it already silences — handleDisarm() queues applyArmedCommand(false),
    which calls siren.turnOff(). Disarm and "silence the siren" are the same
    effect on this device, so no new endpoint was needed.
    The call goes out before any awaited write, which is the whole point —
    it must not sit behind a Firebase round-trip. It is unobservable by
    construction (void return, no throw, no unh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
2026-09-23 docs: design for battery replacement tracking
    Records when each sensor's battery was last replaced, shows its age, and
    Telegrams once when a battery passes a project-wide threshold.
    Three decisions worth keeping visible:
    - Age falls back to pairedAt when no replacement has been recorded. The
    alternative (skip unrecorded sensors) inverts the incentive: the ones
    nobody got round to recording are exactly the ones likely to hold a
    dying battery, and those would be the ones that never alert. The cost
    is a burst of alerts on first deploy for long-paired sensors, which is
    correct — those batteries really are old.
    - The threshold is project-level, not per-sensor. Every sensor here is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
2026-09-23 docs: implementation plan for battery replacement tracking
    Seven TDD tasks, each leaving the tree green. Tasks 1-5 (web) are
    independently useful: recording and seeing battery age has value before
    any alert exists, so the functions work in 6-7 can be deferred.
    Records the traps found while reading the code, so the implementer does
    not rediscover them:
    - Date.parse("2026-09-23") is UTC midnight, which is the previous day in
    Asia/Jerusalem. Both converters must work in local time, and the wrong
    version passes a UTC CI run — hence explicit tests.
    - batteryStartedAt (web) and batteryStartedAtMs (functions) are separate
    on purpose; the packages share no module, like types.ts.
    - `??` not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
2026-09-23 feat(types): battery replacement date and alert threshold fields
    Optional and nullable so existing sensor and project docs keep working.
    Mirrored by hand into both type files, which have no shared package.
2026-09-23 feat(web): pure battery age and date-input logic
    Age falls back to pairedAt when no replacement is recorded, so every
    sensor has an age from day one rather than silently never ageing.
    Both date converters work in local time on purpose: Date.parse of a bare
    yyyy-mm-dd is UTC midnight, which is the previous day in Asia/Jerusalem,
    and toISOString() has the same bug in the other direction. Pinned by
    tests, since the wrong version looks correct in a UTC CI run.
    The i18n keys these format strings reference land in the next commit, so
    `npm run lint` reports three unknown-key errors at this commit alone.
2026-09-23 i18n: battery replacement date strings (en + he)
    Parity is enforced by tsc, not a runtime test: he.ts is typed
    Record<TranslationKey, string>, so a key in one file and not the other
    fails the typecheck.
2026-09-23 feat(web): record and show each sensor's battery change date
    Inside the existing Battery cell rather than a sixth column: status and
    age are the same subject, and the table already scrolls on a phone.
    The write clears batteryAlertSentAt alongside the new date, which is what
    re-arms the stale-battery alert for the next battery.
2026-09-23 feat(web): project-wide battery age alert threshold
    One project setting rather than one per sensor: every sensor here is
    Kerui with the same battery life. Absent means 12 months; 0 disables.
    The import of DEFAULT_BATTERY_ALERT_MONTHS is relative, not "@/...":
    it is the first VALUE import across feature directories in this layer
    (the existing "@/" lines here are all `import type`, erased before
    runtime), and the alias does not resolve when Vitest loads the module
    as a dependency of its test.
2026-09-23 feat(functions): stale-battery decision logic
    Pure and unit-tested, like deviceOnline.ts; the Firestore walk comes next.
    Fires once per battery via a batteryAlertSentAt marker, since the battery
    stays old until replaced and a naive check would alert every noon.
2026-09-23 feat(functions): Telegram once when a sensor battery is overdue
    Joins the sensor loop already inside deadSensorCheck rather than adding a
    pass or a scheduled job: doSchedule's table is unchanged and the
    3-free-jobs-per-billing-account limit is untouched. Only that row's desc
    changed, since the callback now does three things.
    The battery check runs BEFORE the dead-sensor block, which continues on
    several conditions a stale battery should still be reported under. A
    sensor can be both dead and battery-stale and gets one message for each.
    Expect a burst on the first noon after deploy: sensors paired longer ago
    than the threshold with no recorded change date are aged from pairedAt
    and are immed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
2026-09-23 docs: design for sensor event families (20-bit identity)
    A Kerui packet is 20 bits of identity + a 4-bit event code, but the whole
    24-bit value is currently treated as the identity. So one physical sensor
    shows up as several unrelated ones, and 0x0061DB (a tamper) never matches
    the paired 0x0061DA it belongs to.
    The event table was measured against the live database (214 events, 10
    sensors) and cross-checked with rtl_433's kerui.c. Worth knowing: EV1527
    has no notion of these event names — the chip just latches data pins, so
    the nibble meaning is vendor-defined per model. The table is a local
    finding, not a spec, and 0x9 (curtain) is ours alone, undocumented
    anywhere and confirmed only by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
2026-09-23 docs: add migration section to the sensor-families design
    Audited the live project instead of assuming, which changed three things.
    Rules and schedules need NOTHING: all 12 rules reference Firestore
    sensorIds and condition.counts is undefined in every one, so no rule or
    profile is rewritten. Verified against data, not just by reading code —
    had counts been keyed by rfId, every multi-sensor rule would have needed
    migrating.
    Events are left alone, deliberately: the 3,089 Firestore events are an
    append-only record where rfId is a true statement about what arrived, and
    the RTDB /events/{rfId} keys must keep the full 24-bit code because the
    event nibble IS the information the pairing UI and t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
2026-09-23 docs: close the two open questions in the sensor-families design
    0x2E5B73 is paired on its close code; the user confirms that is wrong and
    that firing on open instead is the wanted outcome. The smoke detector's
    unverified 0x2 nibble is assumed correct, but keeps its test since no live
    traffic would reveal a regression.
2026-09-23 feat: sensor event families — match on 20 bits, act on the nibble
    A Kerui packet is 24 bits: the top 20 are the sensor's identity, the bottom
    4 are an event code. The system treated the whole value as the identity, so
    one physical sensor appeared as several unrelated "sensors" depending on
    what it did. A tamper (0x0061DB) did not match its own paired motion code
    (0x0061DA) and was logged as an unpaired sensor — invisible to every rule
    and every alert. onSensorEvent read data.event === "tamper" while the
    firmware hardcoded "trigger", so the tamper path had never once run.
    Matching now uses the 20-bit family in all three layers. The FULL code is
    still what /events/{rfId} is keyed by: the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
2026-09-24 chore(functions): rollout scripts for the sensor-families migration
    Three read-only-or-safe operational scripts written during the rollout,
    plus the package-lock that the tsx devDependency needed.
    - checkSirenAddress: pre-flash gate for the EEPROM magic bump. The siren
    address is write-only device->cloud, so if the cloud does not have it,
    flashing loses the physical pairing for good.
    - dumpConfigInputs: shows exactly what buildRtdbConfig reads, so a stale
    device config is diagnosed from data rather than guessed at.
    - touchProject: forces a config rebuild. RTDB config is derived state and
    no sensor write rebuilds it, so the familyId backfill alone leaves the
    device holding stale fu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
2026-09-24 fix(web): resolve the alarm banner's cause by family, not exact rfId
    The device writes the 20-bit FAMILY to state/alarm_cause — rules match on
    the family, so that is what it knows fired. The sensor name map is keyed by
    the full 24-bit rfId, so the exact lookup missed and the banner degraded to
    a bare "0x4D6A7" instead of the sensor's name.
    Falls back to a family comparison when the exact lookup misses, keeping the
    exact path first so a server label or an older full-width device write still
    resolves. normaliseFamilyId is tried before familyIdOf because the cause is
    usually already a family, and shifting one twice matches nothing.
2026-09-24 fix(firmware): populate familyId and eventNibble in the decoded packet
    Cc1101Receiver::poll set only sensorId, leaving the familyId and eventNibble
    fields of KeruiPacket untouched. The caller declared the struct without an
    initializer, so the packet log printed whatever was on the stack: the same
    sensor logged two different 32-bit families (0xC19DF83E, then 0x3FC947F0)
    and a 6-bit nibble of 0x3E.
    Cosmetic — dispatchSensorCode re-derives the family from sensorId and never
    read these fields, so alarm matching was always correct. But the log is the
    tool used to diagnose RF problems, and it was actively lying.
    poll() now fills both, and the call site value-initialises the struct so a
    future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
    [cc1101_receiver.cpp, main.cpp]
2026-09-25 fix(web): guard pairing against double-submit; drop the battery Today button
    Two clicks on Save 1.5s apart paired family 0x309A0 twice on 2026-09-25:
    addDoc mints a fresh id every call, so the second click created a second
    sensor doc AND a second immediate rule in every profile. Nothing upstream
    deduplicated it — the thin RTDB config happens to emit a SET of families, so
    the device was never double-armed, but the sensors list showed a twin.
    Three parts:
    - pairGuard.ts: isAlreadyPaired() compares by 20-bit FAMILY, so pairing a
    sensor's tamper code when its motion code is already paired is refused as
    the same physical device. Pure and unit-tested (11 cases), including the
    pre-migrati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
2026-09-27 feat(web): show event times to the second in the timeline
    Rules like count_in_window and multi_sensor are tuned from how far apart
    two triggers actually landed, and minute resolution threw exactly that
    away. The first column is now the exact clock time always; the newest row
    additionally carries "(5 minutes ago)" beside it rather than instead of
    timeOfDaySeconds is separate from timeOfDay because the latter also feeds
    the sensors tab's "last seen", where a second is noise. relativeSuffix
    returns null past 24h instead of formatRelative's date-and-time fallback,
    which would repeat the timestamp it sits next to.
    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
2026-10-03 docs: design for camera snapshots on sensor trigger
    Device (ESP32-S3) grabs JPEGs from the Xiongmai NVR over DVRIP and uploads
    to Firebase Storage; a Storage-triggered function judges (swappable model,
    armed-only) and delivers to timeline + Telegram. Capture every trigger,
    all channels; retention via the doSchedule table. Secrets kept out of the
    tracked spec (in private memory only).
2026-10-03 docs: revise camera-snapshot design — judge as advisory, not authority
    - NVR usage tri-state (off / capture / capture+judge), cloud-level config
    - Optional per-sensor channel mapping; out-of-sight sensors never captured
    - Judge becomes advisory to the autonomous device: 'safe' -> false-positive
    message over the existing poll path stops the current siren; 'breach' ->
    confirmed-breach Telegram. Alarm never depends on or waits for the cloud
    - Per-trigger advisory scope; no offline capture
    - Secrets kept out of the tracked spec
2026-10-03 docs: record NVR on-board AI as considered-and-deferred
    Probed the NVR's own human/PEA detection (present but disabled, event stream
    subscribable). Deferred: cheap Xiongmai on-box detection is unreliable outdoors
    and must not be the alarm-suppression authority. Cloud vision judge stays the
    authority; NVR config left untouched. Decision + rationale captured.
2026-10-03 docs: implementation plan for camera snapshots on sensor trigger
    21 bite-sized TDD tasks across 6 phases: Storage setup, firmware DVRIP
    (pure+native-tested) + capture/upload/advisory, cloud judge + onSnapshotUploaded,
    web config+timeline, retention, and a hardware soak with explicit advisory
    safety checks. Secrets kept out of tracked files.
2026-10-03 fix(storage): scope snapshot rules by device claims, not uid
2026-10-03 feat(firmware): DVRIP frame + login/OPSNAP payload builders
2026-10-03 feat(firmware): parse NVR connection + per-sensor camera config
2026-10-03 feat(firmware): CameraClient capture gate (tested) + DVRIP grab (hardware)
    Split across two files instead of one #ifdef'd file, matching this
    project's native/hardware separation: [env:native] uses an allowlist
    build_src_filter in platformio.ini, so a file simply isn't compiled
    natively unless added to it. camera_gate.{h,cpp} holds the pure
    shouldCapture/channelsFor logic (added to the allowlist, tested by
    test_camera_gate) and camera_client.{h,cpp} holds the hardware-only
    DVRIP grab() over WiFiClient (left out of the allowlist; compiles only
    under [env:esp32s3]).
2026-10-03 fix(firmware): feed watchdog across capture loop; add {projectId}/snapshots path prefix
    [cloud_client.cpp, main.cpp]
2026-10-03 feat(types): NVR/judge project config + per-sensor camera fields
2026-10-03 feat(functions): project NVR config + per-sensor camera flags in device config
2026-10-03 feat(functions): onSnapshotUploaded — timeline, armed-gated judge, advisory/breach delivery
2026-10-03 feat(web): per-sensor out-of-sight + camera channel config
2026-10-03 fix(functions): run onSnapshotUploaded in us-east1 to match the bucket region
    A Storage-triggered function must run in the same region as its bucket; the
    bucket is us-east1 (kept in the US for the free tier) while every other
    function stays europe-west1.
2026-10-03 fix(web): omit blank optional NVR fields instead of sending undefined to Firestore
    updateDoc() rejects any field whose value is undefined; validateNvrSettings was
    spreading judgeModel/judgePrompt/nvrHost/etc as undefined when left blank, so
    saving the Camera tab threw 'Unsupported field value: undefined'. Build the
    payload with only defined keys; add a test asserting no field is undefined.
2026-10-03 feat: camera snapshots on trigger — full pipeline
    Device grabs a JPEG from each live NVR channel (DVRIP OPSNAP) on every
    armed trigger, uploads to Firebase Storage. onSnapshotUploaded augments
    the Firestore timeline; the Events page joins snapshot docs onto event
    rows with a channel-gallery modal (Browse button, all channels shown,
    active one pushed in).
    capture+judge mode: onSnapshotUploaded calls Anthropic Vision API and
    either sends a Telegram breach photo or writes a false-positive advisory
    to commands/fp. Deployed; not yet exercised on a real armed trigger.
    Manual Capture button in Operations writes commands/capture (same
    nonce-change pattern as pair). Device polls it and grabs all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
2026-10-03 feat(web): add host/port help text to Camera tab
2026-10-03 a 3d model for a case
    [alarm_hub_enclosure.scad]
2026-10-04 feat: camera names + per-sensor multi-camera selection
    Name each NVR channel, and let a sensor trigger any subset of cameras
    (none / one / several) instead of exactly one-or-all.
    Camera names
    - projects/{projectId}.cameraNames, a {"1":"Front door"} map beside the
    other NVR settings. Display-only: the device captures by channel
    NUMBER and never receives them, so cameraNames is deliberately left
    OUT of onProjectConfigChange's rebuild guard.
    - Editable in two places: the Camera tab (all 8 channels, so a camera
    can be named before any snapshot exists) and behind the pencil in the
    Events gallery modal (just the channels in that snapshot set, since
    that is the only place you can see w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
2026-10-04 feat(web): camera picker as a dropdown; Camera column after Event
    Replaces the per-sensor checkbox column with a dropdown multi-select, and
    moves the Events table's Camera column from last to just after Event.
    MultiSelect component
    - A trigger button showing the current selection, opening a panel of
    checkboxes. Eight inline checkboxes per sensor row dominated the table;
    the trigger now shows the selection at a glance and costs no clicks to
    read.
    - NOT a native <select multiple>: that requires Cmd/Ctrl-click for a
    second option, and a plain click on another option silently clears the
    rest — a trap for a picker whose normal case is "this sensor watches
    the front door AND the dri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
2026-10-04 docs: design for Pushover as a second notification channel
    Mute (the ringer switch) silences every Telegram notification regardless of
    chat or Focus settings; only an app holding Apple's Critical Alerts
    entitlement can play through it. Pushover has that entitlement and applies
    it to priority 1 and 2.
    Design adds a per-project Pushover channel alongside Telegram, routed
    through one notify() dispatcher that replaces nine duplicated
    token-and-chatId gates. Credentials go in a server-only
    projects/{id}/secrets/notify subcollection -- per-project, since they
    identify who gets woken, but off the member-readable project doc.
2026-10-04 feat(functions): Pushover sender
    Pushover holds Apple's Critical Alerts entitlement, so priority 1 and 2
    play at full volume through a muted ringer -- which no Telegram setting can
    do. Priority 2 also repeats until acknowledged.
    Priority 2 requires retry and expire or Pushover rejects the message, so
    pushoverBody adds them unconditionally, clamped to the API bounds. Pinned
    by test: a silently-unsent alarm is the failure that matters.
    url/url_title carry the PWA deep link.
2026-10-04 feat(functions): notify() dispatcher for multi-channel alerts
    Replaces nine duplicated token-and-chatId gates with one seam. Channels
    dispatch concurrently via allSettled with per-channel failure isolation:
    a Telegram outage must not cost a Pushover alarm, or vice versa.
    notify() never throws -- deviceLiveness and deadSensorCheck latch their
    alert markers only after a successful send.
    ./admin is imported lazily, inside the function and only when a channel
    needs Firestore: a top-level import initialises the Firebase app, which
    throws "Can't determine Firebase Database URL" under vitest. That is why
    no other unit test in this codebase imports ./admin.
2026-10-04 refactor(functions): route arm/disarm notices through notify()
    All three passed silent: true, which severity "notice" now names.
2026-10-04 refactor(functions): route alarm and sensor alerts through notify()
    Alarms get severity "alarm" (Pushover priority 2, repeats until
    acknowledged); sensor alerts get "loud" (priority 1, audible through mute,
    single shot). Both carry the PWA deep link.
    serverActions.sendTelegram is preserved: despite the name it means "notify
    when the siren is suppressed" and is independent of notifyChannels.
2026-10-04 refactor(functions): route liveness, dead-sensor and breach through notify()
    Removes the per-project credential gates that made the scheduled loops skip
    projects using Pushover only.
    device-back-online is reclassified loud -> notice: under the Pushover
    mapping, loud would fire a Critical Alert through a muted phone to report
    that everything is fine.
    Breach keeps its Telegram photo and gains a channel-independent text alert,
    which also fixes a real gap: a breach on a project without Telegram
    credentials previously returned early and alerted nobody. notify is
    injected through SnapshotUploadDeps rather than vi.mock'd, matching this
    module's existing pattern.
    telegramWebhook.ts is deliberatel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
2026-10-04 docs: design for per-sensor breach certainty and judge escalation
    Per-sensor definiteBreach picks the alarm notification tier: definite ->
    Pushover priority 2 (repeats), non-definite -> priority 1 (audible through
    mute, single shot). A breach verdict on a non-definite sensor escalates to
    priority 2; a safe verdict adds a silent all-clear.
    Cloud+web only: onAlarm fires on siren_active, which both the device and
    server write, so no firmware change and no EEPROM magic bump.
    Records two things found while reading the code: a server-written
    alarm_cause carries no rfId, so onAlarm cannot currently identify the
    causing sensor (fixed here); and that same gap means the judge never runs
    on server-ev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
2026-10-04 docs: derive a multi-sensor rule's certainty from its members
    Corrects the earlier draft, which defaulted multi-sensor rules to definite
    on "several conditions at once is stronger evidence" grounds. That was
    backwards: such a rule exists precisely BECAUSE its members are
    individually inconclusive -- a definite sensor would already fire via its
    own immediate rule.
    A rule is now definite iff EVERY member is definite. All, not any: the
    condition is an AND, so the weakest member governs what the combination
    proves. Rule.sensors names the members and onAlarm already loads both
    sensors and rules, so this needs no extra reads.
    Genuine unknowns (unresolvable rfId, tamper label, no covering rule) s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
2026-10-04 docs: implementation plan for per-sensor breach certainty
    7 tasks, TDD where the code is testable. All certainty logic lands in a
    pure breachCertainty.ts (27 tests) because onAlarm and onSensorEvent are
    thin wrappers this codebase deliberately leaves to smoke tests.
    Includes the deployment and the end-to-end check that is the only thing
    able to prove the escalation path: trigger a non-definite sensor with a
    person in frame and expect loud-then-emergency.
2026-10-04 feat(functions): per-sensor breach certainty rules
    Absent definiteBreach means DEFINITE, encoded in one place so the fail-loud
    default cannot drift between readers.
    A rule is definite iff EVERY member is definite -- all, not any, because a
    multi_sensor condition is an AND and the weakest member governs what the
    combination proves.
2026-10-04 feat(functions): resolve an alarm cause to a certainty tier
    Keyed on the cause's rfId, not its label: a label is free text naming a
    rule, and only the rfId identifies a sensor whose flag can be read.
    A covering rule's members decide when one exists, so a multi_sensor rule
    with any non-definite member is non-definite. Unknowns -- no cause,
    label-only (tamper), or an unmatched rfId -- all fail loud.
2026-10-04 feat(functions): record the rfId on server-written alarm causes
    A server cause carried only a label, so onAlarm could not identify the
    sensor whose breach certainty decides the notification tier.
    Side effect, deliberate and worth knowing: onSnapshotUploaded's armed gate
    compares the cause's FAMILY to the snapshot's, and a label-only cause has
    none -- so the AI judge never ran on a server-evaluated alarm at all. It
    now does, which is also what makes judge escalation reachable for a
    non-definite sensor alarming via a server rule.
    No type or parser change needed: AlarmCause already declares both fields
    optional and parseCause keeps whichever are present.
2026-10-04 feat(functions): onAlarm picks the tier from the sensor's certainty
    resolveLabel becomes resolveCause and returns both the display label and
    the certainty: the two need the same sensor and rule lookups, and doing
    them twice would double the Firestore reads on the alarm path.
    Removes the early return on a server-written label. That shortcut skipped
    both lookups, which the certainty decision needs now that the server sends
    rfId alongside label. resolveCauseLabel still prefers the label, so the
    displayed text is unchanged.
    Definite -> priority 2 (repeats). Non-definite -> priority 1, audible
    through mute but single-shot, which the judge can escalate.
2026-10-04 feat(functions): judge escalates a non-definite breach, all-clears a safe one
    A breach verdict on a non-definite sensor is now the escalation to
    priority 2 -- the first emergency push for that event. On a DEFINITE
    sensor it stays priority 1, because onAlarm already sent a repeating
    emergency and two would be worse than one.
    A safe verdict adds a silent priority -1 all-clear, so a glance at the
    phone explains the earlier alert. Not sent on the alreadyHasBreach path,
    where it would contradict a standing alarm.
    Updates test (e), whose severity assertion encoded the old unconditional
    "alarm". Its fixture has no definiteBreach field, so it defaults to
    definite and the breach confirmation is cor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
2026-10-04 feat(web): per-sensor Definite breach checkbox
    Ticked (and the default for an unconfigured sensor, since absent means
    definite) sends a repeating emergency push on alarm. Unticked sends a loud
    single alert the AI judge can escalate.
    Writes an explicit boolean rather than omitting the field: absent means
    definite, so clearing the box must store false.
2026-10-04 docs: per-sensor breach certainty
    Records the NVR blind spot explicitly: a non-definite alarm with no judge
    verdict stays at priority 1 forever, by choice, with the siren as the only
    backstop.
2026-10-04 fix(firmware): read RSSI from the status register, report dBm
    poll() read RSSI (0x34) with readReg() -- a single access (0x80), which
    addresses the CONFIGURATION register space. 0x34 is a STATUS register and
    needs the burst bit (0xC0), so every packet from every sensor reported the
    same constant rssi. MARCSTATE a few lines above always used
    readStatusReg(); this did not.
    Now readRssiDbm() uses readStatusReg() and applies the datasheet transform
    (halve, offset -74), so consumers get real dBm instead of a raw byte --
    the serial log, the RTDB event and the web UI all already type it as a
    signed int/number, so negatives need no other change.
    Found while diagnosing a door sensor decoding only i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
    [cc1101_receiver.cpp, cc1101_receiver.h]
2026-10-04 fix(functions): certainty from the sensor, not the rule; send a Pushover sound
    The rule lookup was non-deterministic. resolveCauseCertainty took
    rules.find(...) -- the FIRST rule containing the sensor -- but rule
    membership is not exclusive: in this project's live config a sensor sits in
    a 1-member count_in_window AND a 2-member multi_sensor rule at once, so
    Firestore's arbitrary document order decided the notification tier. The
    same sensor could alert at a different priority on each trigger.
    Nor is deriving from the FIRING rule implementable: alarm_cause records
    "ct", a condition TYPE index, not a rule id.
    So the tier now comes from the causing sensor's own definiteBreach --
    deterministic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
2026-10-04 docs: certainty is per-sensor, not per-rule; Pushover sound config
    Marks the spec's multi-sensor section SUPERSEDED rather than editing it
    away: it was implemented, deployed and reverted the same day, and the
    reasoning is worth keeping next to why it failed.
    Records in CLAUDE.md that reintroducing a rule lookup is a mistake, with
    both reasons -- non-exclusive rule membership, and alarm_cause.ct being a
    condition type index rather than a rule id.
    Also records that only five Pushover sounds loop, which is the actual
    explanation for "the emergency alert does not keep sounding".
2026-10-04 fix(functions): non-definite alerts no longer break through mute
    "loud" mapped to Pushover priority 1, but Pushover applies Apple's
    Critical Alerts entitlement to priority 1 as well as 2 -- so a
    non-definite sensor's alert overrode a muted ringer exactly like a
    confirmed breach. With a looping sound the two tiers were
    indistinguishable by ear.
    "loud" is now priority 0: a normal notification that respects mute and Do
    Not Disturb. Breaking through silence is reserved for "alarm" -- a
    definite sensor, or the judge escalating a non-definite one.
    COST, accepted and documented: with no judge verdict (NVR down, nvrMode
    not capture+judge, or no cameras on the sensor) a non-definite alarm is
    now SI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
2026-10-04 fix(functions): judge never ran on hardware -- cause family was shifted twice
    onSnapshotUploaded's armed gate derived the cause's family with
    familyIdOf(), which shifts a full 24-bit rfId down to its 20-bit family.
    But /{projectId}/state/alarm_cause carries TWO shapes: the server writes
    the full rfId ("0x009BFA") while the DEVICE writes the already-shifted
    family ("0x009BF"). Running the device's value through familyIdOf shifted
    it a second time -- "0x009BF" became "0x0009B" -- so the comparison against
    the snapshot's real family never matched.
    Every device-triggered alarm therefore logged "no fresh matching
    alarm_cause" and skipped the judge. That is why the AI judge has never
    worked on re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
2026-10-04 docs: judge escalation verified on hardware
    An armed trigger on a non-definite sensor captured both cameras, Gemini
    judged a person present, and the alarm escalated from P0 to a repeating P2
    emergency. First time the AI judge has run on real hardware.
    Records the three fixes it took: nvrMode config, the cause-family double
    shift that had always skipped the judge for device-written causes, and
    "loud" dropping from priority 1 to 0 so the non-definite tier stops
    overriding mute.
    Next list updated: the breach path is confirmed, the SAFE path is not.
    Also notes that 7 of 17 sensors still have no definiteBreach set and
    therefore default to breaking through mute (verified against Firestore,
    not e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
2026-10-04 docs: RSSI fix verified on hardware
    -67/-70 dBm from sensor after flash, vs constant 31 before.
    Values reach RTDB. 3s per-code dedup window noted for testing.
2026-10-04 docs: judge safe path verified on hardware
    תנועה דלת מחסן, nobody in frame: false positive verdict,
    no P2 escalation, commands/fp written. Both paths confirmed.
2026-10-05 refactor: merge Preferences into Configure, generalise Telegram to notify
    Two leftovers from when Telegram was the only channel.
    PLACEMENT. /settings (labelled "Preferences" / "העדפות") is gone; the
    route redirects to /configure. Configure went 5 tabs -> 7, adding General
    (name, timezone) and Notifications (channels, credentials, Pushover
    tuning, notify-every-trigger, send-notification-on-alarm, battery age).
    The Siren tab gained a third card for duration + server-triggers-siren,
    so everything siren-related is in one place.
    Save is per CONTROL, not per tab: a checkbox or <select> saves on change
    (toast confirms, local state reverts if the write fails), while text and
    number inputs st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
2026-10-05 feat(rules): optional min_gap_sec on count_in_window
    A PIR re-triggering on its own stimulus is ONE physical event, but a bare
    count_in_window counts that echo as corroboration. The 2026-10-05 05:52
    false alarm was exactly this shape: sensor 0x009BFA fired at 05:52:55 and
    again 6s later, satisfied its 2-in-30s rule, and the AI judge then found
    both camera channels empty ("an artifact or insect near the lens").
    Measured on that sensor's own 992 events: the median gap between the 1st
    and 2nd trigger of a burst is 10s, and 51% of multi-trigger bursts are
    <=10s. So the echo, not a second intruder pass, is what satisfies these
    rules in practice.
    min_gap_sec requires two triggers to be at least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
2026-10-05 feat(notify): judge-gated alerting for non-definite sensors
    On 2026-10-05 a non-definite sensor alarmed at 05:52:55, the P0 alert went
    out at 05:53:05, and Gemini reported both camera channels empty at
    05:53:06 -- one second later. The owner was woken and then reassured.
    With judgeWaitSec > 0, onAlarm now sends NOTHING for a non-definite sensor
    whose cameras can actually produce a verdict, and the verdict itself is the
    announcement: breach escalates to P2, safe sends the silent all-clear. A
    false positive never wakes anyone.
    Gating (judgeDefer.ts, pure + tested): defers only when the project opted
    in AND the sensor is explicitly non-definite AND nvrMode is capture+judge
    AND the sensor has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
2026-10-05 feat(siren): hold the siren for non-definite sensors pending AI verdict
    Completes judge-gated alerting: the notification half (previous commit)
    stopped a false positive waking you, this stops it waking the street.
    A non-definite sensor's siren is now DELAYED by Config::sirenHoldSec while
    the cloud's AI judge looks at the snapshots. A matching false-positive
    advisory cancels it; a disarm cancels it; otherwise it fires.
    THE HOLD EXPIRES AND FIRES, and that is the whole design. Waiting
    indefinitely for a cloud verdict would mean no siren during a real
    break-in whenever WiFi, the NVR or the judge is down -- breaking "alarm
    logic never depends on the cloud" (CLAUDE.md). tickPendingSiren() sound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
2026-10-05 docs: record the false-alarm suppression work and its flash gate
    CLAUDE.md Status gains the 2026-10-05 entry (min_gap_sec, judge-gated
    notification, siren hold) with the measurements the decisions rest on: the
    10s median / 51%-under-10s burst distribution that makes a bare
    count_in_window count a PIR's own echo, and why min_gap needs a wider
    window rather than the default.
    Flagged for whoever flashes: EEPROM magic BB -> BC with the MEASURED
    sizeof(Config) 2632 -> 2664, the check:sirenAddress result (0x93CF80 in
    both Firestore and RTDB) that clears the bump, and the deploy order
    (functions before web; flashing independent of both, since an unflashed
    device just ignores sh/nd).
    Next list: th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
2026-10-05 docs: stop treating an EEPROM magic bump as a crisis; firmware flashed
    Flashed 0xA1A2B3BC to the S3 today. The siren address survived, as it has
    every bump since RtdbConfig.s became the recovery path -- seven bumps now
    (B5->B6->B7->B8->B9->BA->BB->BC). The single documented loss predates that
    path entirely.
    The warnings had not kept up. Three copies of "run check:sirenAddress or
    the physical siren pairing is lost" in CLAUDE.md, plus "THE SIREN ADDRESS
    MUST SURVIVE THAT BUMP ... the one irreversible failure here" in
    alarm_state.h and "the siren address is the casualty of any bump here" in
    eeprom_store.h -- the latter directly contradicted by the next sentence,
    which names the recovery path.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
    [alarm_state.h, eeprom_store.h]
2026-10-05 docs: spec the judge as evidence rather than a filter
    Two problems found on hardware today, one a bug and one a limitation of the
    idea behind the current design.
    The bug: onSnapshotUploaded judges a snapshot only when a fresh alarm_cause
    matches it, but for a count_in_window rule that is never the trigger whose
    images exist. Trigger 1 captures and does not alarm (count unmet, so no
    cause, so not judged); trigger 2 alarms but is inside captureCooldownSec so
    has no images. With cc:25 and w:30 every qualifying pair lands this way, so
    the judge never runs. Measured three times today -- "no fresh matching
    alarm_cause ... skipping judge" -- and the trigger that did alarm had no
    snapshot at all. T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
2026-10-05 docs: extend breach_satisfies to multi_sensor, decide commands/breach and overlap resolution
    Three decisions, driven by the overlaps actually present in this project's
    default profile (queried, not assumed):
    חלון מרפסת 0x516A09 count_in_window(n=2,w=30,g=15) + multi_sensor
    תנועה דלת כניסה 0x0061DA count_in_window(n=2,w=30,g=15) + multi_sensor
    תנועה כניסה מערבה 0x00927A multi_sensor x2, NO count_in_window
    1. multi_sensor is now IN SCOPE, and a breach on one participant satisfies
    the WHOLE rule rather than just that participant. Same logic as the count:
    the AND exists because one PIR is noisy, and vision removes exactly that
    noise. Sat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
2026-10-05 feat(judge): pure logic + commands/breach parser for judge-as-evidence
    Spec approved; this is the foundation layer -- pure, tested decision logic
    plus the device-side wire format. No behaviour is wired up yet, so nothing
    changes in production.
    judgeGate.ts (17 tests), three decisions kept out of onSnapshotUploaded so
    they are testable without the emulator:
    - shouldJudge: the gate becomes ARMED, not "did this trigger alarm". The old
    alarm_cause-matching gate made the judge structurally unreachable for
    count_in_window rules -- trigger 1 captures with no cause yet (count unmet),
    trigger 2 alarms but is inside the capture cooldown so has no images.
    - reusableVerdict: the reuse window is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
2026-10-05 feat(judge): judge every armed trigger, raise alarms via commands/breach
    Wires the approved spec into onSnapshotUploaded.
    The armed gate changes from "did THIS trigger alarm?" to "was the system
    armed?". The cause is still read, but only to decide what to DO with a
    verdict -- never whether to form one. This is the fix for the bug found on
    hardware: for a count_in_window rule, trigger 1 has no alarm_cause yet (the
    count is unmet) and trigger 2 is inside the capture cooldown so has no
    images, so the judge could never run for the episode at all.
    On a breach verdict with no rule alarm, if any condition covering the sensor
    sets breach_satisfies, the cloud writes /commands/breach = {rfId, ts, at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
2026-10-05 feat(judge): verdict reuse, breach_satisfies UI, device commands/breach
    Completes the judge-as-evidence implementation.
    VERDICT REUSE landed in onAlarm, not onSnapshotUploaded, and the reason is
    worth recording: the capture cooldown is enforced on the DEVICE, so a trigger
    inside it produces no snapshot at all and onSnapshotUploaded is never invoked
    for it. The place that runs for an alarm with no images of its own is onAlarm.
    So the alarming trigger of a count_in_window episode inherits the verdict
    taken on trigger 1: safe -> write commands/fp and send only a silent
    all-clear; breach -> skip the deferral and notify at emergency immediately.
    Verdicts are read from the snapshotJudging docs,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
    [cloud_client.cpp, cloud_client.h, main.cpp]
2026-10-05 fix: one timestamp per trigger, so snapshots join their event row
    Found by the user spotting a real sensor trigger labelled "צילום ידני"
    (manual capture) in the Events list at 19:24:44.
    The data was fine -- rfId 0x0061DA, correct sensorId, correct name. The join
    was wrong. A timeline doc is matched to an event row by {rfId, ts}, and those
    two timestamps came from SEPARATE time(nullptr) reads on the device:
    handleSensorEvent computed triggerTs for the snapshot path, then reportEvent
    read the clock again for the /events key. A trigger straddling a second
    boundary therefore wrote keys 1000ms apart, the join missed, the timeline doc
    looked like an orphan, and the UI renders orphans as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
    [cloud_client.cpp, cloud_client.h, main.cpp]
2026-10-05 docs(readme): document minimum gap, camera evidence, and the verdict holds
    The README described the judge as "deployed but not yet exercised on a real
    armed trigger" and claimed 143 native tests. Both stale, and none of the
    options added over the last few days were documented at all.
    New "Cameras and the AI judge" section covers the three NVR modes, what each
    verdict does, where the API keys live and why they are off the member-readable
    project document, and the per-sensor certainty matrix.
    Two new rule options documented under Alarm rules:
    - Minimum gap, with the measurement that justifies it (median 10s between the
    1st and 2nd trigger of a burst, 51% of bursts under 10s on one sensor'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
2026-10-08 feat(ota): over-the-air firmware updates with rollback
    publish:firmware builds the esp32s3 image, uploads it to Storage under
    firmware/{version}/ and points Firestore firmware/latest at it. The
    admin-only Firmware card on Operations offers Install when that release
    sorts after the version the device reports in state/boot.fw, and writes
    commands/ota.
    The device downloads in ~40ms slices inside loop(), so RF decode and the
    siren keep running, and Update.end() refuses the image unless its md5
    matches. A new image boots pending-verify (verifyRollbackLater() is
    overridden) and is marked valid only once the cloud is ready and config
    received; otherwise it reverts within 10 minutes, and the previo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
    [alarm_state.cpp, alarm_state.h, cloud_client.cpp, cloud_client.h, fw_version.h, fw_version.py, main.cpp, ota_command.h]
2026-10-08 feat(camera): setting to skip trigger snapshots while disarmed
    The device grabbed snapshots on every trigger of a sensor with cameras,
    armed or not. projects/{id}.captureWhenDisarmed (Configure -> Camera,
    saved on change) turns that off: the cloud emits `cd: 0` in the RTDB
    config and CameraGate::shouldCapture then requires the system to be armed
    or the trigger to have raised an alarm (an `always` rule firing while
    disarmed). Absent means true, so nothing changes until it is unticked;
    `cd` is only emitted when false. Manual capture is unaffected.
    The bool fits Config's existing padding (sizeof unchanged at 2664), so no
    EEPROM magic bump.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
    [alarm_state.h, camera_gate.cpp, camera_gate.h, config_parser.cpp, main.cpp]
2026-10-10 feat(notify): one emergency per episode; Pushover device targeting
    Forgetting to disarm on 2026-10-09 produced three repeating emergencies
    for one event (front door, then two judge breach confirmations). notify()
    now claims a 5-minute window per project on every "alarm" severity
    (transactional marker at projects/{id}/notifyState/emergency); later
    emergencies in the window are not sent on any channel, and the Telegram
    breach photo is skipped with them. A disarm clears the window. A marker
    failure sends the emergency anyway.
    Pushover: optional comma-separated device list stored beside the user key
    in secrets/notify, edited in Configure -> Notifications and sent as the
    `device` parameter. Blan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
